plastikpamaro/bachelorprojekt2020/Codes/Studienarbeit(Max)/RASPI/Backup 02-14/bcm2835-1.62/README

This is a C library for Raspberry Pi (RPi). It provides access to 
GPIO and other IO functions on the Broadcom BCM 2835 chip.
allowing access to the 
26 pin ISE plug on the RPi board so you can control and interface with various
external devices.
