plastikpamaro/bachelorprojekt2020/Dokumentation/titlepage.tex

% Titelseite    
\newpage
\thispagestyle{empty}
\AddToShipoutPicture*{\BackgroundPic}

\newgeometry{top=0.6cm, bottom=2.04cm, left=2.24cm, right=2.24cm}

\begin{center}

\begin{tabular}{p{3cm}p{8cm}p{4cm}}
&\textcolor{red}{\LARGE{ }} & \vspace{-0.5cm} \\
\end{tabular}

\begin{tabular}{p{5cm}p{10.5cm}}
&\\
&\\
\end{tabular}

\end{center}

\vspace{7cm}

\begin{flushright}
\begin{Huge}
\textbf{Dokumentation Bachelorprojekt} \\
\end{Huge}
\vspace{2cm}
\Large{Heiko Nöldeke, Marc Bolsch, Pascal Roschkowski, Philipp Otto} \\
\vspace{0.5cm}
\LARGE{\textbf{Entwurf und Ausarbeitung eines \\ Traffic-Noise-Detector-Prototypen}}
\end{flushright}
\vspace{8cm}

\begin{center}
\begin{tabular}{lp{2cm}r}
Fakultät Technik und Informatik && Faculty of Engineering and Computer Science \\
Departement Mechatronik && Departement of Mechatronic Engineering \\
\end{tabular}
\end{center}

\newpage
\restoregeometry

\ClearShipoutPicture
