plastikpamaro/bachelorprojekt2020/Dokumentation/impressum.tex

\thispagestyle{empty}
\newgeometry{top=6cm, bottom=2.04cm, left=2.24cm, right=2.24cm}

\begin{center}
\Large{\textbf{Heiko Nöldeke, Marc Bolsch, Pascal Roschkowski, Philipp Otto}} \\  
\vspace{1.5cm}
\LARGE{\textbf{Traffic-Noise-Detector-Prototyp}}
\end{center}

\vspace{14cm}

\begin{tabular}{l}
Bachelorprojekt eingereicht im Rahmen der Bachelorprüfung \\
\\
im Studiengang Mechatronik \\
am Departement Fahrzeugtechnik und Flugzeugbau \\
der Fakultät Technik und Informatik \\
der Hochschule für Angewandte Wissenschaften Hamburg\\
\\
Erstprüfer: Prof. Dr. Rasmus Rettig\\
\\
Abgabedatum: \today
\end{tabular}

\newpage
\restoregeometry
