plastikpamaro/bachelorprojekt2020/Dokumentation/Sections/Programmierung/Programmierung.tex

\section{Programmierung}

\subsection{Beweisführung}

Da ist sich bei dem von uns entwickeltem System um einen Prototypen für ein nutzbaren TND handelt, hat eine aussagekräftige Beweisführung der Geräusch-Lokalisierungen eine hohe Priorität. Zum Vorbild genommen wurden dafür herkömmliche Blitzeranlagen aus dem Straßenverkehr, bei denen ein Beweisfoto aufgenommen wird und Metadaten über die gemessene Geschwindigkeit abgespeichert und übermittelt werden.

Das eigentliche Foto wird mithilfe eines \glqq Raspberry Pi 4\grqq\ Kameramodul aufgenommen, bearbeitet und mit einem Zeitstempel versehen abgespeichert. 

Der hierzu verwendete Programmablauf lässt sich folgendermaßen beschreiben: 

\begin{figure}[!h]
	\begin{center}
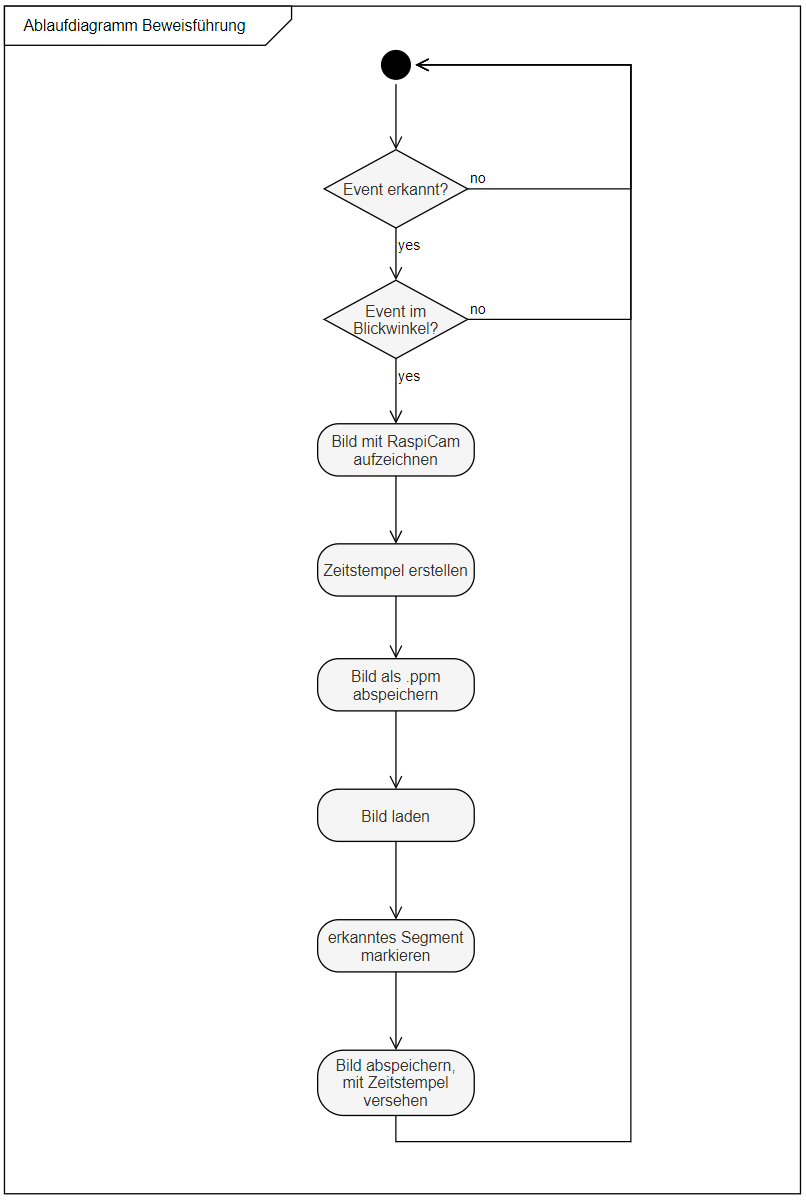
[picture p1: Dokumentation/Sections/Programmierung/Beweisführung.png]
		
	\end{center}
	\caption{Beweisführung}
	\label{fig:Beweisführung}
\end{figure}

Die Beweisführung startet, wenn ein definierter Pegel überschritten wird und die Quelle des Geräusches ermittelt wurde. Da die Kamera nur einen Betrachtungswinkel von \ang{60} aufweist, wird nun überprüft, ob sich die Quelle innerhalb des Betrachtungswinkels, also innerhalb des Kamerabildes befindet\footnote{https://www.raspberrypi.org/documentation/hardware/camera/ zuletzt besucht: 05. 06. 21}.

Ist dem der Fall, so wird ein Kamerabild aufgezeichnet und ein Zeitstempel erstellt. Um die Komplexität des Systems möglichst gering halten zu können, wird die Kameraansteuerung direkt in dem Hauptprogramm mithilfe einer Wrapper-Klasse realisiert. 

Diese nutzt die \glqq RaspiCam: C++ API\grqq\ von Rafael Muñoz Salinas, um die Hardware direkt in dem Programmablauf ansteuern zu können\footnote{https://www.uco.es/investiga/grupos/ava/node/40 zuletzt besucht: 05. 06. 21}. Dies erspart die zusätzliche Verwendung von Unterprogrammen. Das nun aufgezeichnete Bild wird zunächst als \glqq .ppm\grqq\ abgespeichert. 

In dem nächsten Schritt wird das abgespeicherte Bild wieder geöffnet und mit der Bildverarbeitungsbibliothek \glqq OpenCv\grqq\ bearbeitet\footnote{https://opencv.org/about/ zuletzt besucht: 05. 06. 21}. Dieser Schritt wird durchgeführt, um die errechneten Quellkoordinaten des Geräusches grafisch darzustellen. Hierbei wird das Bild in eine vorher definierte Anzahl von Segmenten (maximal 60, hier: 7) unterteilt. Die rechnerisch ermittelte Gradzahl der Quelle des Geräusches wird nun auf ein Segment im Bild bezogen. Dieses wird entsprechend farblich mit einem grünen, gut sichtbaren Rechteck markiert.

Im Anschluss wird das bearbeite Bild in einem für Windows-Betriebssysteme einfach zu lesendes Format (.png) abgespeichert. Der zu Beginn der Beweisführung aufgezeichnete Zeitstempel wird nun als Dateiname verwendet.

Die Beweisführung enthält somit: ein Foto des Fahrzeugs, ein markiertes Segment, in dem sich die Quelle des Geräusches befindet und ein Zeitstempel zu welchem Datum und Uhrzeit das Fahrzeug aufgezeichnet wurde. Wahlweise können darüber hinaus auch sämtliche, sich im Buffer befindlichen Daten, die zur Lokalisierung des Geräusches verwendet wurden in Tabellenform abgespeichert werden. Da es sich hierbei aber bei einem längeren Betrieb um erhebliche Datenmengen handelt, die den internen Speicher des \glqq Raspberry Pi\grqq\ belegen würden, wurde darauf bisher verzichtet. 

\subsection{Programmablauf}

Der Programmablauf wird in diesem Abschnitt Schritt für Schritt erklärt und anhand geeigneter Diagramme dargestellt. Zu einer genauen Übersicht des Ablaufes ist der Flowchart des Programmes (\autoref{fig:MainFlowchart}) hilfreich. Nun folgt eine chronologische Erklärung der Programmteile.

\begin{figure}[!h]
	\begin{center}
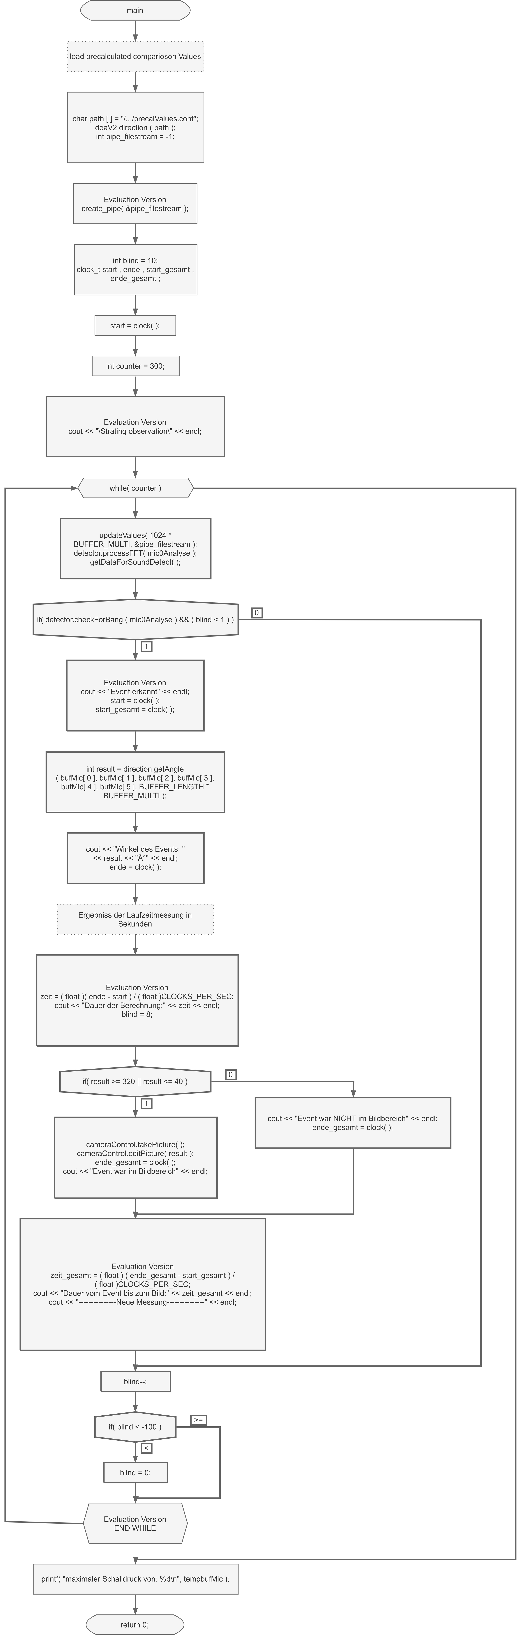
[picture p2: Dokumentation/Sections/Programmierung/MainFlowchart.png]
		
	\end{center}
	\caption{Main Flowchart}
	\label{fig:MainFlowchart}
\end{figure}

\subsubsection{doaV2}

Nach dem Programmaufruf wird die DOA Konfiguration, bestehend aus vorberechneten Werten, ausgelesen. Dies wird durch die doaV2 Klasse mithilfe der loadPrecalculatedValues Methode ermöglicht (\autoref{fig:doav2}).

Hier wird zunächst die Konfigurationsdatei geöffnet. Nun werden für alle möglichen Mikrofonpaare alle vorberechneten Laufzeiten aller möglichen Winkel eingelesen und in das Array precalculatedCompareValues abgespeichert. Zuletzt wird der Zugriff auf die Datei gestoppt. Die DOA Klasse beinhaltet auch die Berechnung des Ursprungsortes eines Geräusches, auf die im späteren Programmverlauf weiter eingegangen wird.

\begin{figure}[!h]
	\begin{center}
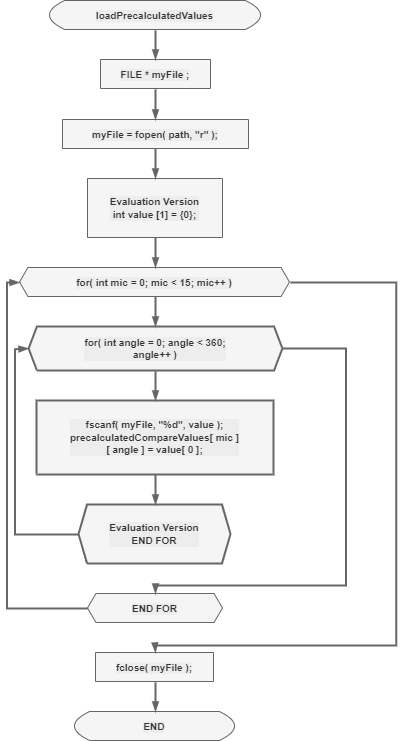
[picture p3: Dokumentation/Sections/Programmierung/doav2.png]
		
	\end{center}
	\caption{doav2}
	\label{fig:doav2}
\end{figure}

\subsubsection{create\_pipe}

Nach dem Laden der Laufzeiten wird mithilfe der create\_pipe Methode ein FIFO angelegt, mit dem die Echtzeitmessungen zur Datenverarbeitung weitergegeben werden.

\subsubsection{updateValues}

Diese Methode stellt sicher, dass der Daten-Buffer nach jedem FIFO Zyklus neu gefüllt ist. Die Methode bestimmt zuerst das Maximum an gemessenen Werten aus einem Zyklus und schreibt sie dann mithilfe der fastAddValue Methode im Signed UInt32 Format in den Speicher.

\subsubsection{processFFT}

Eine einfache \glqq Fast Fourier Transformation\grqq, die ein Array an komplexen Gleitkommazahlen ausgibt. Mithilfe dieser Fouriertransformation ist es möglich, die Intensität der Geräusche von der zwischengespeicherten Aufnahme herauszufinden, um diese zu vergleichen.

\subsubsection{getDataForSoundDetect}

Im Programmablauf folgt diese einfache Getter-Methode, um die gepufferten Daten aus dem FIFO zur Weiterverarbeitung in ein Array zu schieben.

\subsubsection{checkForBang}

Die checkForBang Methode ist eine der wichtigsten im gesamten Programmablauf und sitzt direkt in einer Bedingung. Wenn durch diese Methode ein lautes Signal bestätigt wird, fährt das Programm in der Verarbeitung dieses Signales fort.

Wie in \autoref{fig:checkForBang} zu erkennen ist, wird anfangs mithilfe der calcEnergy Methode aus derselben Klasse der Unterschied zwischen den Energieniveaus von Geräuschen ausgerechnet. Dies geschieht durch die schon erwähnte FFT. Wenn nun die errechnete Differenz den Wert 600000 (empirisch ermittelt) überschreitet, kann davon ausgegangen werden, dass ein lautes und beobachtungswertes Event stattgefunden hat, da eine sehr hohe Energiedifferenz zu vorherigen Werten gemessen wurde.

\begin{figure}[!h]
	\begin{center}
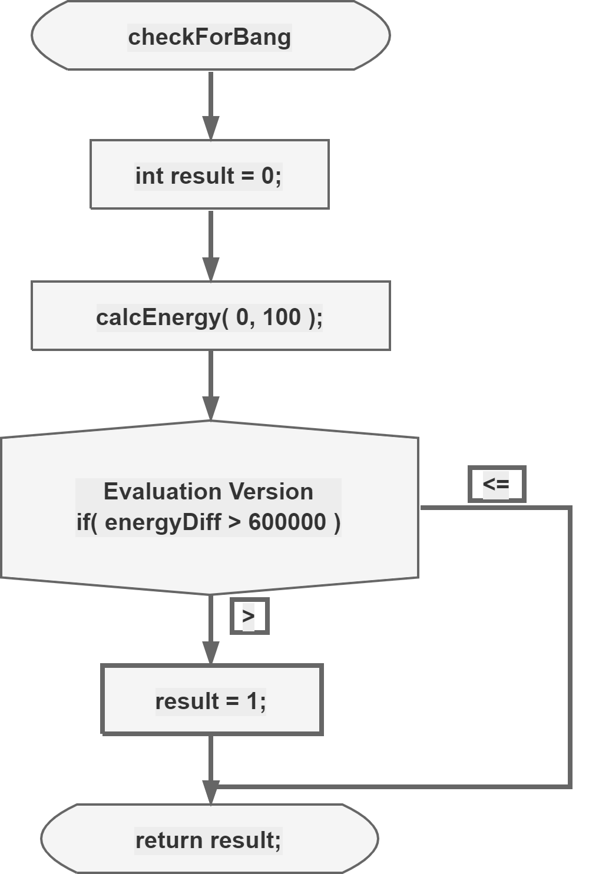
[picture p4: Dokumentation/Sections/Programmierung/checkForBang.png]
		
	\end{center}
	\caption{check for bang}
	\label{fig:checkForBang}
\end{figure}

\subsubsection{getAngle}

Diese Methode ist dafür verantwortlich, dem Geräuschevent eine eindeutige Richtung zuzuordnen, um eine Beweisführung zu ermöglichen. Sie ruft zwei weitere wichtige Methoden auf – xcorr und compareValues.

Mithilfe der vorberechneten Korrelationswerte für das Mikrofonarray kann die xcorr Methode verwendet werden, um die Korrelation zweier Signale zu finden.

Mit compareValues werden die Korrelationen verglichen und mit einer einfachen Sortierung die stärksten Übereinstimmungen gefunden, um daraus eine Richtung zu erschließen.

Mehr dazu im Abschnitt des Protokolls, dass auf die Berechnung des Winkels näher eingeht.

\subsubsection{cameraControl}

Die Klasse cameraControl benutzt, wenn sich der errechnete Winkel im richtigen Sichtfeld der Kamera befindet, zwei Methoden, um ein Foto zu erstellen und dies so zu bearbeiten, dass der Bereich der Schallquelle sichtbar wird. Mithilfe der einfachen Schnittstelle der RaspiCam und dazugehörigen Bibliotheken wird ein Bild im RGB-Format von der Kamera angefordert und abgespeichert. Nun wird mithilfe des errechneten Ergebnisses aus getAngle und OpenCV das Bild bearbeitet, indem durch mehrere else-if-Abfragen zum richtigen Bildsegment iteriert wird und dann dieses Segment mit einem Rechteck hervorgehoben wird.

\subsection{Ortung der Geräuschquelle}

Das Orten einer Schallquelle ist im Gegensatz zum Erfassen eines lauten Geräusches deutlich umfangreicher. Hierzu wird die Kreuzkorrelation zwischen allen Mikrofonen untereinander errechnet um diese als Hilfe zu benutzen, um das mathematische Maximum zu berechnen.

Die Kreuzkorrelation ist eine Messung, die die Bewegungen von zwei oder mehr Sätzen von Zeitreihen-Daten relativ zueinander verfolgt. Sie wird verwendet, um mehrere Zeitreihen zu vergleichen und objektiv zu bestimmen, wie gut sie miteinander übereinstimmen und insbesondere, an welchem Punkt die beste Übereinstimmung auftritt. Die Kreuzkorrelation kann auch jegliche Regelmäßigkeiten in den Daten aufdecken.

Betrachten wir als Beispiel zwei reellwertige Funktionen $ f $ und $ g $, die sich nur durch eine unbekannte Verschiebung entlang der x-Achse unterscheiden. Man kann die Kreuzkorrelation verwenden, um herauszufinden, um wie viel $ g $ entlang der x-Achse verschoben werden muss, damit es mit $ f $ identisch wird. Die Formel verschiebt im Wesentlichen die Funktion $ g $ entlang der x-Achse, wobei das Integral ihres Produkts an jeder Position berechnet wird. Wenn die Funktionen übereinstimmen, wird der Wert von ($ f \star g $) maximiert. Das liegt daran, dass Spitzen (positive Bereiche), wenn sie übereinstimmen, einen großen Beitrag zum Integral leisten. Ähnlich verhält es sich, wenn sich Talsohlen (negative Bereiche) ausrichten, leisten sie ebenfalls einen positiven Beitrag zum Integral, da das Produkt zweier negativer Zahlen positiv ist. Bei komplexwertigen Funktionen $ f $ und $ g $ stellt die Konjugierte von $ f $ sicher, dass ausgerichtete Spitzen (oder ausgerichtete Talsohlen) mit imaginären Komponenten positiv zum Integral beitragen.

Kreuzkorrelationen sind nützlich für die Bestimmung der Zeitverzögerung zwischen zwei Signalen, z. B. für die Bestimmung von Zeitverzögerungen für die Ausbreitung von akustischen Signalen über ein Mikrofonarray. Nach der Berechnung der Kreuzkorrelation zwischen den beiden Signalen zeigt das Maximum (oder Minimum, wenn die Signale negativ korreliert sind) der Kreuzkorrelationsfunktion den Zeitpunkt an, an dem die Signale am besten ausgerichtet sind; d. h., die Zeitverzögerung zwischen den beiden Signalen wird durch das Argument des Maximums die Kreuzkorrelation bestimmt. Diese mathematische Eigenschaft benutzen wir um mit
$ \tau= arg\ _{t \in \mathbb{R}}\ max\left(( f \star g)(t)\right) $ den zeitlichen Versatz zu errechnen.

Im vorliegenden Fall werden diese Maxima initial in Abhängigkeit der geometrischen Form des Mikrofonarray ausgerechnet. Damit wird in der \textit{xcorr} Methode die maximale Latenz zwischen jeder möglichen Mikrofonpaarung ausgerechnet und diese dann in der compareValues Methode miteinander verglichen. Diese Methode vergleicht nun alle gemessenen Verzögerungen mit den vorher ausgerechneten Verzögerungen, und zwar für jeden möglichen Winkel. Der Winkelbereich mit den größten Übereinstimmungen über alle Mikrofonpaarung, kann mit Sicherheit als der Bereich gekennzeichnet werden, aus dem das Geräusch kommt.

\newpage
