plastikpamaro/bachelorprojekt2020/21-02-19-Kickoff/Studienarbeit/uC Code/MSM_TDM/documents/latex/Anhang-LAPTOP-SEQVLDEN.tex

% !TEX encoding = UTF-8 Unicode
% !TEX spellcheck = de_DE

\section{Anhang}\label{sec:Anhang}

%\lstinputlisting[style=styleNP, caption={spi\_interface}, label={lst:spi_interface}]{../../Multiprocess_datahandling/spi_interface/main_minimal.c}
