plastikpamaro/bachelorprojekt2020/Sitzungen/20-12-14 BP Besprechung.docx

BP Besprechung 14. 12. 2020

Frage:

- Wo sind die CAD Modelle der Mikrophone?
- In wie weit müssen wir die IP-Schutzklasse einhalten?
- Wofür steht LRCLK SYNC? Neuer Sendezyklus Datenblatt aus TDM LEFT RIGHT CLOCK
- Wofür steht BCLK? SPI Clock, BitClock
- Wofür steht DATA MISO: Daten MasterInputSlaveOutput

Zeilennummer, Zeitstempel 1.1.1970

Zeile 1 Zeitstempel seit 1.1.1970

Daten, Daten Uint32 aber 24 bit signed Werte, Zeit

Messwert (Samplewert vom Audio)

Pipe Kommunikation zwischen zwei Programmen

Ringbuffer der SPI deswegen die ersten Werte bei 0

Sorgfältig arbeiten beim Crimpen morgen

Bestellnummern erfragen der Terminals und Stecker!!!!!!!

Soundwave aktuelle nicht kalibrierter Pegel

Definierten Pegel festlegen 94dB

Python Skript. Entwicklung → Python → Data convert to Py: TCP datenübertragung. Dev convert

Soundsc matlab 24kHz

PW HAW 2020

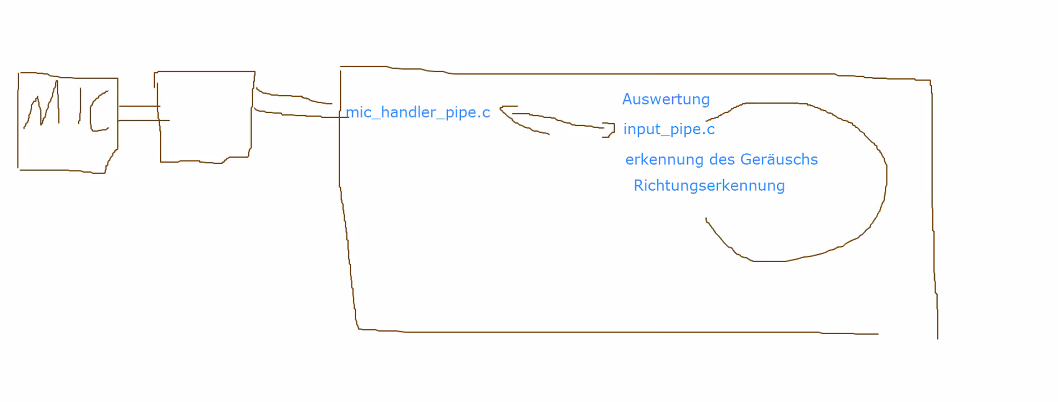
[picture p10: figure]
