plastikpamaro/bachelorprojekt2020/Dokumentenschleuse/Farbcodierung Microphonkabel.docx

Farbe | Verwendung | Nummer am Stecker | Pin am Raspberry
Schwarz | Masse / Ground | 2 | GND
Weiß | 5V DC | 7 | 5V
Braun | BCLK | 6 | 21
Blau | DATA MISO | 3 | 23
Grau | LRCLK SYNC | 1 | 40

Erfahrungswerte Stecker an Kabel anbringen:

- Steckerwiderhaken brechen sehr leicht (entweder Material sehr spröde oder Weichmacher bereits ausgedampft)
- Löten nur mit gutem und sehr spitzem Lötkolben zu empfehlen
- Stecker crimpen?!
- Adern zusammenlöten/ Aderendhülsen verwenden. Vielleicht abisolieren, Aderendhülse, Stiftkontakt, Stecker
- Sehr wenig Platz, Gefahr eines Kurzschlusses
- Weiters Vorgehen: Teile kaufen!!!! Neu versuchen
