plastikpamaro/bachelorprojekt2020/21-02-19-Kickoff/Studienarbeit/uC Code/MSM_TDM/documents/MSB_V2_1_schematic.pdf

## MEMS digital output motion sensor: ultra-low-power high-performance three-axis "nano" accelerometer Atmel® | SMART ARM® Cortex®-M4 - based Flash MCU SAM G55

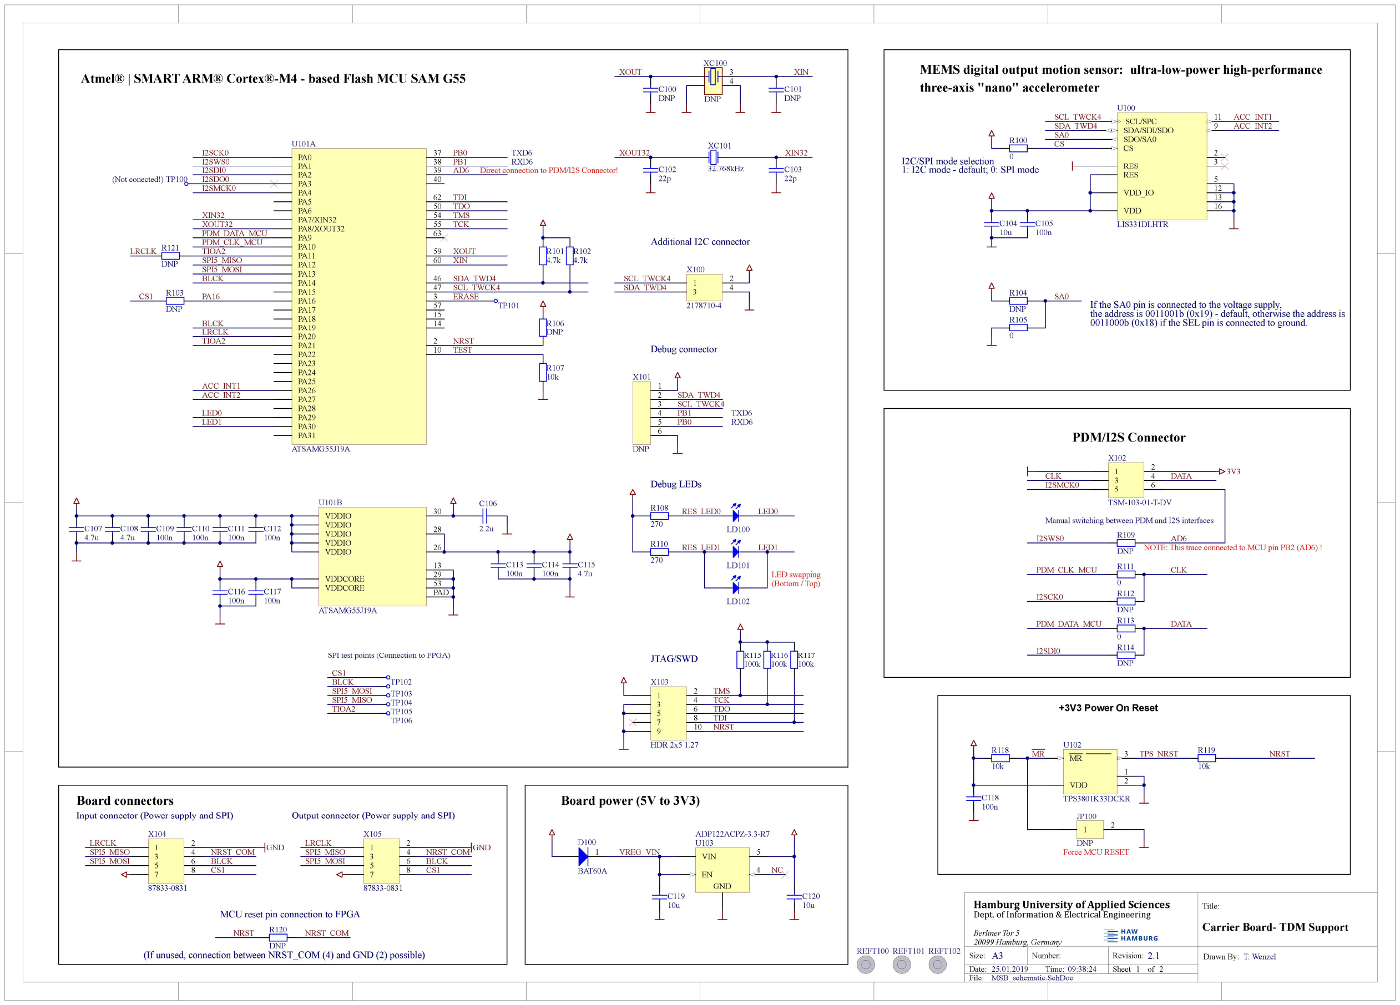
[picture p15: page 1]

1

## Hamburg University of Applied Sciences

### Dept. of Information & Electrical Engineering

Berliner Tor 5
20099 Hamburg, Germany

2

## Carrier Board- TDM Support

2.1
25.01.2019 09:38:24
MSB_schematic.SchDoc

Title:

Size: | Number:
Date:
File:

Revision:
Time: | Sheet | of
A3 | Drawn By: T. Wenzel

NRST

SDA_TWD4

SCL_TWCK4

RES_LED0

TMS
TCK

TDO

PDM_DATA_MCU
PDM_CLK_MCU

PA1
PA2
PA3
PA4
PA5
PA6
PA7/XIN32
PA8/XOUT32
PA9
PA10
PA11
PA12
PA13
PA14
PA15
PA16
PA17
PA18
PA19
PA20
PA21
PA22
PA23
PA24
PA25
PA26
PA27
PA28
PA29
PA30

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
PA0 | 37

10

63

PA31

U101A

ATSAMG55J19A

VDDIO

VDDCORE

26

VDDIO | 28
| 30

13

VDDIO
VDDIO

VDDCORE

VDDIO

29
53
PAD

U101B

ATSAMG55J19A

CS

ACC_INT1
ACC_INT2

SA0

SA0

If the SA0 pin is connected to the voltage supply,

### the address is 0011001b (0x19) - default, otherwise the address is

0011000b (0x18) if the SEL pin is connected to ground.

ACC_INT1
ACC_INT2

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
X103

HDR 2x5 1.27

### JTAG/SWD

TMS
TCK
TDO
TDI
NRST

SPI5_MISO

BLCK

SPI5_MOSI

I2SWS0

I2SCK0

I2SDO0
I2SMCK0

LED0
LED1

LED0

### Debug LEDs

TDI

LD100

LD101

RES_LED1 | LED1

1
3
5

2
4
6

X102

TSM-103-01-T-DV

PDM_DATA_MCU

PDM_CLK_MCU

3V3

SDA_TWD4
SCL_TWCK4

TEST

R111
0
R112
DNP
R113
0
R114
DNP

## PDM/I2S Connector

CLK

DATA

CLK | DATA

I2SWS0

I2SCK0

I2SMCK0

1

3

2

4
5
6

X101

DNP

### Debug connector

DNP

3
4

XC100

XOUT
XIN
XOUT | XIN

GND

VIN
EN | 4
| 5

U103

ADP122ACPZ-3.3-R7

SPI5_MOSI

SPI5_MISO
BLCK
CS1

GND

Input connector (Power supply and SPI) | Output connector (Power supply and SPI)

NC

LRCLK

Board connectors | Board power (5V to 3V3)

C105
100n

C107
4.7u

C115
4.7u

R108
270

R110
270

R101
4.7k

R102
4.7k

R115
100k

R116
100k

R117
100k

R104
DNP
R105
0

C109
100n

C110
100n

C111
100n

C112
100n

C116
100n

C117
100n

C113
100n

C114
100n

R107
10k

SDA_TWD4
SCL_TWCK4

REFT100 REFT101 REFT102

1
2

3

VDD

MR

U102

TPS3801K33DCKR

### +3V3 Power On Reset

R118
10k

R119
10k

R106
DNP
MR | TPS_NRST | NRST

C100
DNP

C119
10u

C120
10u

C101
DNP

PB0
PB1

PB0

PB1

SPI5_MOSI
SPI5_MISO

BLCK

CS1

TIOA2

TP102
TP103
TP104
TP105
TP106

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
X104

87833-0831

SPI5_MOSI

SPI5_MISO
BLCK
CS1
GND LRCLK | 1
3
5
7

2
4
6
8

X105

87833-0831

1

2

JP100

DNP
Force MCU RESET

TP101

ERASE

I2SDI0

1
3

2
4

X100

2178710-4

SDA_TWD4

SCL_TWCK4

C108
4.7u

TXD6
RXD6

Manual switching between PDM and I2S interfaces

SPI test points (Connection to FPGA)

TXD6
RXD6

### Additional I2C connector

R100
0

### I2C/SPI mode selection

NRST_COM

NRST

NRST_COM

R120 NRST_COM
DNP

C106

2.2u

RES
12

SDA/SDI/SDO
SDO/SA0

VDD_IO
16

5

RES

11

VDD

SCL/SPC | 9

CS

13

2
3

U100

LIS331DLHTR

### 1: I2C mode - default; 0: SPI mode

C104
10u

I2SDI0

XC101

32.768kHz

XOUT32 | XIN32

C102
22p
| C103 22p

XOUT32

XIN32

LD102

LED swapping
(Bottom / Top)

AD6

AD6 R109
DNP NOTE: This trace connected to MCU pin PB2 (AD6) !

Direct connection to PDM/I2S Connector!

CS1 | PA16

C118
100n

R103
DNP

TP100

### MCU reset pin connection to FPGA

### (If unused, connection between NRST_COM (4) and GND (2) possible)

(Not conected!)

1

D100

BAT60A

VREG_VIN

BLCK
LRCLK
TIOA2

R121
DNP
LRCLK | TIOA2
