plastikpamaro/bachelorprojekt2020/Dokumentenschleuse/Doku_Heiko/BP Überarbeitung Heiko.pdf

5 | Programmierung
5.0.1 | Beweisführung
Da | ist | sich bei | | dem von | | uns | entwickeltem | System um einen | | | Prototyp | für ein nutzbaren | TDN han-
delt, | hat | eine | aussagekräftige Beweisführung der | | | Geräusch-Lokalisierungen eine | | | hohe Priorität.
Zum | Vorbild | genommen | wurden | dafür | herkömmliche | „Blitzer', | bei | denen | ein | _Beweisfoto aufge-
nommen | wircl und | | Metadaten | über | die gelnesscne Geschwindigkeit abgespeichert | | | | und iibermittelt
werden.
Das | eigentliche Foto wird | rnithilfe | eines | Raspberry | Pi | Kameramoclul aufgenommen, bearbeitet
und | Init einem Zeitstempel versehen abgespeichert.
Der | hierzu verwendete Programmablauf lässt | | sich folgendermaßen beschreiben:
Die | Beweisführung startet, | wenn ein | | definierter Pegel überschritten wird und | | | die | Quelle des
Geräusches ermittelt | wurde. | Da | die | Kamera | nur | einen | Betrachtungswinkel von | 670 aufweist,
wird | nun | überprüft, | ob | sich | die | Quelle innerhalb | | des | Betrachtungswinkels, also innerhalb | | | des
Katncral)ildes | | befindet, l .
Ist | dem der Fall, so wird ein Kamerabild aufgezeichnet und cin Zeitstcmpcl erstellt. Um dic
Komplexität | des | Systems | möglichst | gering halten | | zu können | | wird | die Kameraansteuerung | | direkt
in | dem Hauptprogramm mithilfe | | | einer Wrapper | | | asse realisiert.
Diese nutzt | | die | „RaspiCam: C++ | | API" | von | Rafael | NIufioz Salinas, um | | | die Hardware direkt
in | dem Programmablauf ansteuern zu können . | | | | | | Dies erspart diekøusätzliche Verwendung von
Unterprogrammen. | Das | nun | aufgezeichnete Bild wird | | | zullächst als „.pprn" abgespeichert.
In | dem nächsten Schritt wird das abgespeicherte Bild wieder geöffnet und mit | | | | | | | | | | | | der Bildverar-
beitungsbibliothek | | „OpenCv" bearbeitet | | 3 . Dieser | | Schritt | wird | durchgeführt, | um
Quellkoordinaten | des | Geräusches grafisch darzustellen. Hierbei wird das | | | | | | Bild in | | eine vorher de-
finierte Anzahl von Segmenten | | | | maximal 70) unterteilt. | | | Die rechnerisch ermittelte | | | Gradzahl der
Quelle des Geräusches wird | | | | nun | au | | ein | Segment im | | Bild bezogen. Dieses wird entsprechend
farblich mit | | einem grünen, | | gut | sichtbaren Rechteck markiert.
Im | Anschluss wird das bearbeite | | | | Bild in | | einem für Windows-Betriebssysteme einfach zu lesendes
Format | abgespeichert. Der zu Beginn der Beweisführung aufgezeichnete Zeitstempel wird nun
als Dateiname | | verwendet.
Die Beweisführung enthält | | | | somit: ein Foto des Fahrzeugs, ein markiertes Segment, in dem sich
die | Quelle des | | Geräusches befindet und | | | ein | Zeitstempel zu | | welchem Datum | | und | Uhrzeit das
Fahrzeug | aufgezeichnet | wurde. | Wahlweise können | | darüber | hinaus | auch | sämtliche, | sich im | | Buffer
befindlichen | Date, | die | zur | Lokalisierung des | | Geräusches verwendet | | wurden | in | Tabellenform abge-
speichert werden. Da es sich hierbei aber bei einem längeren Betrieb um erhebliche Datenmengen
handeln | würde, | die | den | internen | Speicher des Raspberry | belegen würden, | wurde darauf bisher
verzichtet.
5.1 | Programmablauf
Der Programmablauf wird | in | diesem Abschnitt | Schritt | für | Schritt | erklärt | und | anhand geeig-
neter | Diagramme dargestellt. Zu | einer genauen Übersicht des Ablaufes ist | der | Flowchart des
Programmes | (??) | hilfreich. Nun | .ine chronologische Erklärung | der Prograuunteile.
5.1.1 | doaV2
Nach dem Programmaufruf wird die DOA Konfiguration, bestehend | aus vorberechneten Werteny
ausgelesen. | Dies | wird | durch | die | doaV2 Klasse mithilfe | der | IoadPrecalculatedValues Methode

ermöglicht

I https://www.raspberrypi.org/docutnentntion/harclware/camera/Zhttps://www.ucß).es/investiga/grupos/ava/node/'i() 3https://opencv.org/about,/

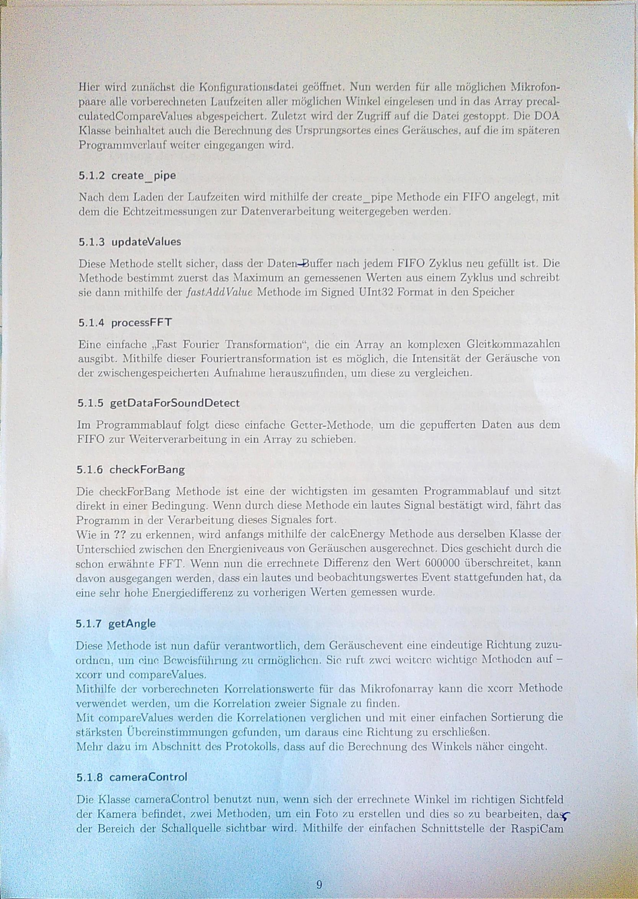
[picture p27: page 2]

flier | wird | zunächst | (lie | geöffnet, | Nun | werden | fiir | allc | möglichen | Mikrofon-
paare, alle | | Laufzeiten | aller | möglichen | Winkel | cingelosen | und | in | das | Array | precal-
culateclCornpareValues abgespeichelt. | Zuletzt | wird | der | Zugriff nuf die | | | Datei | gestoppt, | Die DOA
Klasse. beinhaltet | auch | die | Berechnung | des | Ursprungsortes | eines | Geräusches, | auf die | | im späteren
Programmverlm.lf' weiter | cingcgangcn | wird.
5.1.2 | create | Pipe
Nach | (Icm Laden | der | Laufzeiten | wird | mithilfe | der | creatc_pipe | Methode | ein | F IFO | angelegt, | mit
dem | die | Echtzeit,messungen zur | Datenverarbeitung | weitergegeben | werden.
5.1.3 | updateValues
Diese Methode | stellt | sicher, dass der | Dateruuffer | nach jedem | FIFO | Zyklus neu | gefüllt | ist. | Die
Methode bestimmt zuerst das | | | Maxirnurn an | gernessenen Werten aus einem Zyklus und schreibt
sie dann | mithilfe | der | fastAddValue Methode | im Signed UInt32 Format | in | den | Speicher

### 5.1.4 processFFT

Eine | einfache „Fast Fourier Transformation", dic | | | | cin | Array | an | komplexen Gleitkornmazahlcn
ausgibt. | Mithilfe dieser Fouriertransformation ist | | | es | möglich, die Intensität | | | der | Geräusche von
der | zwischengespeicheffen Aufnahme | herauszufinden, | um | diese zu | | vergleichen.

### 5.1.5 getDataForSoundDetect

Im | Programmablauf folgt diese einfachc Gctter-Methocle, um | | | dic gepufferten Daten | aus | dem
FIFO | | zur Weiterverarbeitung in | ein Array zu schieben.
5.1.6 | checkForBang
Die | checkForBang Methode ist | | | eine der | | wichtigsten im | | gesamten Programmablauf und | | | sitzt
direkt | in einer | | Bedingung. | Wenn durch | | diese Methode | | ein lautes | | Signal bestätigt | | wird, | fährt | das
Programm | in | der | Verarbeitung | dieses | Signales fort.
Wie | in | ?? | zu | erkennen, | wird | anfangs | mithilfe | der | calcEnergy Methode | | aus | derselben | Klasse der
Unterschied | zwischen | den | Energicnivcaus | von | Geräuschen | ausgerechnet. | Dies geschieht | | durch | die
schon envähnte | | FFT. | | Wenn nun | | die | errechnet,e Differenz den Wert. 600000 überschreitet, kann
davon ausgegangen werden, | | | dass ein lautes | | | und | beobachtungswertes Event | | stattgefunden | hat, | da
eine | sehr | hohe | Energiedifferenz | zu | vorherigen | Werten | gemessen | wurde.

### 5.1.7 getAngle

Diese Methode | | ist | nun | dafür | verantwortlich, | dem | Geräuschevent | eine | eindeutige | Richtung zuzu-
ordnen, | um | einc | Boweisfiihrung zu | | ermöglichen. | Sic ruft, zwei weit,erc wicht,igc Methoden | | | | | | auf —
xcorr | und | compareValues.
Mithilfe der | | vorberechnetcn Korrelationswcrtc für | | | das | Mikrofonarray kann | | die | xcorr Methode
verwendet | werden, | um | die | Korrelation | zweier Signale zu | | | finden.
Mit | compareValues | werden | die | Korrelationen | verglichen | und | mit | einer | einfachen | Sortierung | die
stärksten | Cbereinstimmungcn | gcfundcn, | um | daraus | eine | Richtung | zu | erschließen.
Mehr | dazu 'im Abschnitt | | | des | Protokolls, | dass | auf die | | Berechnung | des | Winkels | näher | cingcht.
5.1.8 | cameraControl
Die | Klasse | carneraControl | benutzt | nun, | wenn | sich | der | errechnete | Winkel | in) | richtigen | Sichtfeld
der Kamera befindet, zwei Methoden/ um ein Foto zu erstellen und dies so zu bearbeiten, daf
der | Bereich der | Schallquelle sichtbar wircL Mithilfe der | einfachen Schnittstelle der | RaspiCam

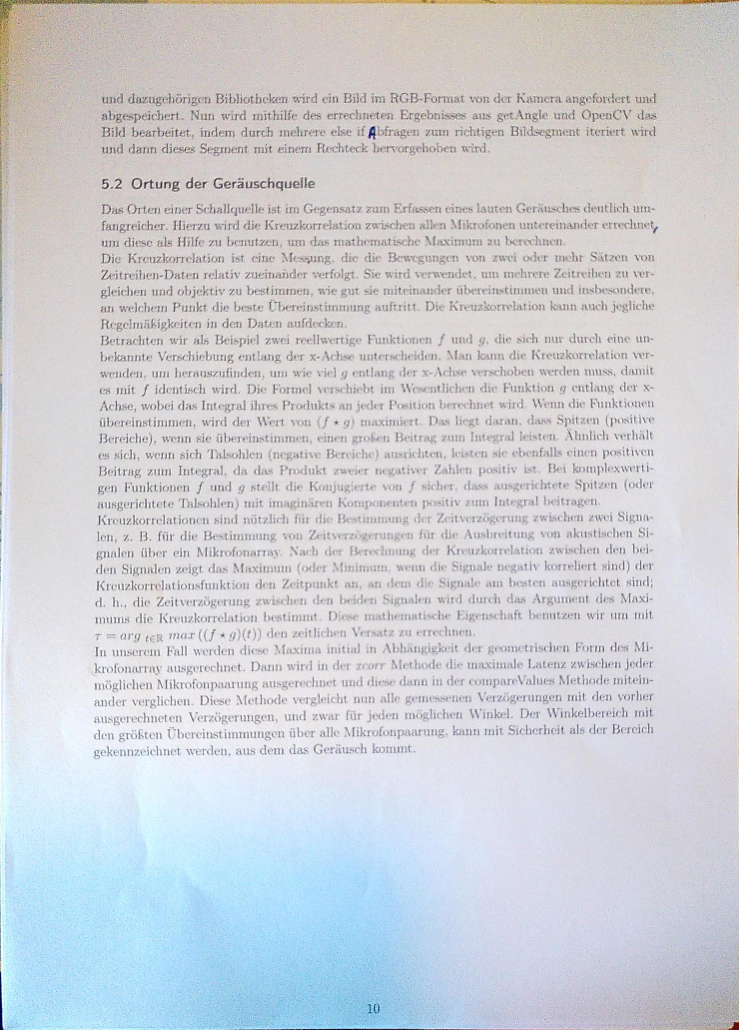
[picture p28: page 3]

dazugeljörigen | Bibliothekefi v:ird | | citi Bild im | | | RGB•Fot11tat von der | | | Kamera | angefot'dett | und
obgespeicbert. Nun | | wircl mithilfe | | des | | Ergebni+ens aus | | getAngie und | | OpenCV das
T3iJ(l bearbeitet, | | | | indem | durcb | tnelareve else | if Abfragen | | 7.tan ric.•htigen Bildsegtneut | | | iteriert | wird
und | dam | dieses | Segrncnt, | | Rechteck bervorg€•ii€bbeta
5.2 | Ortung | der Geräuschquelle
Das | einer | Schallquei)e isi | irn Gegers.satz, | F.rfassen | lauten | dentlieh | utn-
fangreicher. | JJierzu wird | die Krcü7.korrelati0ii | utitcretnantier | errechnett
um dicsc als | | Ililfe Zu bcnut7eem um das mathematische
Dic | Krcuzkorrclation ist | cine | die | Z%Vi | tnehr | Sat"'tt | von
Zeitrei)T'J1-Dafen Jcjat.5v zncinai)der | verffdgg. | Sic | 7.citreihen | ?.tt ver-
gleichen | | objcktiv | zu | bestijnmen. | wic gut | sie suiteinancier iibeseinstirutueu | | | insbesondete,
an | welchcjn | P unkt | | die | best,c | auf? titt- | Die | Kreuzkonvlation | | kq,ntt anch jegliche
Rcgelmäßigkcitcn | in
Betrachtcn | wir | als | Ibeispicl 7,wci reellvc(ftigq• | f | utvl | steh | clutch eiue | uti-
l.ckmjnte | Vcrsc•hieljung cntlaJjg der | kann | Vs-tettzkorrelation
wenden, | herausz1Jfindcn, | wie | vign
es | Init | f | identisch | wild. | Dio | ;nel | hic)$t it;)
Achse, | wobei ()as Integt41) | Pi | an
wird | de)' | •con (f | •
Bereic)je), | | sic
sic)), | wcjJJ1 Sich
gen | | f | tsteiiv
tillsgerichfete | Tajsohlen)
| | | hi:
ion, | Z. | B, | fiir | die | Beyt
gnalen | liber | ein
den | Signalen zeigt | (ode; | dic
Kronzkorrelat
die | Zeit verzögerung
tntnjjs | (lie | Kreuzlu irrelat ion | .
T = arg | tna:r ((f | den
In | unserclil | Fall | werd€•n diese | initial
krofonarray | ansgetechnet. | Dann | in | dev | Nta:tii0d€•

clotuit
g/ eutlang | dev | xe
die Funk-t
Spit zeu
Ahntieh vet•hått
posit
Spitze•tt | (04 ler
hen | Signae
Si-
zwiseh€'ti | (len | bei"
Rift(l) (ler
siti(l',
(If'S Maxi-
wir | Init
hen | Xli-
Latenz | '/,wiwhon joder
)liögliehen Mikaofoupaauung | und | in | der | etnupareValues Blethode | Ijiiteili-
ander | verglichen. | Diese | Methode | vexg!eicåit nun | geliiessellen | Vevz.j;geruttgen | den | vorher
ausgerechneten | Verzögerungen, | und | zwar | fur jeQen | Iliögliehen | Der | iVinkelbereich | Jliit
clen gröfsten tibeveinsti)tunungen | iibcr | alle | -Mikrofonpaarung, kann | Init | Sicherheit | als | der | P,creich
gekennzeiehnet | werclen, aus | dem | das | Geräuseh | konnnt.

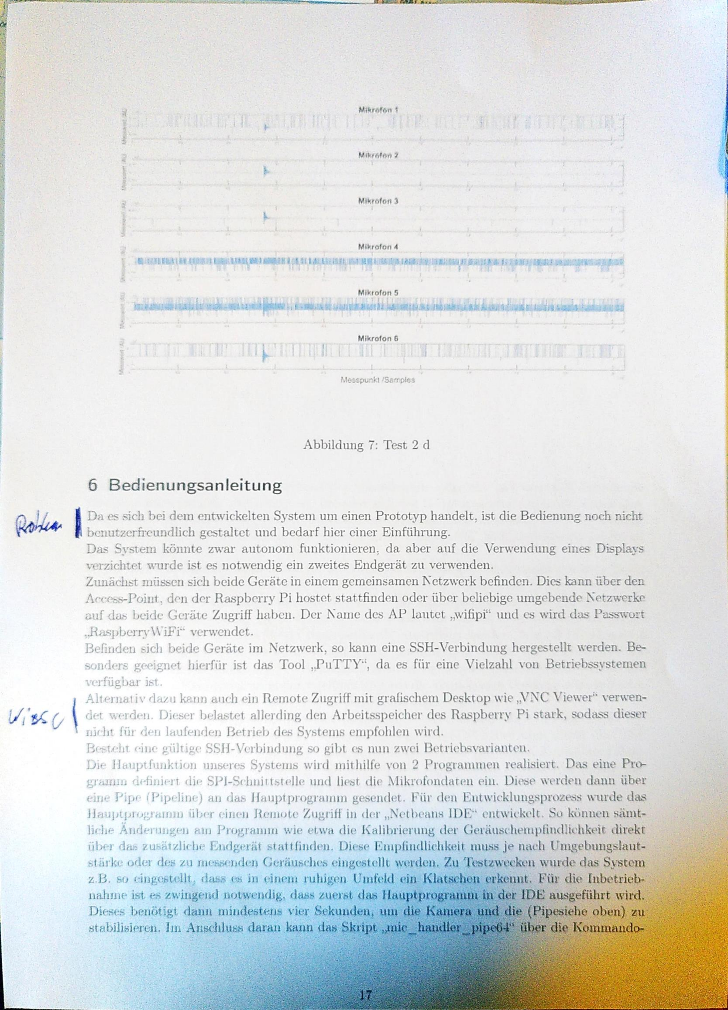
[picture p29: page 4]

e.

Mik€ofon

Mikroton 4

Miktofoti 5

Mikrofon G

[Sarrpi03

Abbildung | 7: | Test | 2 | d
6 | Bedienungsanleitung
Da es sic!) bei | | | | dem | entwickelten | System | um einen | | Prototyp | handelt, | ist | die | Bedienung | noch nicht
bcnutzerfreundlich gestaltet | | und | bcdarf hier ciner Einführung.
Das | System könute zwar | | | autonom | funktionieren, da | | aber | auf die Verwendung eines Displays
verzichtot wurde ist | | | es notwendig ein | | | zweites Endgerät | | zu verwenden.
Zunächst | yuiisscll Sich beide | | | Gcrätc | in | eincm | gemeinsamen | Nctzwcrk | bcfinclcn. | Dies kana | | iiber | den
Access-Point, den dor Raspberry | | | | Pi | hostet | stattfindcn | odor iibcr beliebigo urngobende Nerzwerke
auf das | | Leide Geräte Zugrilf habcll. Der Name des AP | | | | | | | | lautct | „wifipi" und cs wird das | | | | Passwort
verwenclet.
Befincleu Sich beide | | | Geräte | im | Netzwerk, so kann | | | eine SSH-Verbindung hergestellt | | | werden. Be-
sonqlers geeignet | | hierfiir | ist | das | Tool | ,.PuTTY•:, da | | es | für | eine | Vielzahl | von | Betriebssystemen
verfiigi»ar | ist.
Alternal | iv clazu kann | | | anch | ein | Remote | Zugriff mit | | gralischem | Desktop | wie „VNC Viewer" verwen-
(Get werdi?li. Dieser belastet | | | | | allercling den | | Arbeitsspeicher des Raspberry | | | Pi | stark, | sodass clieser
fiir den | | laufenc.len Betrieb | | | des Systems empfohlen wird.
eine gii]tige SSH-Verbindung so gibt | | | | | es | nun | zwci Betriebsvarianten.
Die | I | | unseres Systems wird | | | Illithilfe | von | 2 | Prograllltuen | realisiert. | Das | eiue | Pro-
flefilliert | (lie SPI-Schni1 tst elle | | | | und | liest | die | Mikrofonclaten | ei1L. Diese | | | wercleli daun | | liber
(tine Pipe | | (Pipeline) | ail | (las Haupiprogranun | | gesendet. | Fiir | den | Eutwicklungsprozess wurde das
iibor €.•inen | | | Zugriif ill | | der „Netbeans IDE" | | | entwickelts So költueu såmt-
liche | Andernngen | | I*rograliilfi wie et,wa die | | | | Kalibrierung | (ler | Geräuschempiindliehkeit clirekt
F)lidgeråit stati finden. | 'Diese Etnpfindliclikeit | muss je | naell | Ultigebuttgslaut-
st irke | | co(.ler (les zu | | rnestscnden Geräusches | eingestcllc | werclen, | Zu | Tostzweeken | wurde | das | System
z.B. | so eingest,ellu | | es | eineliå rulijgen | | ein | Klotsehen evkennt. | | Eiir | die | Inbetrieb-
ist | es zwingeu€l | class zuerst das | in cler IDE | ausgeführt | wird.
Dieses benötigi | rniudestens | vie,)' Sektuaden;i | die | Kangeva.uncl die | (Pipesiehe | oben) | zu
stabilisieren, | 1m Anschlusb | das | Skript, | pipe(i$€ (iber | die | Kommaudo-

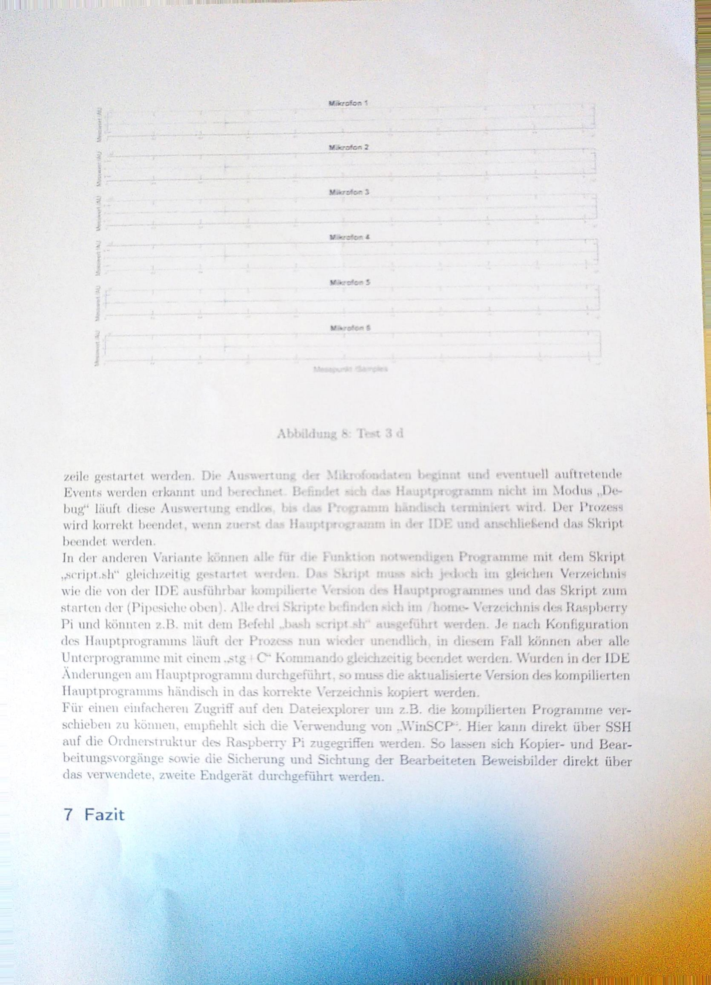
[picture p30: page 5]

zeile | art et. | it. Ivteti(le
buga' | läuft | diese | I jer | I
wild | Skript,
I | svet'(len.
In der | Variante | (lern Skiipt
gleichzeitig | n. | ita | Vetu.é•ichnis
wie (lie von (1er IDE | s. . | und | (las | Skript
start en | (1er (Pipesiehe | oben | d! | h: | (les
Pi | uncl könnten | z.B. | Init. | Befehl | Je | nach | Konfignration
(les Haupt progranuns liiuft der | Pi | Fall | können | aber | alle
Unt erprogranune | lilit | eiuelll | gleichzeitig | b€•el-det werden, IVutTlen in der | IDE
schieben zu können, etnpfhehlt sieh die V€:rwenduuz von | .NVinSCP'„ Hier | kann | direkt | über | SSH
auf die | des Raspberr,' Pi | zuzegliffen werden. So | sich Kopiel= und | Bear-
beitungsvorgäu cse | | | sowie (lie Sicherung und | | | Sichtung | der | Bearbeiteten | Beweisbilder | direkt | iiber
das | venvelidete, | zweite Endgerät | | durchgeführt | werden.
7 | Fazit
