plastikpamaro/bachelorprojekt2020/21-02-19-Kickoff/Studienarbeit/Verschaltung.pdf

RasPi

Micro Board

Micro Board
(SYNC – Hinweis
beachten)
GND 40 | 23 21 | 5V

LRCLK
SYNC

BCLK

DATA
MISO
2 | 1 3 | 7 6

1 8

2 | 1 3 | 7 6
2 | 1 3 | 7 6

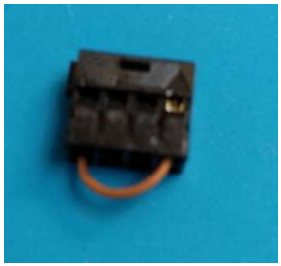
[picture p31: figure]

Verbinder für das Ende der Kette

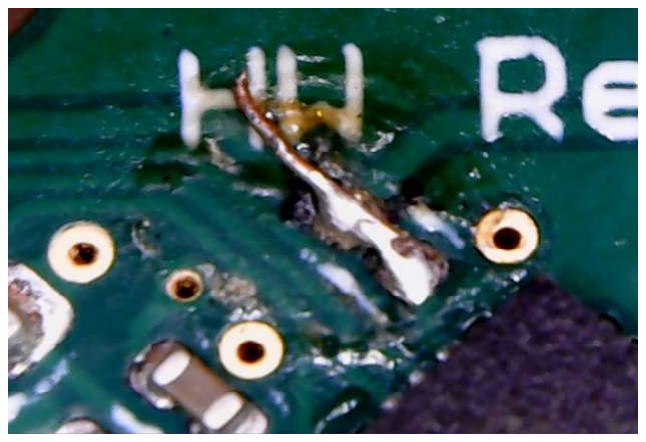
[picture p32: figure]

Lötbrücke Mikrofonboard
SYNC Board

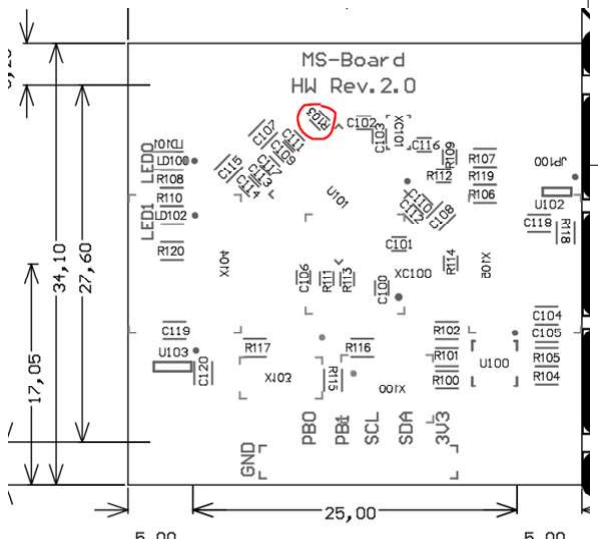
[picture p33: figure]

Hinweis: Lötbrücke bei R103 um SYNC Signal über Verbinder auf LRCLK zu führen
SYNC Board muss unbedingt ans Ende der Kette, sodass der Verbinder direkt am Board angeschlossen wird
