plastikpamaro/bachelorprojekt2020/21-02-19-Kickoff/Studienarbeit/uC Code/MSM_TDM/documents/latex/main.pdf

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

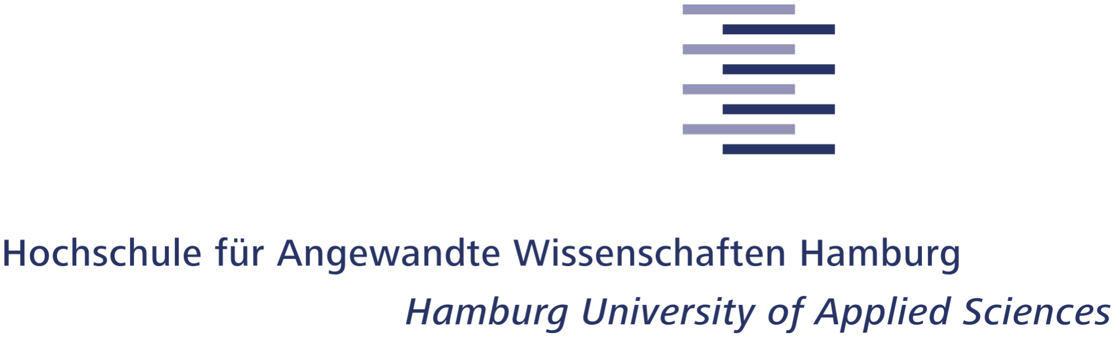
[picture p34: figure]

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

Frisch

## 1 Aktueller Stand

1.1 Hardwareaufbau

Für die akustische Messung werden sog. MSM, Multi-Sensor Mikrofon, Einheiten genutzt welche bis zu zwei Mikrofone aufweisen können. Abbildung 1 zeigt das Blockschaltbild einer solchen Einheit.


Abbildung 1: Blockschaltbild der MSM Einheit

Die MSM Einheit besteht aus einem Mikrofon Board und einem Processing board. Bis zu zwei Mikrofone werden über ein PDM Interface an einen Atmel SAMG55J19 Mikrocontroller angeschlossen. Dieser sorgt für die Kommunikation zur äuÿeren Umgebung mittels seriellem Interface, welches über die in Gelb dargestellten Board Stecker zugänglich ist. Dabei handelt es sich um den TDM Bus. Zusätzlich verfügt das Processing board über einen Beschleunigungssensor LIS331DLH, welcher derzeit jedoch nicht benutzt wird. Die eingehenden Daten der Mikrofone werden aktuell direkt weitergegeben. Es erfolgt keine Signalverarbeitung.

Abbildung 2 zeigt wie die MSM Einheit in einem Rohrausschnitt aussieht.


Abbildung 2: MSM Einheit in einem Rohrausschnitt

30. Januar 2020 | 1

1.2 Firmwareablauf

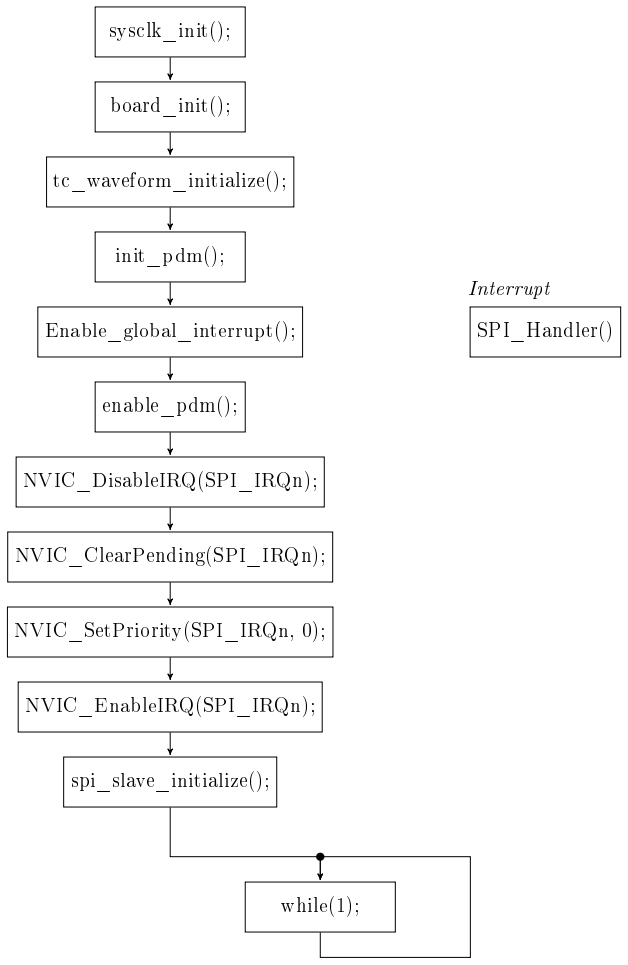
[picture p35: figure]
sysclk_init();; board_init();; tc_waveform_initialize();; init_pdm();; Enable_global_interrupt();; enable_pdm();; NVIC_DisableIRQ(SPI_IRQn);; NVIC_ClearPending(SPI_IRQn);; NVIC_SetPriority(SPI_IRQn, 0);; NVIC_EnableIRQ(SPI_IRQn);; spi_slave_initialize();; while(1);; SPI_Handler(); Interrupt

Abbildung 3: Ablaufplan der Firmware

sysclk_init();
Initialisiert die Systemtaktfrequenz auf 120 MHz

board_init();
Initialisiert alle Ein- und Ausgänge, sowie LEDs und Schalter

tc_waveform_initialize();
Initialisiert das Timer-Counter Modul 2, welches als Eingänge, die für den TDM Bus benötigen Signale, BCLK und LRCLK hat. Genutzt wird dieses Modul zur Erzeugung eines Chip-Selects für das SPI5 Modul. Timer-Counter und SPI Modul agieren zusammen als TDM Modul ermöglichen die Nutzung des TDM Bus.
30. Januar 2020 | 2

Das TC Modul wird so eingestellt, dass bei jeder fallenden Flanke von BCLK ein interner Zählwert inkrementiert wird. Sobald LRCLK auf eine logische eins gezogen wird, löscht das Timer-Counter Modul den Zählwert und beginnt wieder bei null. Die nachfolgende Abbildung 4 zeigt das Verhalten graphisch.

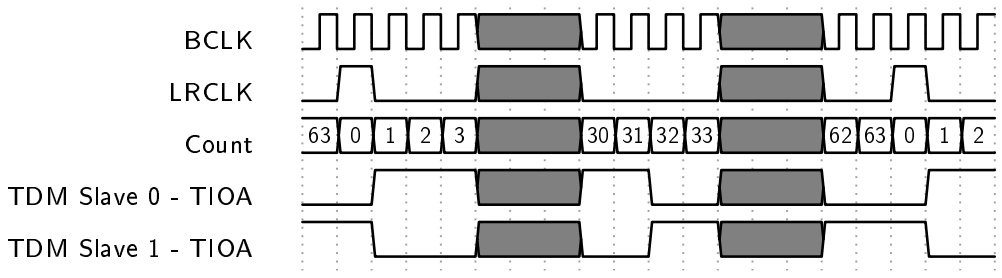
[picture p36: figure]
BCLK; LRCLK; Count; TDM Slave 0 - TIOA; TDM Slave 1 - TIOA

Abbildung 4: Funktionsweise Timer-Counter Modul

Sowie der Zählwert 32 erreicht wird je nach Slave Einstellung das Spannungsniveau von TIOA umgekehrt.

Abbildung 5 zeigt die Verbindung zwischen dem Timer-Counter und SPI Modul. Genutzt wird von drei möglichen Timer-Counter Modulen das dritte Modul TC2 und von acht SPI Modulen das sechste, SPI5. Über die Pins PA21 und PA11 ist der Ausgang von TC2 mit dem Chip-Select Eingang von SPI5 verbunden.

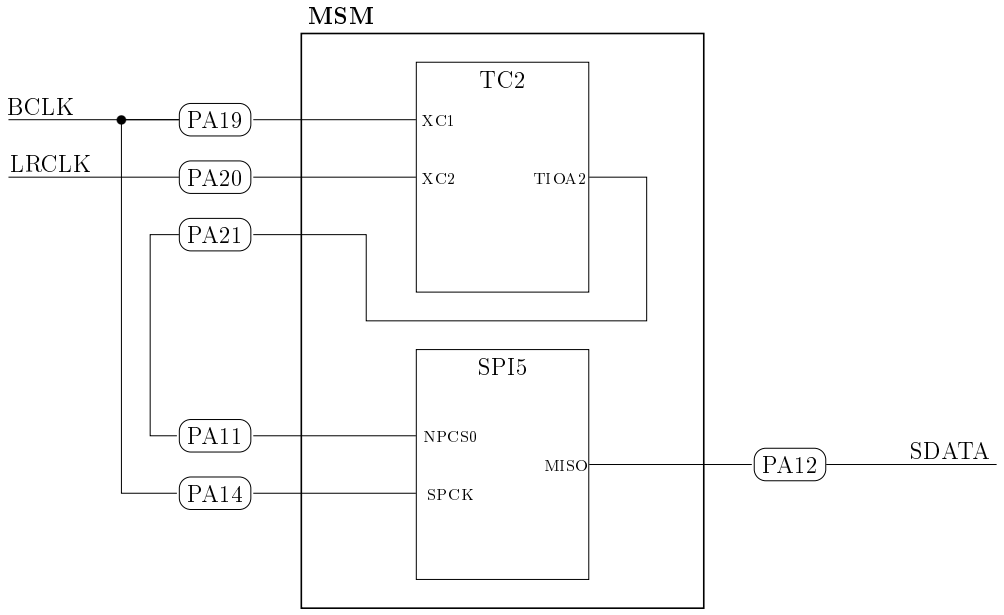
[picture p37: figure]
MSM; SPI5; TIOA2; NPCS0; SPCK; MISO; BCLK; LRCLK; SDATA

Abbildung 5: Interaktion TC und SPI Modul

30. Januar 2020 | 3

init_pdm();
Konguriert das PDMIC Modul 0 so, dass die Abtastrate Fs bei 3,072 MHz liegt, der Verstärkungsfaktor bei 1500, die Überabtastrate bei 64 und die Datengröÿen der abgetastet Daten am Ende bei 32 Bit liegen. Alle weiteren Einstellungen entsprechen den Standardwerten.
Enable_global_interrupt();
Diese Funktion schaltet Interrupts allgemein ein.
enable_pdm();
Aktiviert das zuvor kongurierte PDMIC0 Modul. NVIC_DisableIRQ(SPI_IRQn); NVIC_ClearPending(SPI_IRQn);
NVIC_SetPriority(SPI_IRQn, 0);
NVIC_EnableIRQ(SPI_IRQn);
Die genannten vier Funktionen aktivieren die Peripheral ID 21, welche dem SPI5 Modul zugehörig ist, als Interruptquelle für den Nested Vector Interrupt Controler (NVIC). spi_slave_initialize();
Konguriert das SPI5 Modul so, dass es im Slave Modus betrieben wird. Mit einer Taktpolarität von 0 und einer Phase von 1 wird auf steigenden Flanken vom Takt ein ausgehendes Datenbit gesetzt. Die Datentransfergröÿe wird auf acht Bit eingestellt. Abschlieÿend wird das Modul eingeschaltet und die steigende Flanke auf der Chip-Select Leitung als Interrupt-Quelle angegeben. Somit überträgt das SPI Modul Daten wenn durch das Timer-Counter Modul TIOA auf eine logische eins gesetzt wird.
30. Januar 2020 | 4

1.3 Mikrofonverhalten

Um die Mikrofone vor Umwelteinüssen zu schützen, werden dünne Membranen über den Mikrofonen angebracht. Diese sind abschlieÿend mit der Rohrönung, sodass kein Schmutz oder Wasser in das Rohr eindringen kann. Die Membranen bestehen aus einem leicht elastischen Thermoplasten und werden in verschiedenen Dicken hergestellt. Abbildung 6 zeigt das Frequenzverhalten eines Mikrofons unter Einuss der verschiedenen Membranen und ohne Membran.

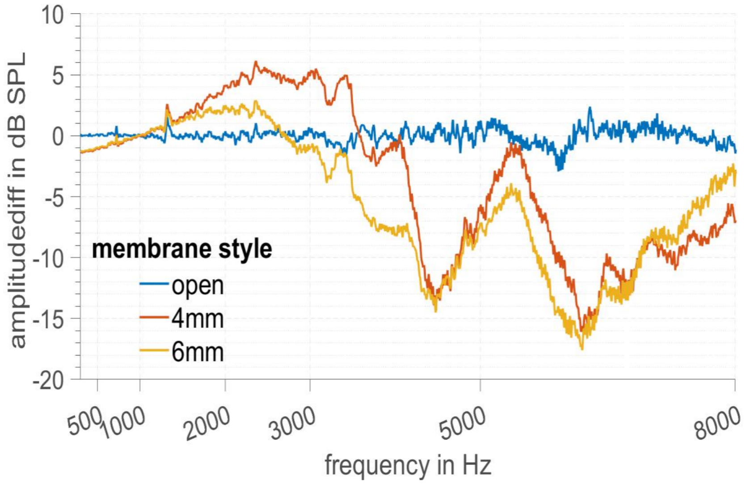
[picture p38: figure]

Abbildung 6: FFTs verschiedener Membran-Anordnungen

Für diese Messung wird ein Ton einer festen Amplitude auf das Mikrofon gegeben. Die Frequenz dieses Tons wird dabei stets inkrementiert, sodass Frequenzen von etwa 100 Hz bis 8 kHz abgetastet werden. Deutlich zu erkennen ist, dass die Membranen den konstanten Durchlassbereich der Mikrofone, welche diese ohne Membran aufweisen, verändern.

30. Januar 2020 | 5

## 2 Ziele

Das veränderte Verhalten der Mikrofone durch die Nutzung einer Membran soll mit einem Filterentwurf linearisiert werden. Dafür steht auf dem Atmel SAMG55J19 Mikrocontroller eine DSP Einheit zur Verfügung.

## 3 Analyse

Für eine Membran mit einer Dicke von 6 mm ergibt sich bis 1000 Hz eine Dämpfung von maximal etwa 1,2 dB. Zwischen 1 kHz und 2,8 kHz erfolgt eine Verstärkung mit maximal 3 dB und für den restlichen Frequenzbereich bis 8 kHz entstehen Dämpfungen bis zu 18 dB. Eine maximale Dämpfung von 18 dB entspricht ungefähr dem Faktor von 64, welches einem binären schieben um 6 Stellen nach links gleicht.

## 4 Konzept

Wird das Verhalten der Mikrofone, mit beispielsweise einer 6 mm Membran, linearisiert ergibt sich folgender Graph welcher in Abbildung 7 zu erkennen ist.


Abbildung 7: Linearisierte FFT der 6mm Membran und die Inverse

Damit das durch die Membran veränderte Verhalten korrigiert werden kann, muss das zu bauende Filter eine Kennlinie gleich dem Inversen aufweisen. Dieses ist in Abbildung 7 mit der Orangen Linie gekennzeichnet. Ein solches Verhalten ist mit nur einem Filter

30. Januar 2020 | 6

kaum realisierbar, somit wird die gezeigte Kennlinie in vier Teilbänder unterteilt. Für diese werden nun Filter realisiert. Die Kaskadierung aller vier Teillter muss am Ende die Orange Kennlinie wiederspiegeln.

30. Januar 2020 | 7

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
