plastikpamaro/bachelorprojekt2020/Dokumentation/Sections/Vorwort/Vorwort.tex

\section{Vorwort}

Im Rahmen eines Bachelors Projekts im Fachbereich Mechatronik an der HAW Hamburg, ist eine kleine Gruppe Studierender dazu beauftragt, eine praxisnahe Aufgabe zu lösen. Dazu gehört der Prozess der Produktentwicklung, aber auch die Erschaffung eines Prototypen. Diese Dokumentation dient dazu, die Arbeitsschritte und eine Produktbeschreibung festzuhalten. Auf der Basis der Studienarbeit von Maximilian Weltz führen die vier genannten Autoren unter Leitung von Herrn Prof. Dr. Rasmus Rettig eine Anpassung des \glqq Akustisches Condition Monitoring System[s]\grqq\ an die neue Aufgabenstellung durch.
\newpage
