plastikpamaro/bachelorprojekt2020/Dokumentation/Sections/Git/Git.tex

\section{Git}
\begin{tabular}{|l|l|}
	\hline
	Git-Befehl & Auswirkung\\
	\hline
	\hline
	git clone plus Link & Git-Verzeichnis auf PC klonen\\
	\hline
	git pull & aktuellen Stand vom Server holen\\
	\hline
	git status & Informationen über den aktuellen Stand\\
	\hline
	git add & geänderte Dateien hinzufügen mit Dateiname\\
	\hline
	git add . & alle geänderten Dateien hinzufügen\\ 
	\hline
	git commit -m \glqq Kommentar\grqq & Commit erstellen\\
	\hline
	git push & auf den Sever schieben\\
	\hline
\end{tabular}
