plastikpamaro/bachelorprojekt2020/Sitzungen/21-02-19 Zoom Meeting mit Max.docx

Input von Max

Typanpassung

Mikrophon sendet 24 Bit Messwerte. Verarbeitet werden 32 Bit, daher ist die Typkonvertierung notwendig.

Mikrophon sendet vorzeichenlose Messwerte. Für die korrekte Darstellung des Geräusches ist es notwendig, dass die Schwingung um die 0 oszilliert. Daher Konvertierung von vorzeichenloser 32 Bit Variable zu vorzeichenbehafteter 32 Bit Variable.

Konvertierung der Messwerte von uint32_t (24 Bit) zu int32_t:

int32_t convertToSigned(uint32_t x){

return ( (x << 8) >> 8 );

}

MSB (Vorzeichen) wird von Zahl getrennt, Wert wird beibehalten.

Öffnen des Tunnels:

Wichtig: IMMER erst die Empfangsseite und danach die Sendeseite öffnen.

Möglichkeit 1:

Manuell in der Raspikonsole mic_handler_pipe starten und Auswertealgorithmus starten

Möglichkeit 2:

script.sh auf der Konsole ausführen für einen automatisierten Start beider Programme.

Öffnen des Tunnels an der Empfangsseite

Um die Daten in die main.cpp des Auswertealgorithmus zu holen, muss der Kanal zwischen den beiden Programmen mic_handler_pipe.c und dem Auswertealgorithmus geöffnet werden. Mit den Zeilen:

int pipe_filestream = -1;

create_pipe(&pipe_filestream);

In der main.cpp wichtig: input_pipe.h inkludieren und input_pipe.c sowie input_pipe.h in das Projekt einbinden.
