plastikpamaro/bachelorprojekt2020/Organisation/BP_PhilippOtto.pdf

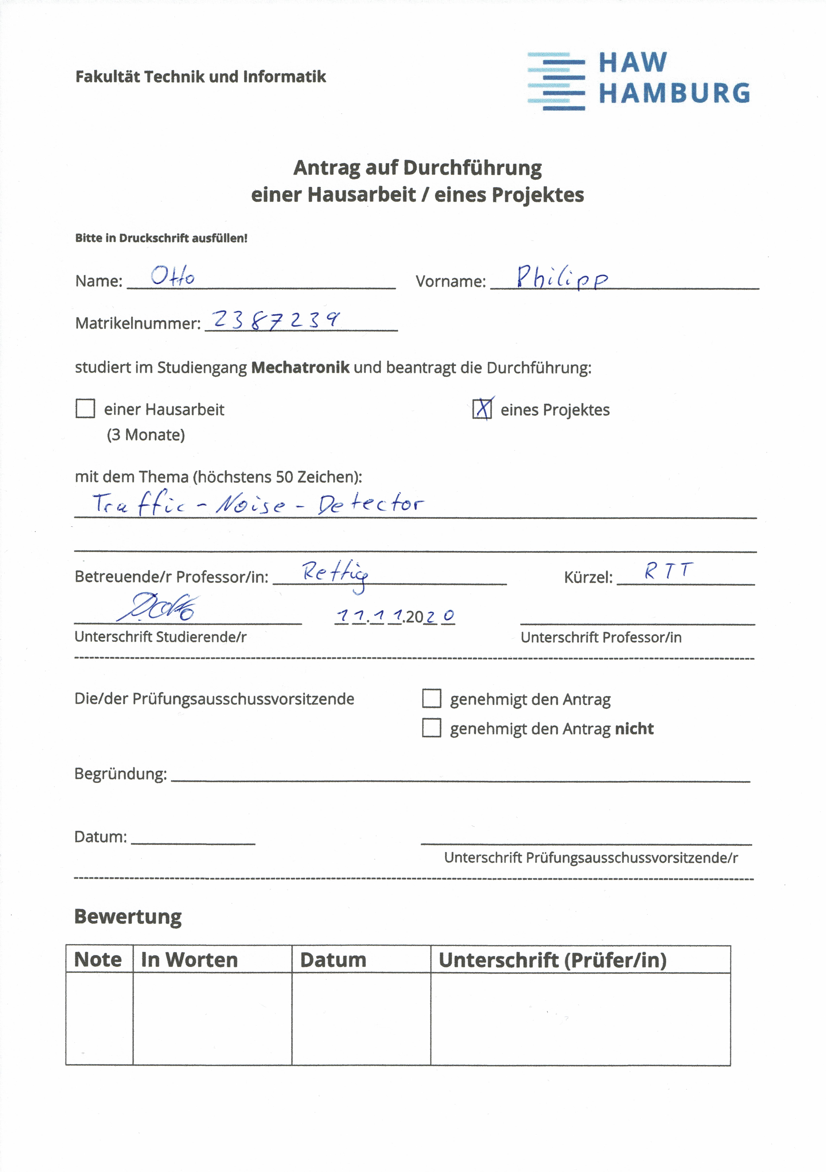
[picture p50: page 1]
