plastikpamaro/bachelorprojekt2020/21-01-04_Statusbericht_2/20-11-20_Gantt_Chart.xlsx

Plan 19. 10. 2020 (Grün)
Status 20. 11. 2020 (Schwarz) |  |  |  |  |  | Statusbericht 1 GPM |  |  |  |  |  |  | Statusbericht 2 GPM |  |  |  |  |  |  |  |  |  |  |  |  | Übergabe an den Kunden
Meilensteine |  |  |  |  |  | 2020-11-23 |  |  |  |  |  |  | 2020-01-04 |  |  |  |  |  |  |  |  |  |  |  |  | 2020-03-30
Donnerstage | 2020-10-22 | 2020-10-29 | 2020-11-05 | 2020-11-12 | 2020-11-19 |  | 2020-11-26 | 2020-12-03 | 2020-12-10 | 2020-12-17 | 2020-12-24 | 2020-12-31 |  | 2021-01-07 | 2021-01-14 | 2021-01-21 | 2021-01-28 | 2021-02-04 | 2021-02-11 | 2021-02-18 | 2021-02-25 | 2021-03-04 | 2021-03-11 | 2021-03-18 | 2021-03-25
Projket definieren
Lastenheft erstellen
Gantt-Chart erstellen
Pflichtenheft erstellen
Akustische Grundlagen lernen
Vorhandenen Code verstehen
Aufgaben verteilen
IBD erstellen
Use-Case erstellen
Code anpassen
Mikrophongehäuse konstruieren
Mikrophonegehäuse drucken
Testkonzept entwickeln
Prototyp montieren
System testen
System ausliefern
