plastikpamaro/bachelorprojekt2020/20-11-23_Statusbericht_1/psp.jpg

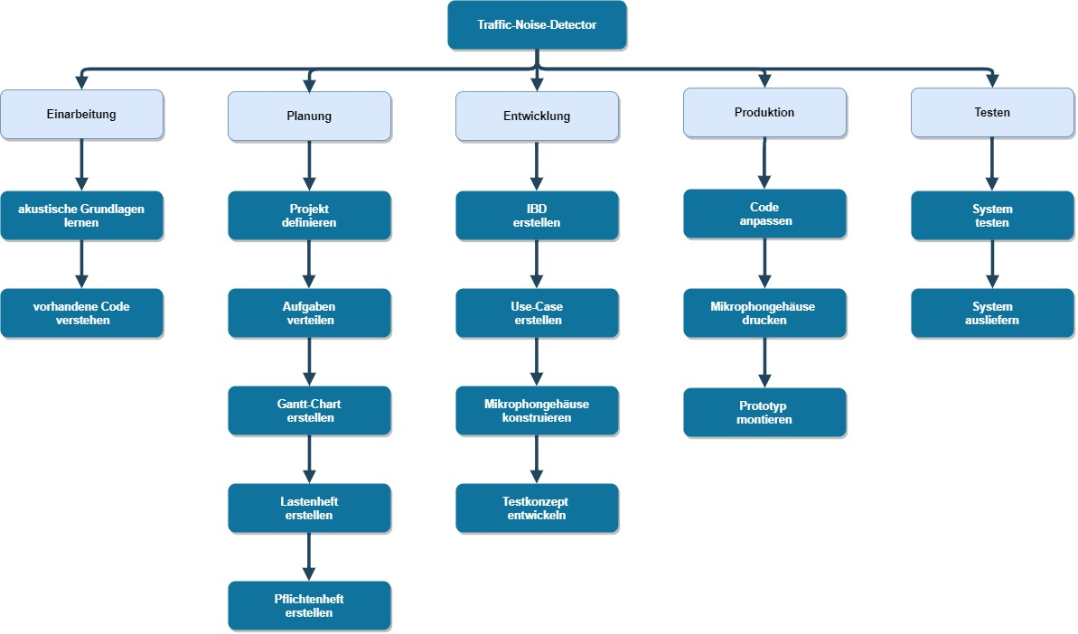
20-11-23_Statusbericht_1/psp.jpg
