plastikpamaro/bachelorprojekt2020/21-02-19-Kickoff/Studienarbeit/Messungen & Bilder/CAD/Gehäusezusammenbau1.png

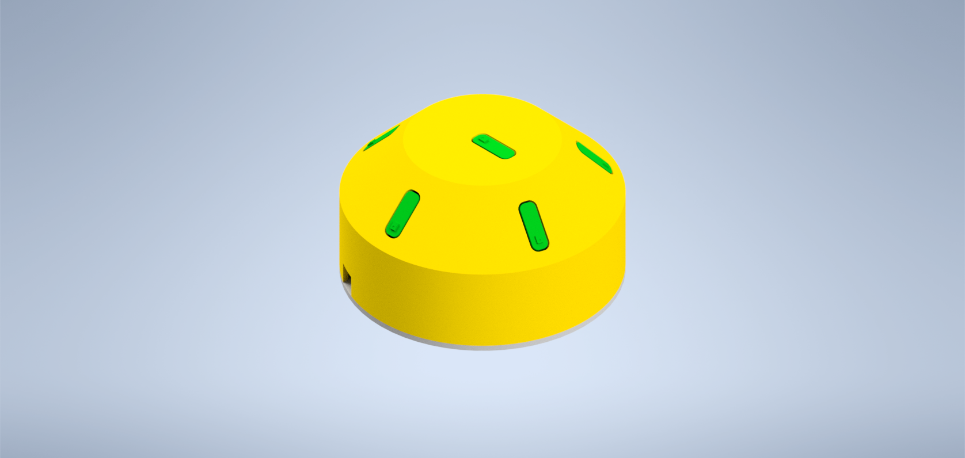
21-02-19-Kickoff/Studienarbeit/Messungen & Bilder/CAD/Gehäusezusammenbau1.png
