plastikpamaro/bachelorprojekt2020/21-02-19-Kickoff/Studienarbeit/Messungen & Bilder/CAD/Gehäusezusammenbau2.png

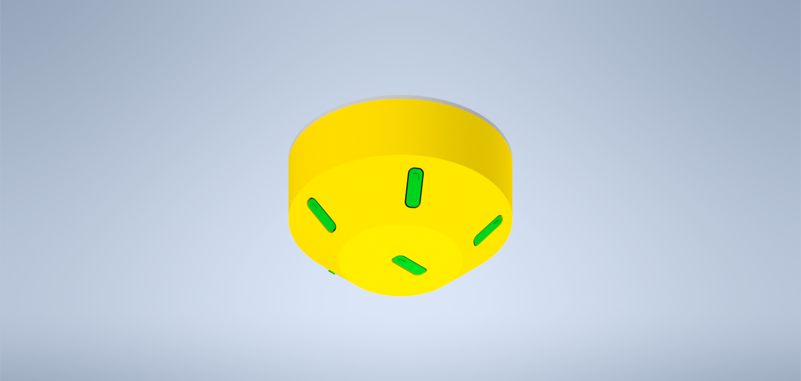
21-02-19-Kickoff/Studienarbeit/Messungen & Bilder/CAD/Gehäusezusammenbau2.png
