plastikpamaro/bachelorprojekt2020/21-02-19-Kickoff/Studienarbeit/Messungen & Bilder/CAD/Neuste Version Gehäuse/innenansicht.PNG

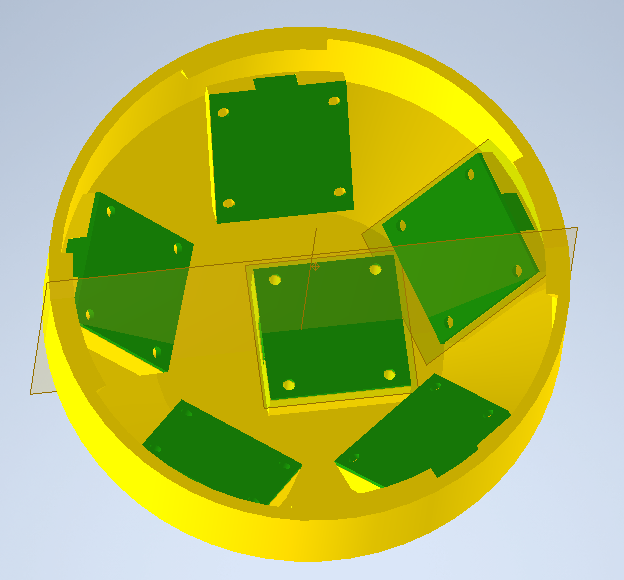
21-02-19-Kickoff/Studienarbeit/Messungen & Bilder/CAD/Neuste Version Gehäuse/innenansicht.PNG
