plastikpamaro/bachelorprojekt2020/21-02-19-Kickoff/Studienarbeit/Messungen & Bilder/CAD/Neuste Version Gehäuse/isoView.PNG

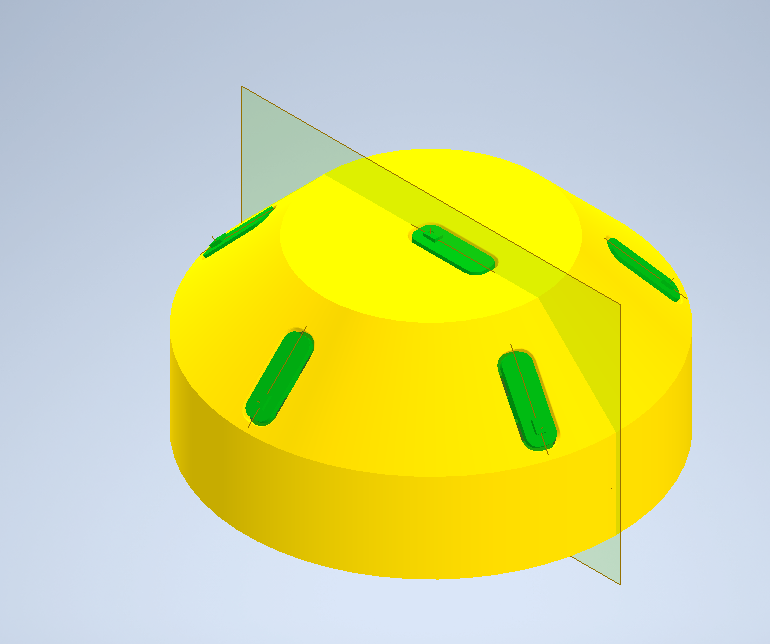
21-02-19-Kickoff/Studienarbeit/Messungen & Bilder/CAD/Neuste Version Gehäuse/isoView.PNG
