plastikpamaro/bachelorprojekt2020/21-02-19-Kickoff/Studienarbeit/Messungen & Bilder/Oszilloskopaufnahmen/32ClockDeviderMessungNachrichtenlänge.PNG

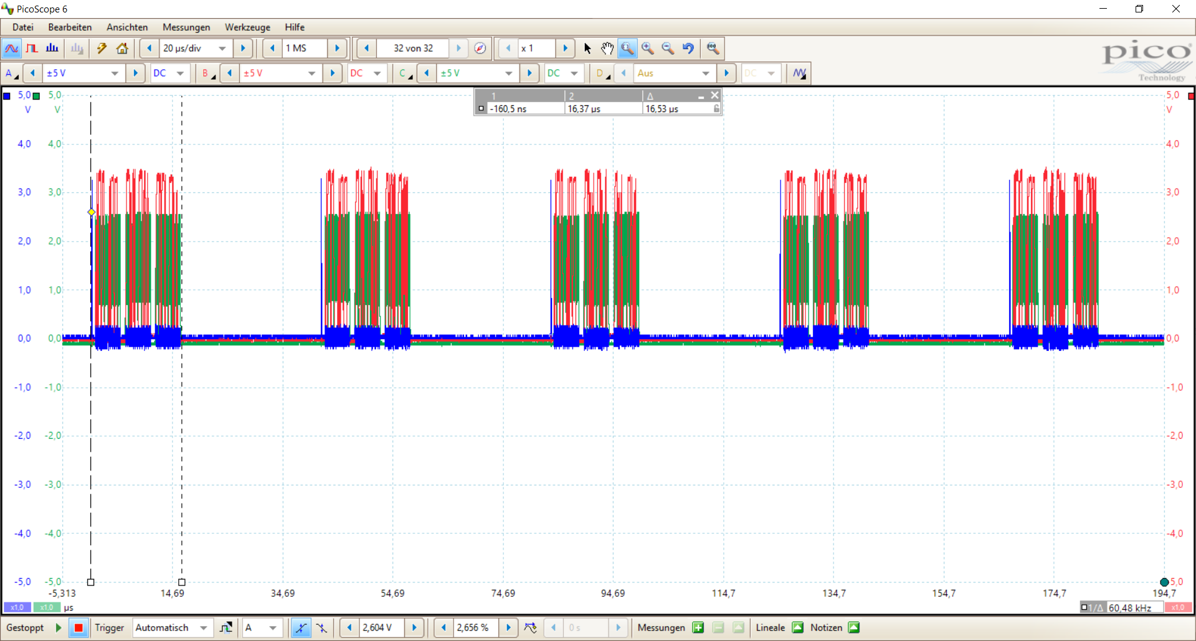
21-02-19-Kickoff/Studienarbeit/Messungen & Bilder/Oszilloskopaufnahmen/32ClockDeviderMessungNachrichtenlänge.PNG
