plastikpamaro/bachelorprojekt2020/21-02-19-Kickoff/Studienarbeit/Messungen & Bilder/Oszilloskopaufnahmen/Bilder Bit Springer/ALTER TDM2 Code.PNG

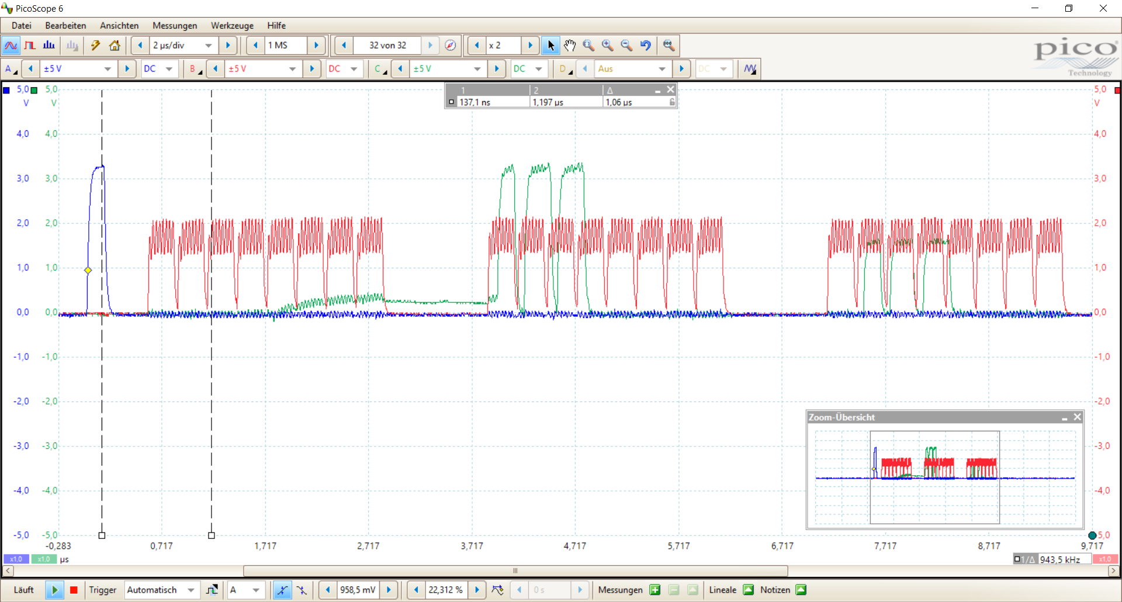
21-02-19-Kickoff/Studienarbeit/Messungen & Bilder/Oszilloskopaufnahmen/Bilder Bit Springer/ALTER TDM2 Code.PNG
