plastikpamaro/bachelorprojekt2020/21-02-19-Kickoff/Studienarbeit/Messungen & Bilder/Oszilloskopaufnahmen/Bilder Bit Springer/neue Variante nicht unterdrückt.PNG

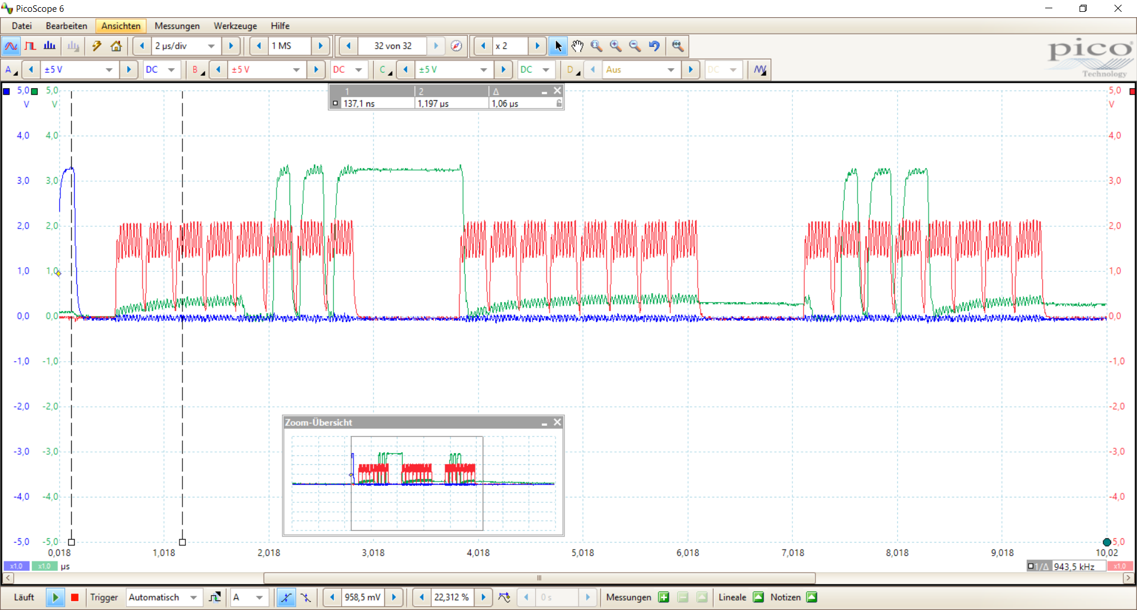
21-02-19-Kickoff/Studienarbeit/Messungen & Bilder/Oszilloskopaufnahmen/Bilder Bit Springer/neue Variante nicht unterdrückt.PNG
