plastikpamaro/bachelorprojekt2020/21-02-19-Kickoff/Studienarbeit/Messungen & Bilder/Oszilloskopaufnahmen/dataSnapshot.PNG

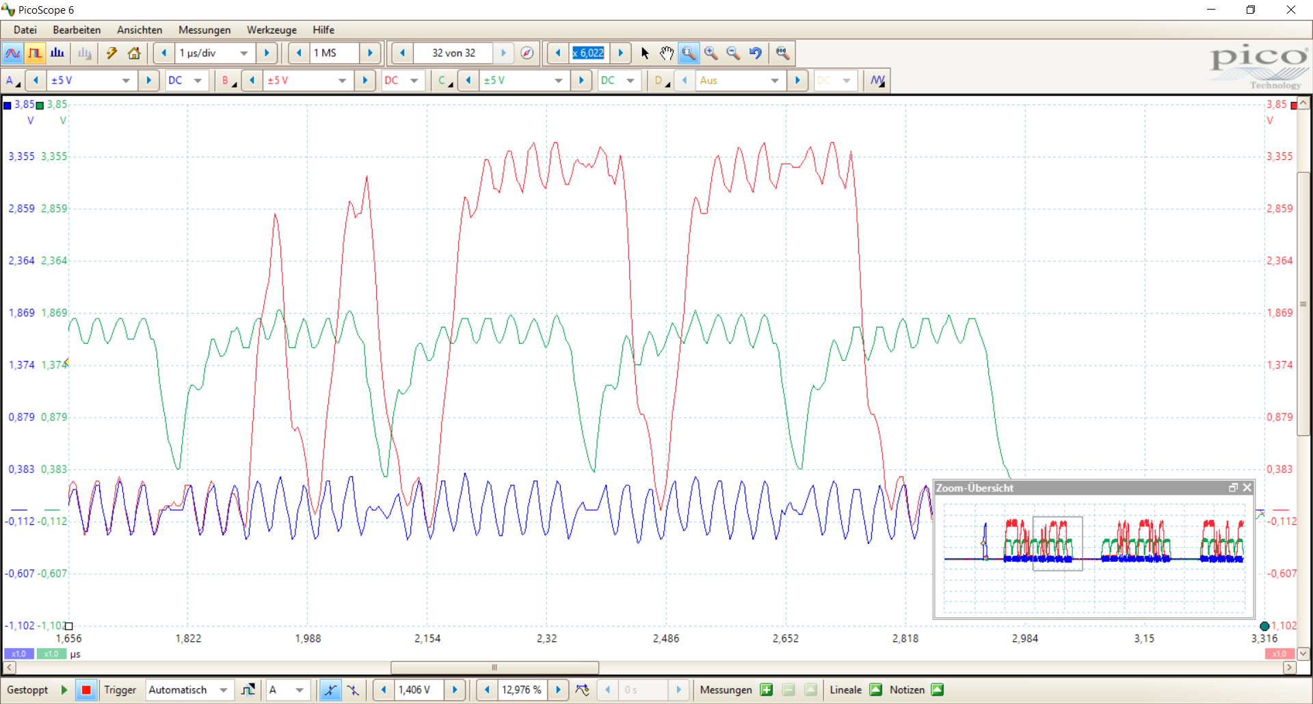
21-02-19-Kickoff/Studienarbeit/Messungen & Bilder/Oszilloskopaufnahmen/dataSnapshot.PNG
