plastikpamaro/bachelorprojekt2020/21-02-19-Kickoff/Studienarbeit/Messungen & Bilder/Oszilloskopaufnahmen/OsziTDM8_with2Sensor_Slot3&7&InternalClock.PNG

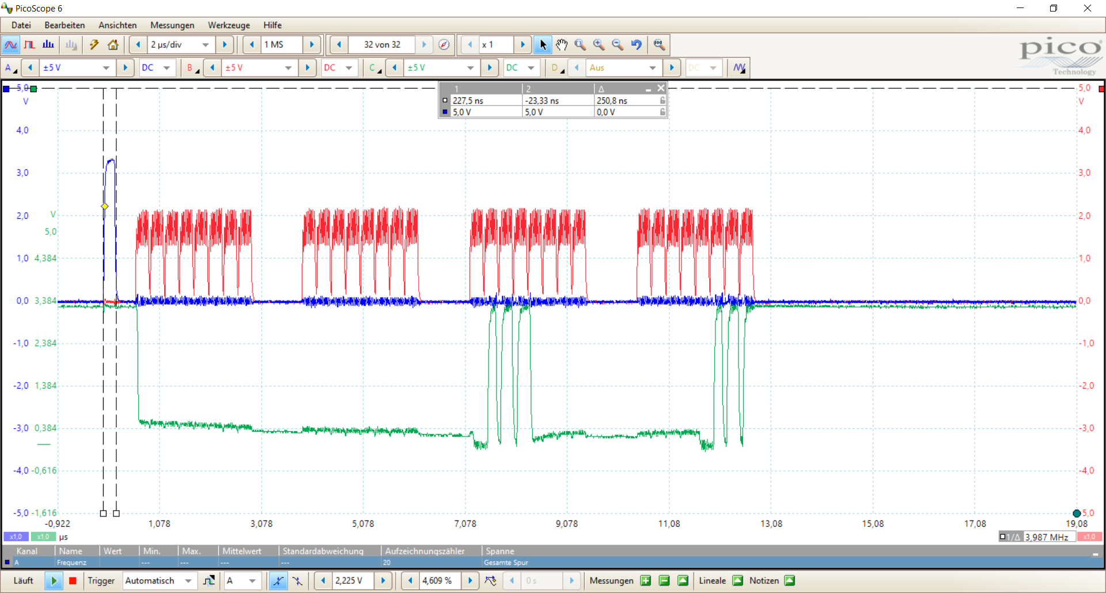
21-02-19-Kickoff/Studienarbeit/Messungen & Bilder/Oszilloskopaufnahmen/OsziTDM8_with2Sensor_Slot3&7&InternalClock.PNG
