plastikpamaro/bachelorprojekt2020/Bildschirmfoto 2021-04-14 um 15.00.29.png

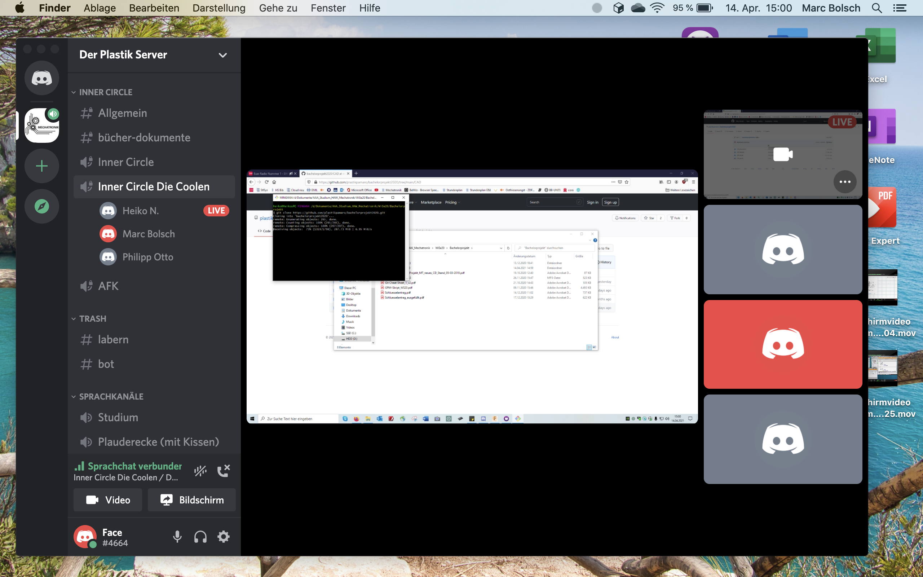
Bildschirmfoto 2021-04-14 um 15.00.29.png
