plastikpamaro/bachelorprojekt2020/CAD/CAD_Bodenplatte/Bildschirmfoto 2021-03-23 um 18.18.47.png

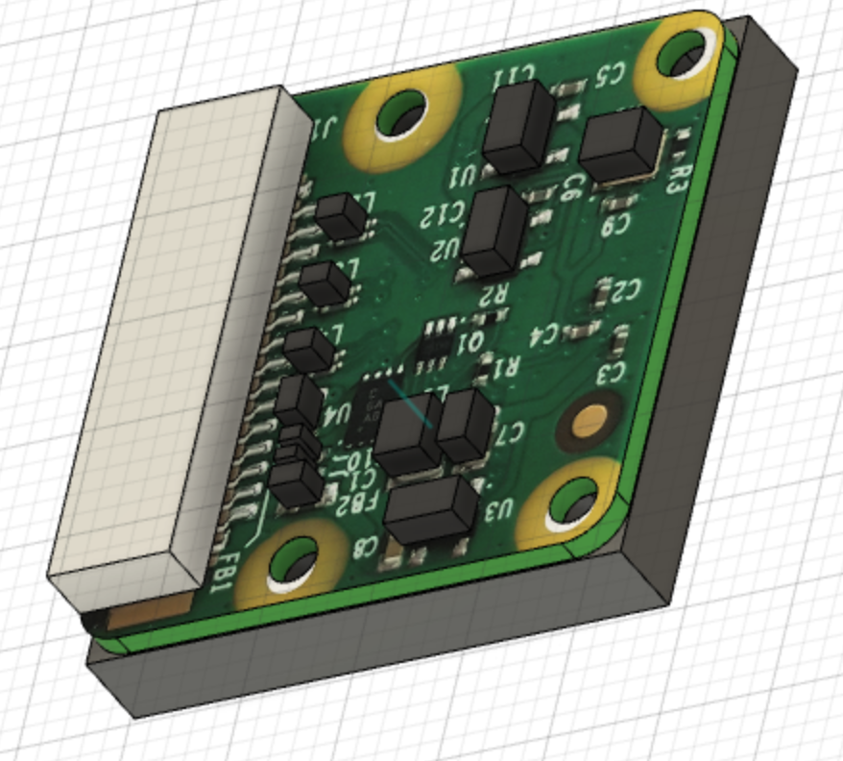
CAD/CAD_Bodenplatte/Bildschirmfoto 2021-03-23 um 18.18.47.png
