plastikpamaro/bachelorprojekt2020/CAD/CAD_Bodenplatte/Bildschirmfoto 2021-03-23 um 18.19.41.png

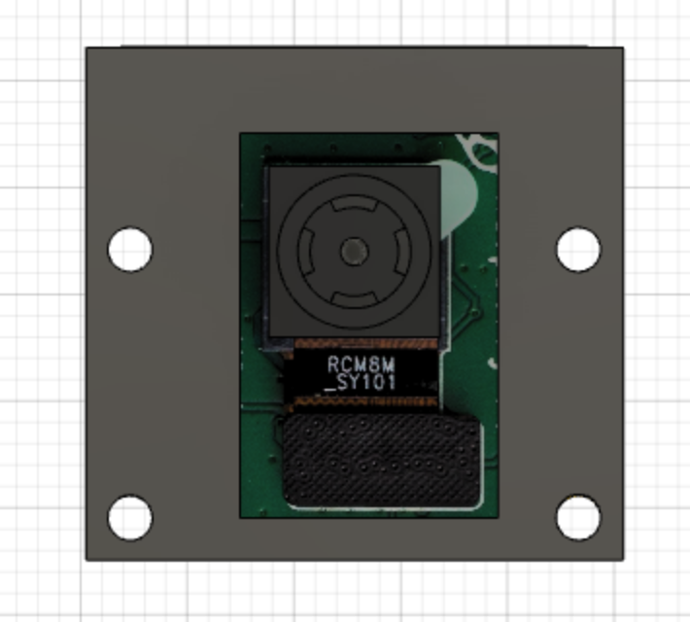
CAD/CAD_Bodenplatte/Bildschirmfoto 2021-03-23 um 18.19.41.png
