plastikpamaro/bachelorprojekt2020/CAD/CAD_Bodenplatte/Bildschirmfoto 2021-03-30 um 16.06.28.png

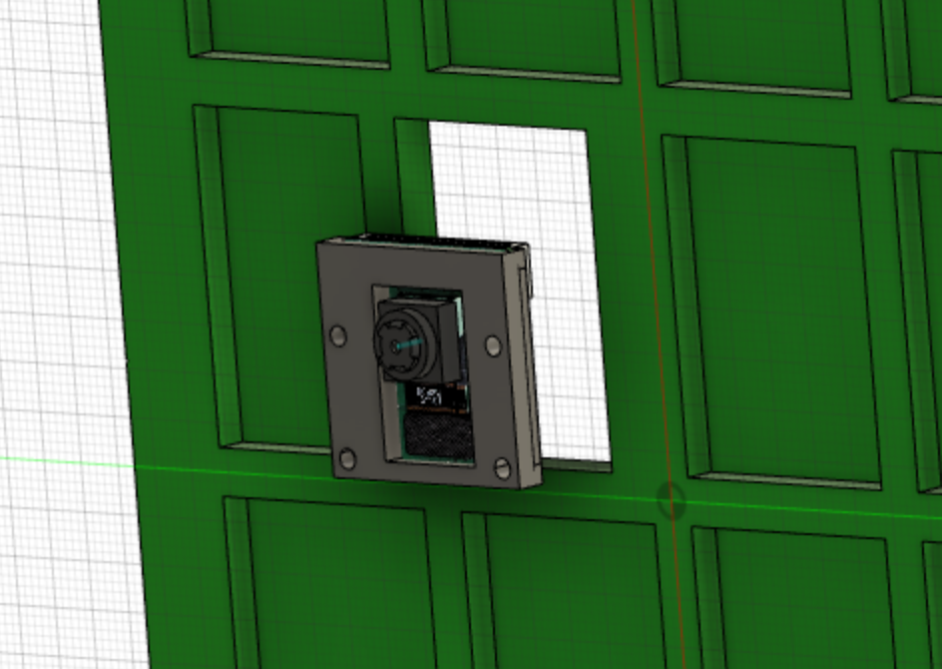
CAD/CAD_Bodenplatte/Bildschirmfoto 2021-03-30 um 16.06.28.png
