plastikpamaro/bachelorprojekt2020/CAD/CAD_Bodenplatte/Bildschirmfoto 2021-04-14 um 16.38.53.png

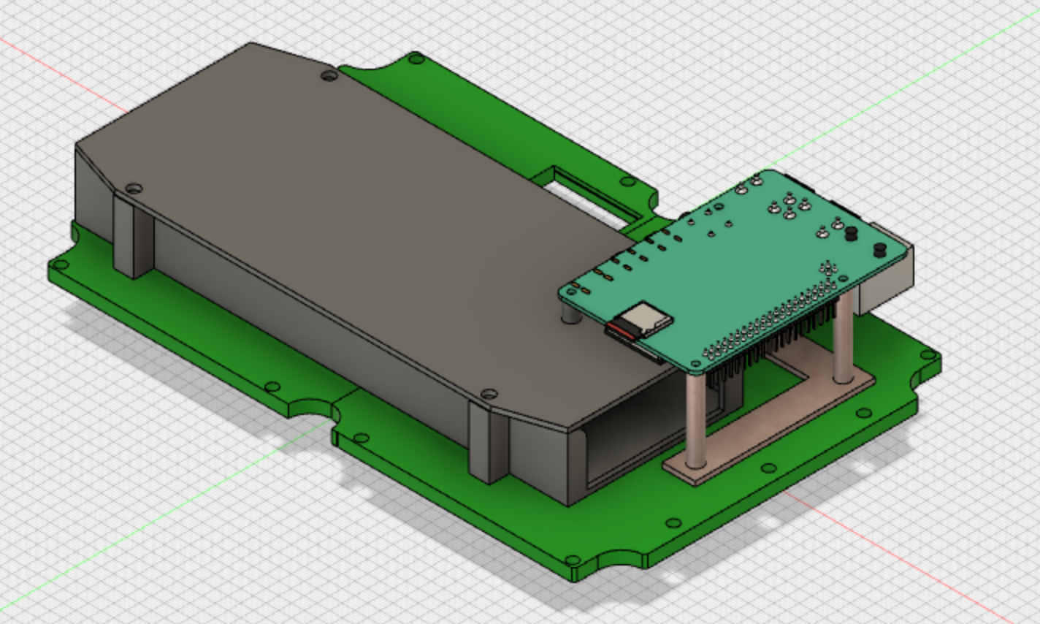
CAD/CAD_Bodenplatte/Bildschirmfoto 2021-04-14 um 16.38.53.png
