plastikpamaro/bachelorprojekt2020/CAD/CAD_Bodenplatte/Bildschirmfoto 2021-04-14 um 16.39.55.png

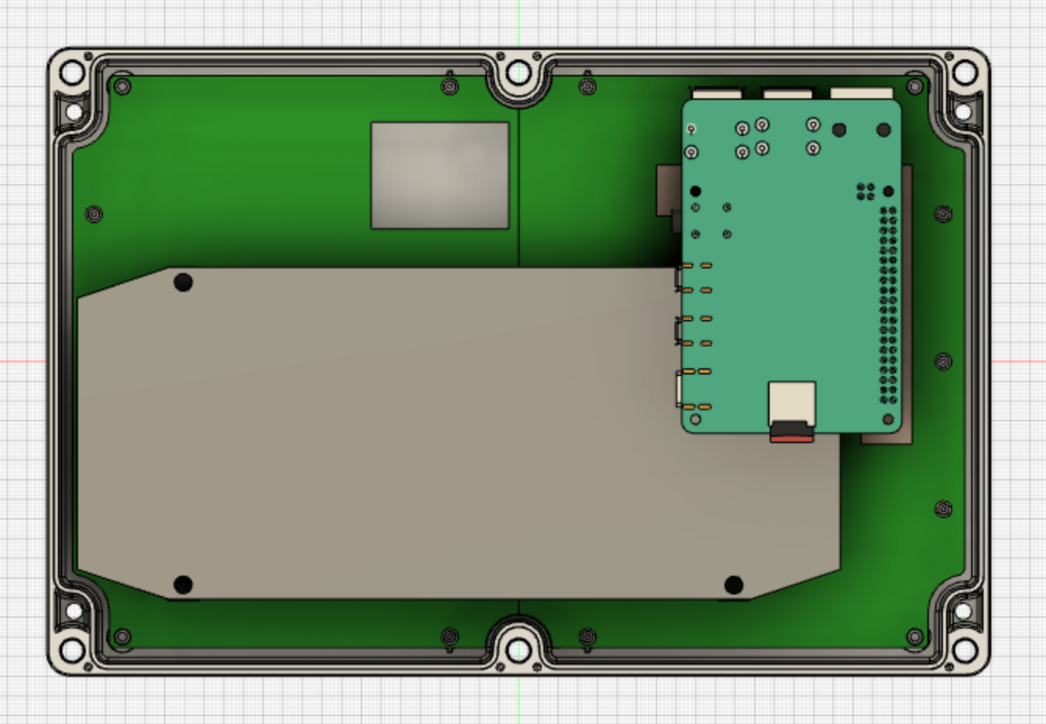
CAD/CAD_Bodenplatte/Bildschirmfoto 2021-04-14 um 16.39.55.png
