plastikpamaro/bachelorprojekt2020/CAD/CAD_Gehäuse/Gehäuse v3/Bildschirmfoto 2021-03-17 um 17.51.34.png

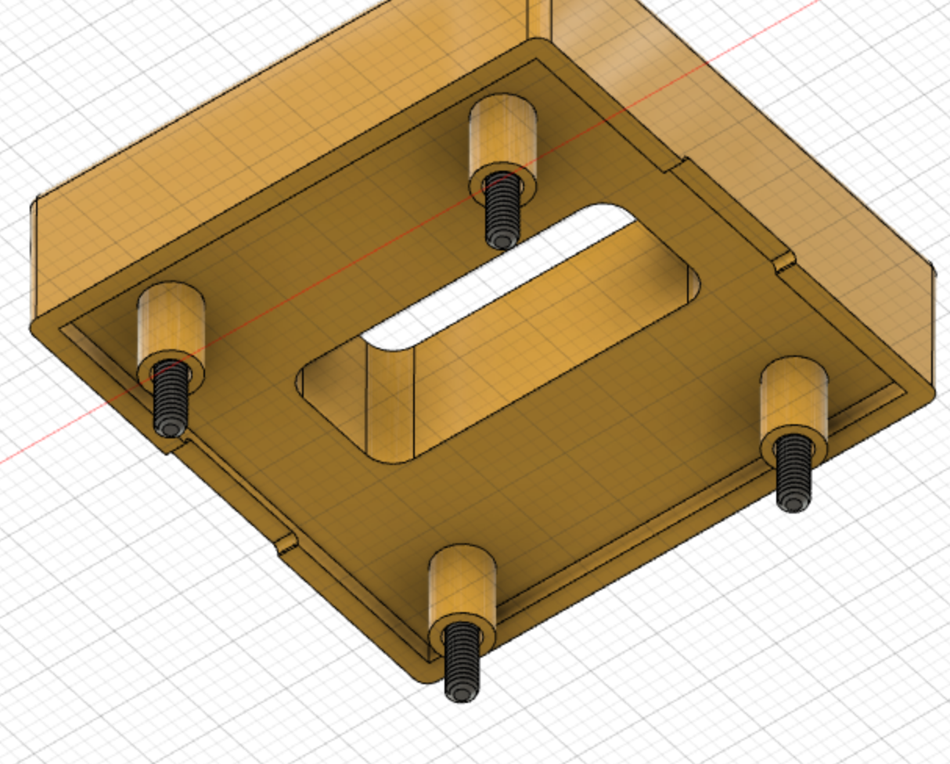
CAD/CAD_Gehäuse/Gehäuse v3/Bildschirmfoto 2021-03-17 um 17.51.34.png
