plastikpamaro/bachelorprojekt2020/Dokumentation/Sections/Brainstorming/Blickwinkel_Blitzer.jpeg

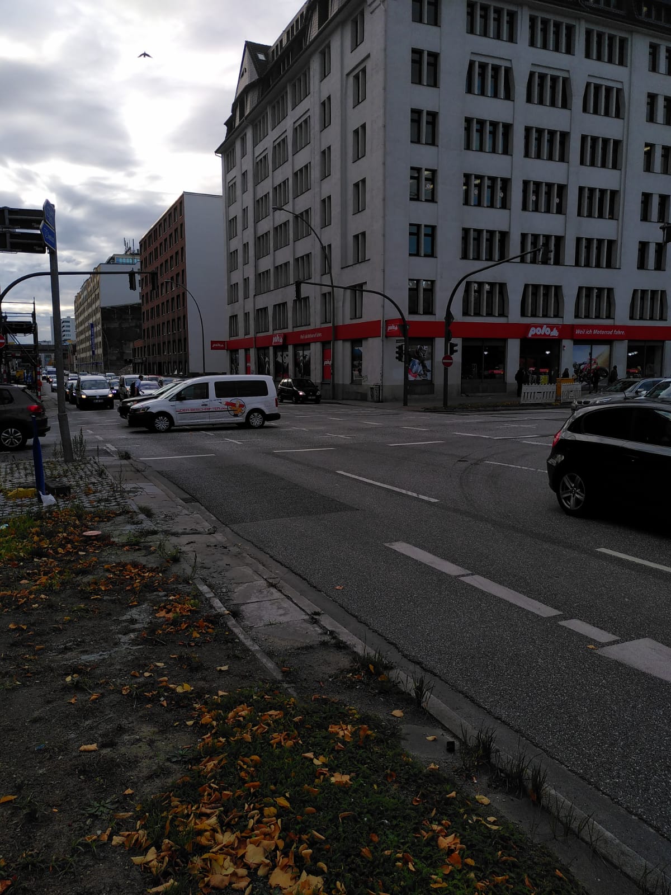
Dokumentation/Sections/Brainstorming/Blickwinkel_Blitzer.jpeg
