plastikpamaro/bachelorprojekt2020/Dokumentenschleuse/Konzept_Skizze.jpg

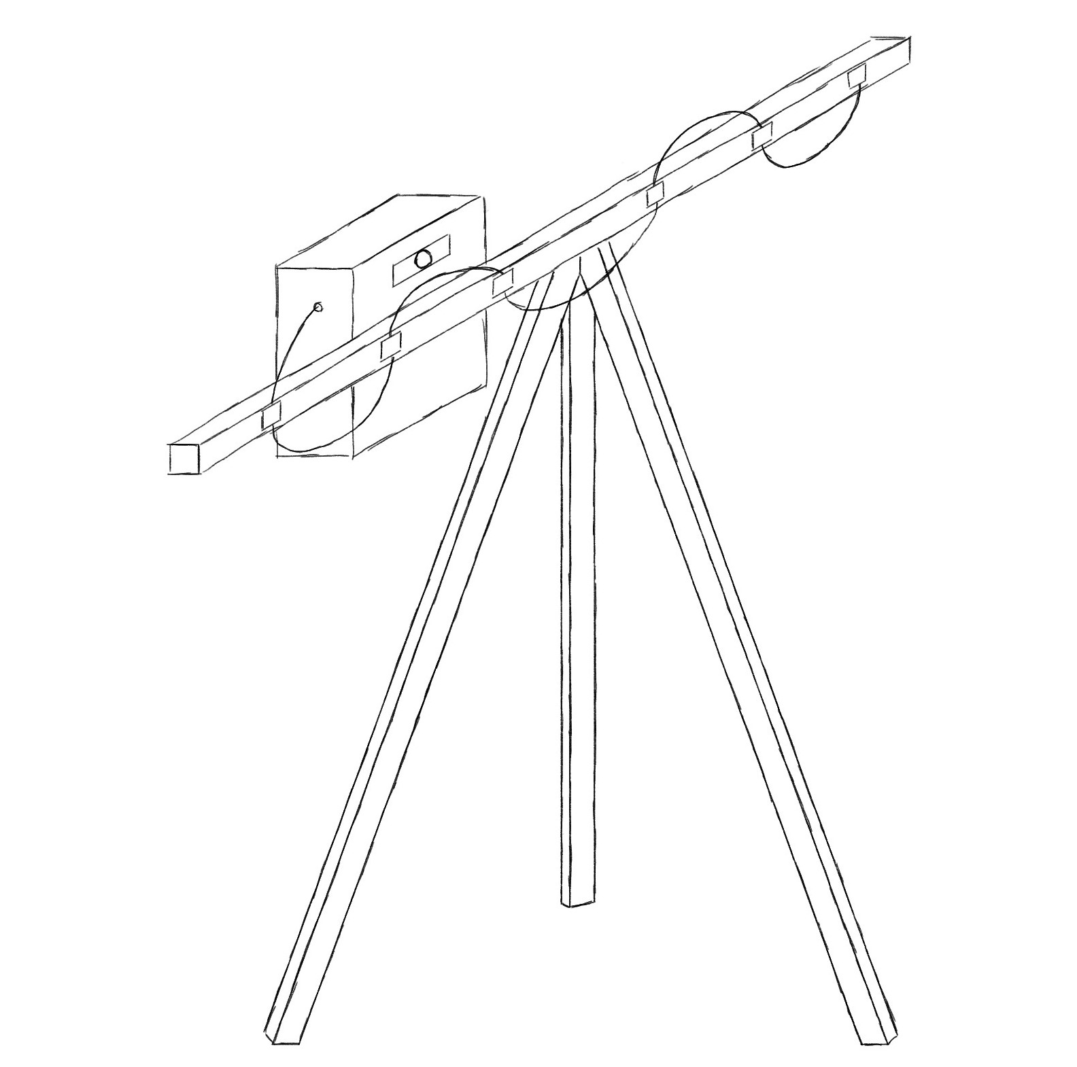
Dokumentenschleuse/Konzept_Skizze.jpg
