plastikpamaro/bachelorprojekt2020/Dokumentenschleuse/Programmablauf_V1.png

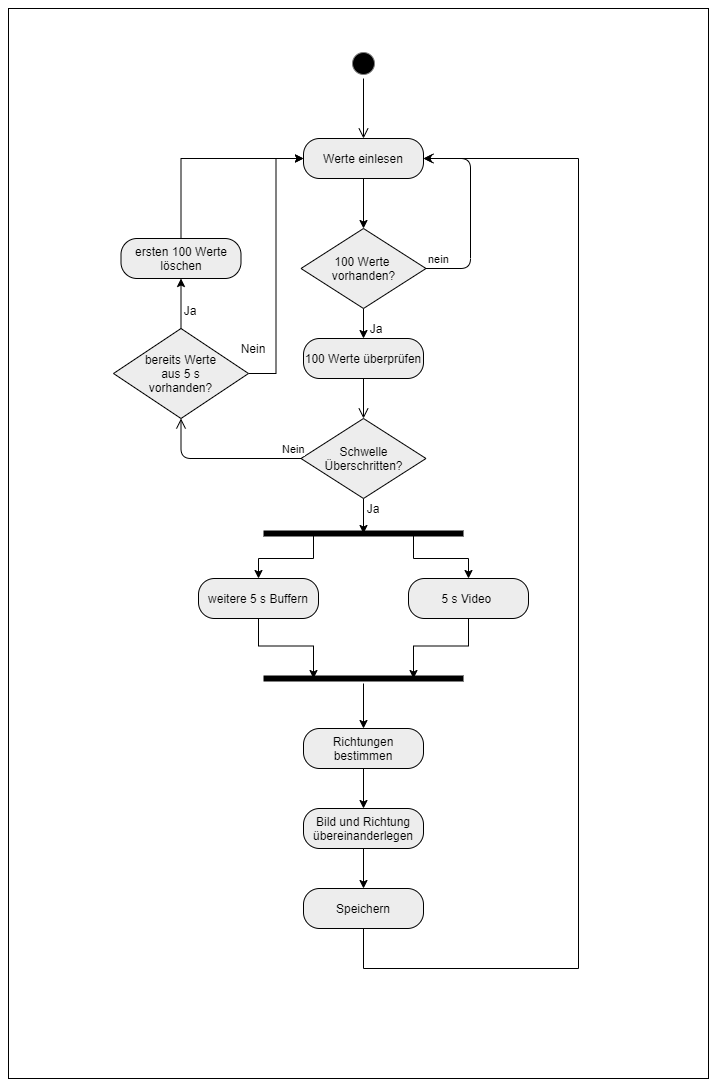
Dokumentenschleuse/Programmablauf_V1.png
