plastikpamaro/bachelorprojekt2020/Entwicklung/Klatsch1.png

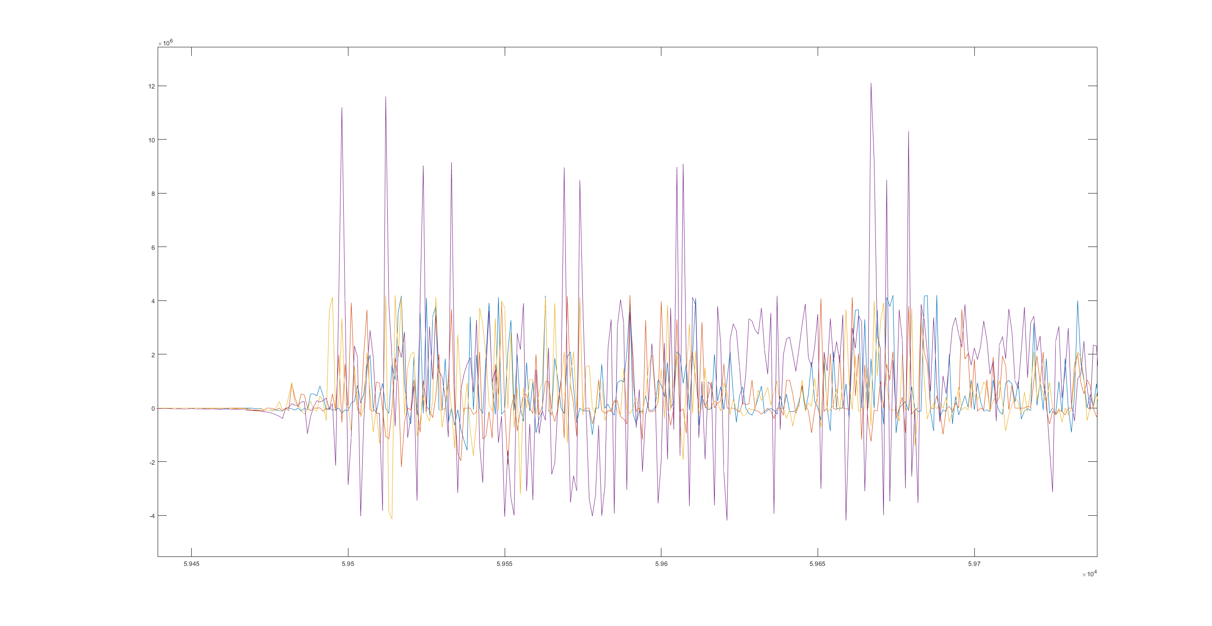
Entwicklung/Klatsch1.png
