plastikpamaro/bachelorprojekt2020/Entwicklung/Klatsch2.png

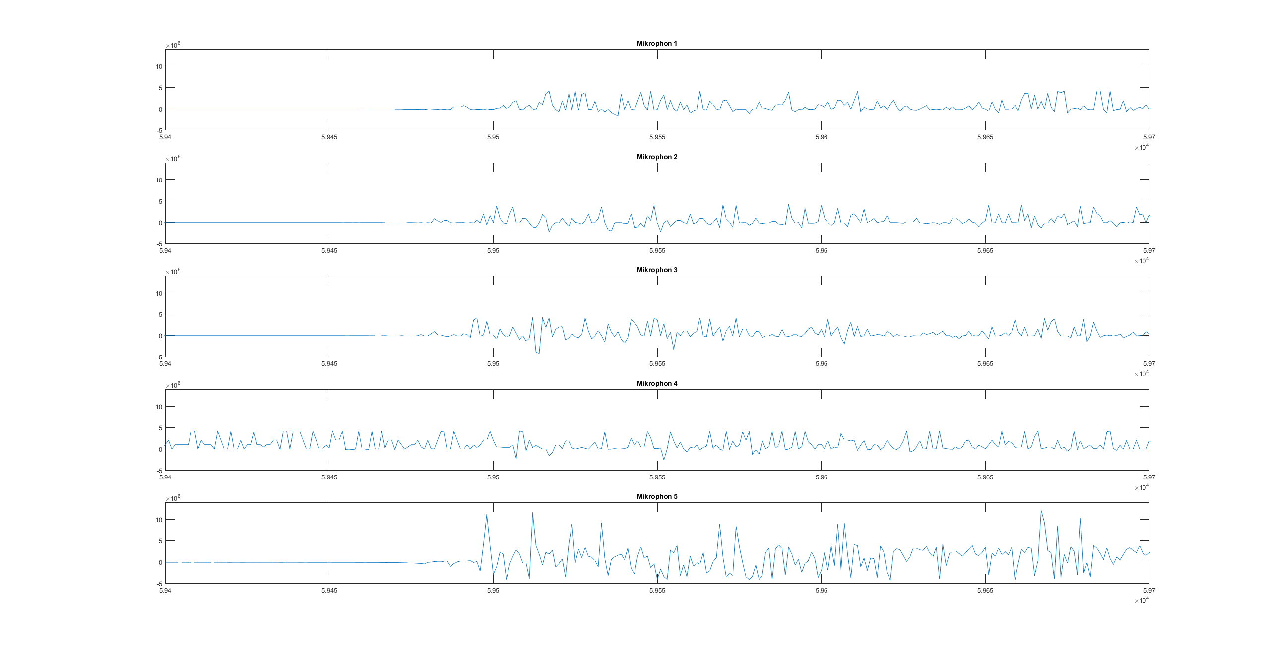
Entwicklung/Klatsch2.png
