plastikpamaro/bachelorprojekt2020/Entwicklung/Klatsch3.png

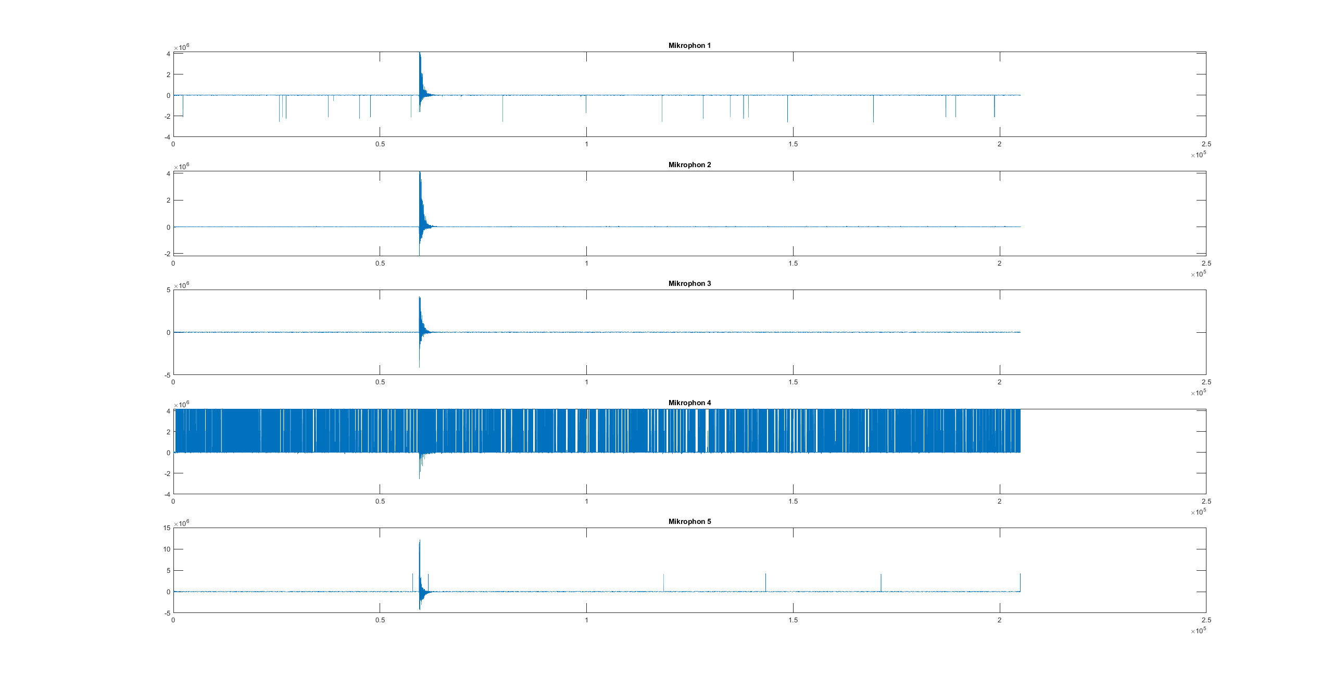
Entwicklung/Klatsch3.png
