plastikpamaro/bachelorprojekt2020/Pics/3D Druck/1.jpeg

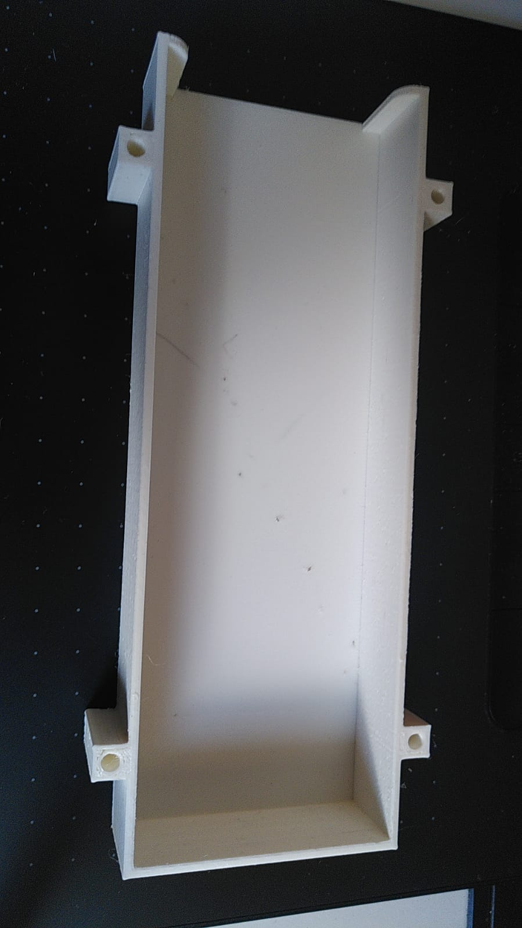
Pics/3D Druck/1.jpeg
