plastikpamaro/bachelorprojekt2020/Pics/3D Druck/2.jpeg

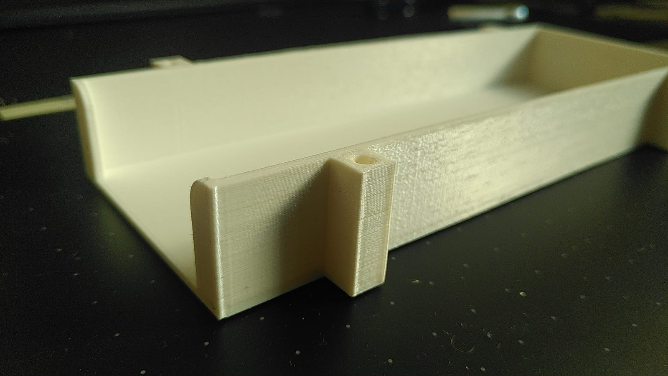
Pics/3D Druck/2.jpeg
