plastikpamaro/bachelorprojekt2020/Pics/3D Druck/3.jpeg

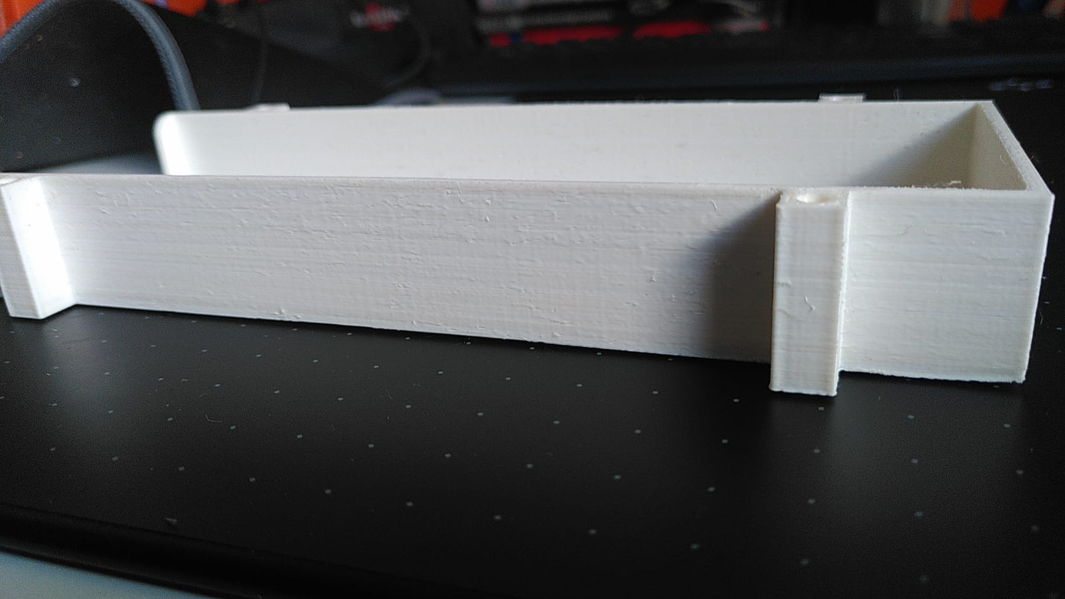
Pics/3D Druck/3.jpeg
