plastikpamaro/bachelorprojekt2020/Pics/3D Druck/4.jpeg

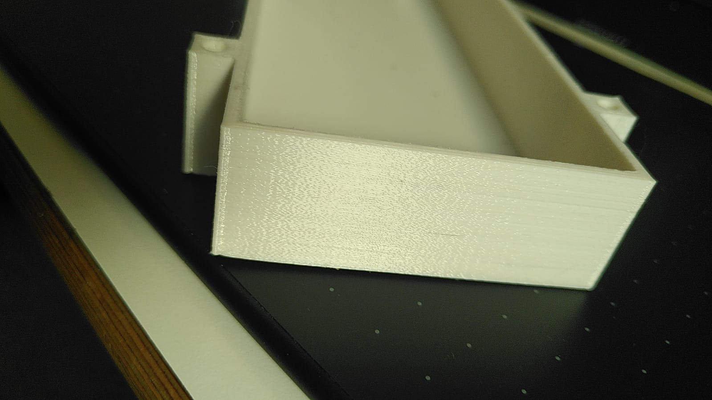
Pics/3D Druck/4.jpeg
