plastikpamaro/bachelorprojekt2020/Pics/3D Druck/5.jpeg

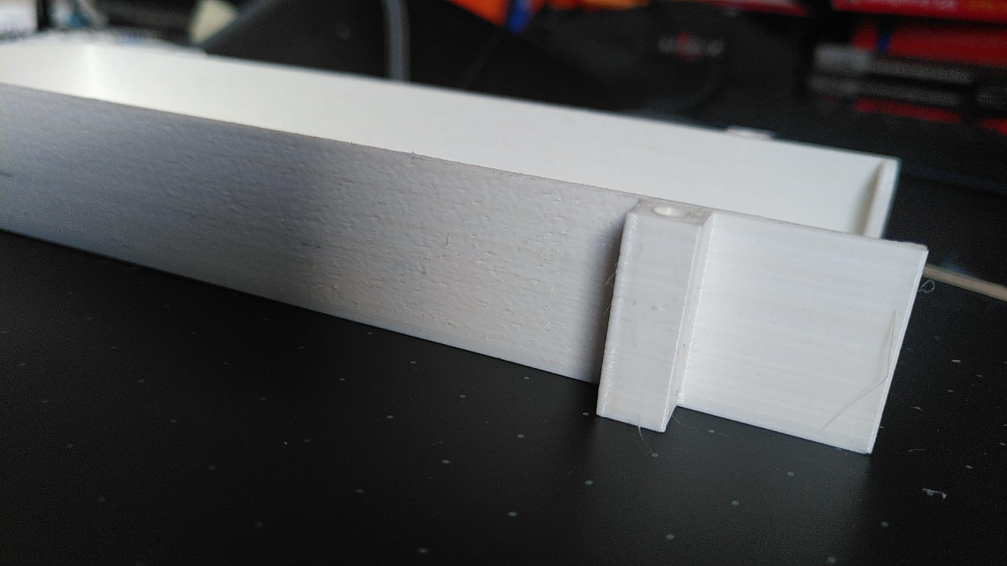
Pics/3D Druck/5.jpeg
