plastikpamaro/bachelorprojekt2020/Pics/3D Druck/6.jpeg

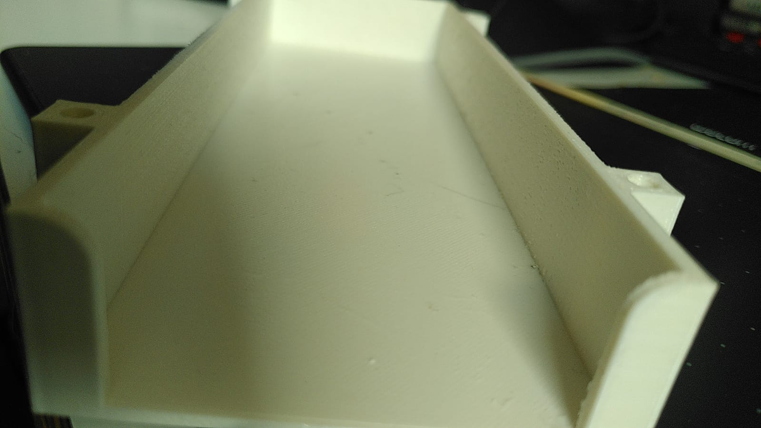
Pics/3D Druck/6.jpeg
