plastikpamaro/bachelorprojekt2020/Pics/3D Druck/7.jpeg

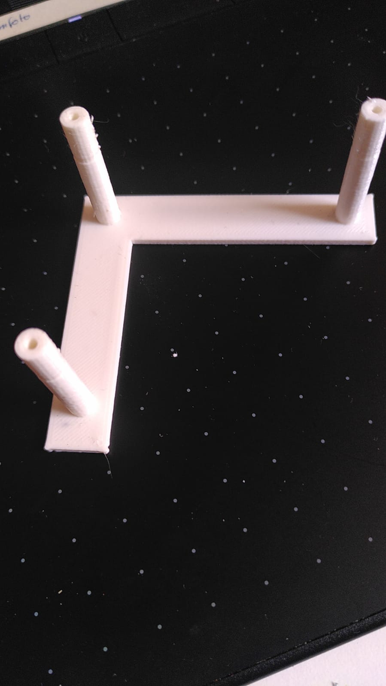
Pics/3D Druck/7.jpeg
