plastikpamaro/bachelorprojekt2020/Pics/3D Druck/8.jpeg

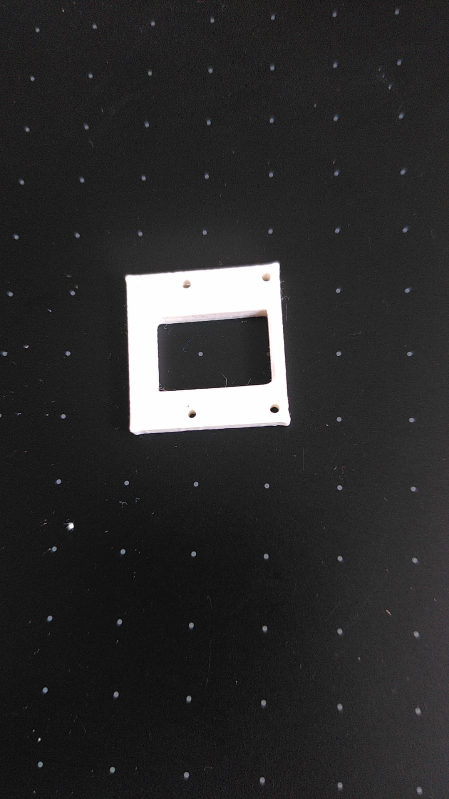
Pics/3D Druck/8.jpeg
