plastikpamaro/bachelorprojekt2020/Pics/20-12-13 Mikrophone div Ansichten/IMG_20201105_154216.jpg

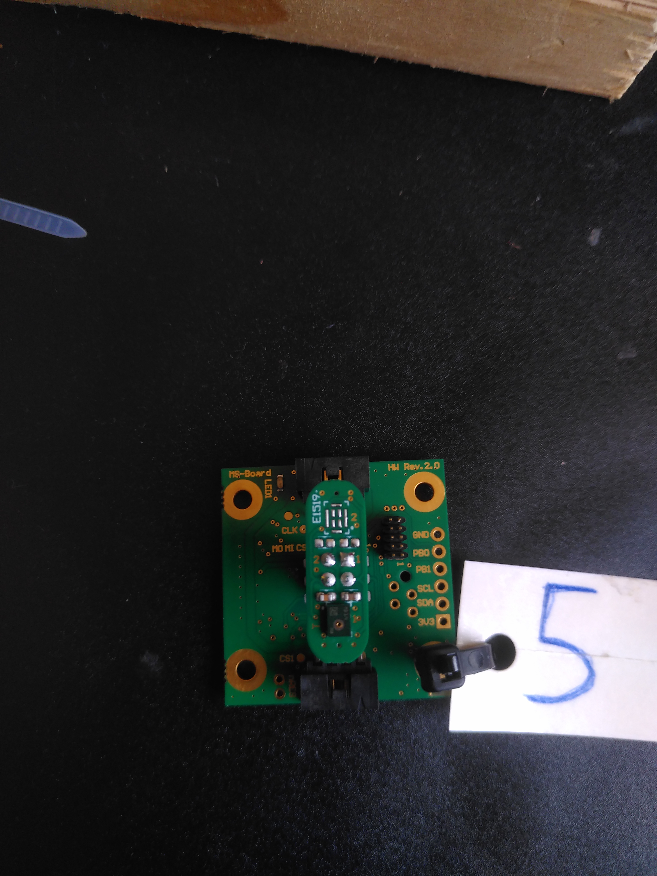
Pics/20-12-13 Mikrophone div Ansichten/IMG_20201105_154216.jpg
