plastikpamaro/bachelorprojekt2020/Pics/Herausforderungen/21-03-22-Druckfehler-im-Gehäusedeckel.jpeg

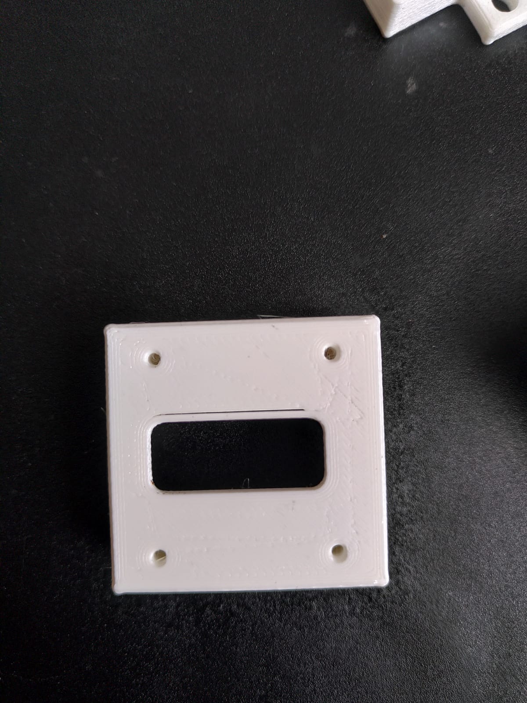
Pics/Herausforderungen/21-03-22-Druckfehler-im-Gehäusedeckel.jpeg
