plastikpamaro/bachelorprojekt2020/Pics/Stecker/Front_1.jpg

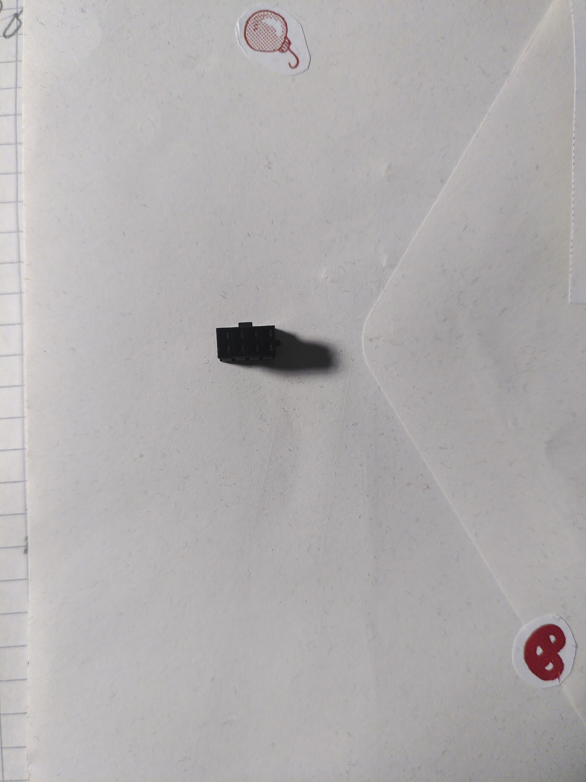
Pics/Stecker/Front_1.jpg
