plastikpamaro/bachelorprojekt2020/Pics/Zusammenbau Mikrophongehäuse/Boden.jpeg

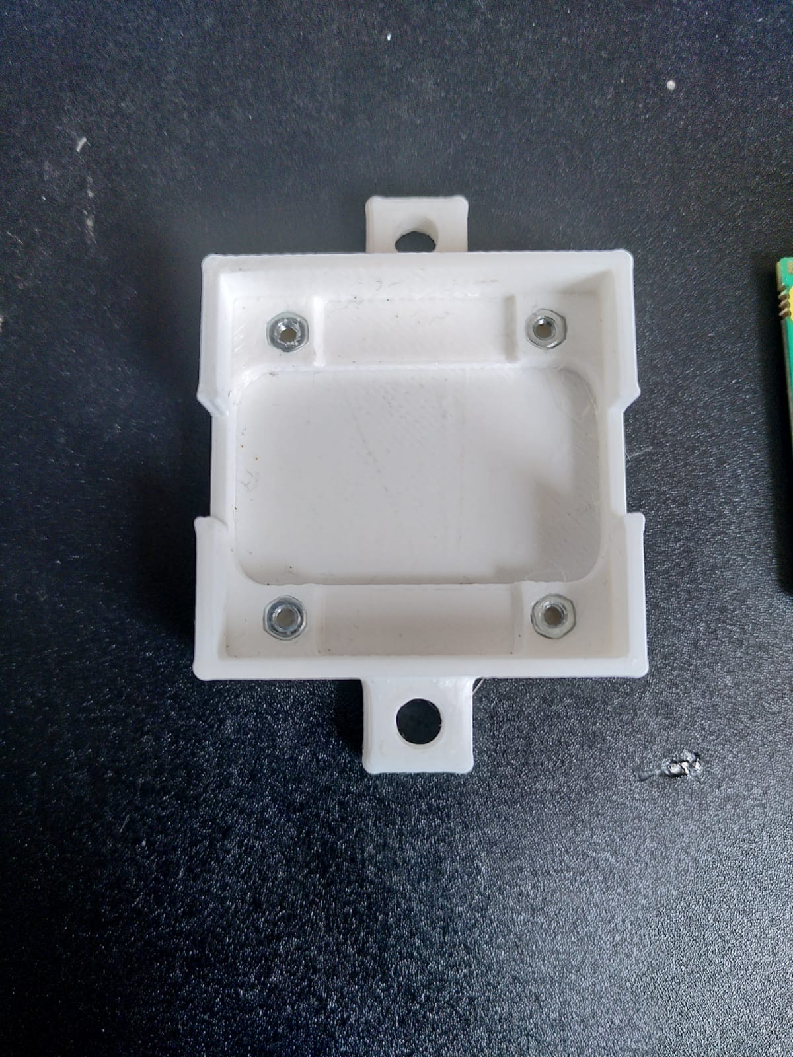
Pics/Zusammenbau Mikrophongehäuse/Boden.jpeg
