plastikpamaro/bachelorprojekt2020/Pics/Zusammenbau Mikrophongehäuse/geschlossen 1.jpeg

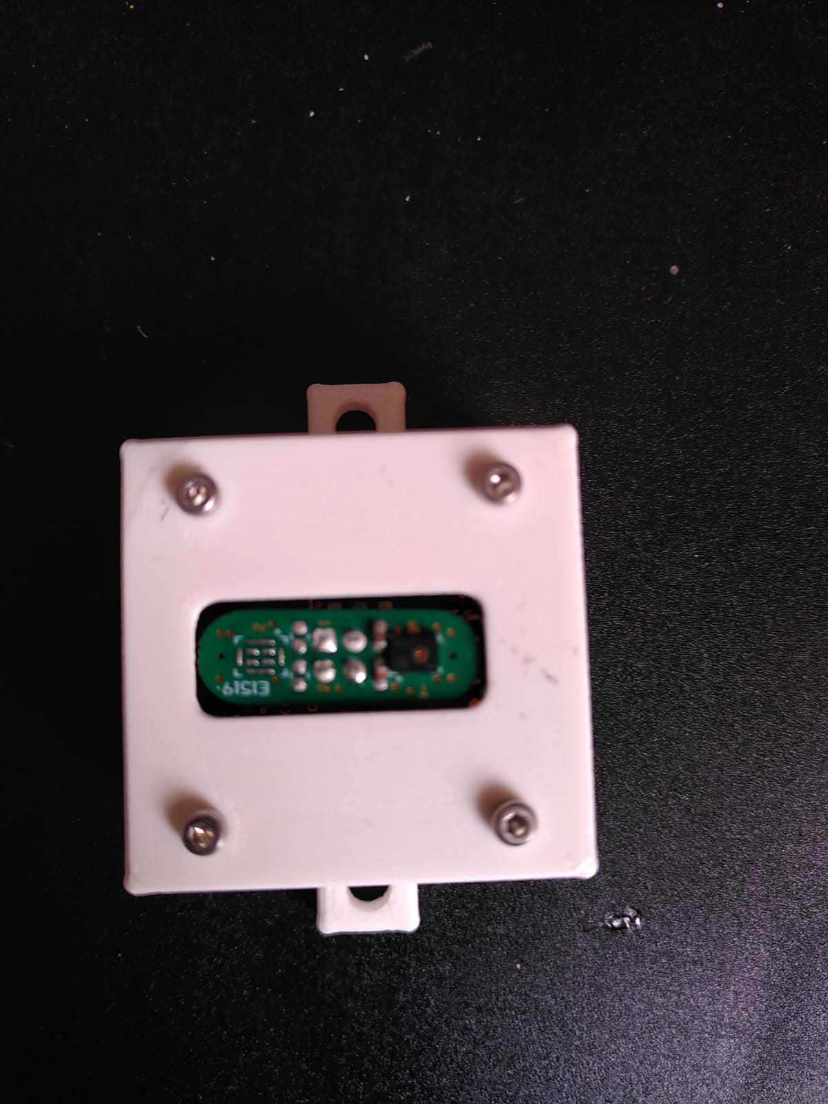
Pics/Zusammenbau Mikrophongehäuse/geschlossen 1.jpeg
