plastikpamaro/bachelorprojekt2020/Pics/Zusammenbau Mikrophongehäuse/geschlossen 2.jpeg

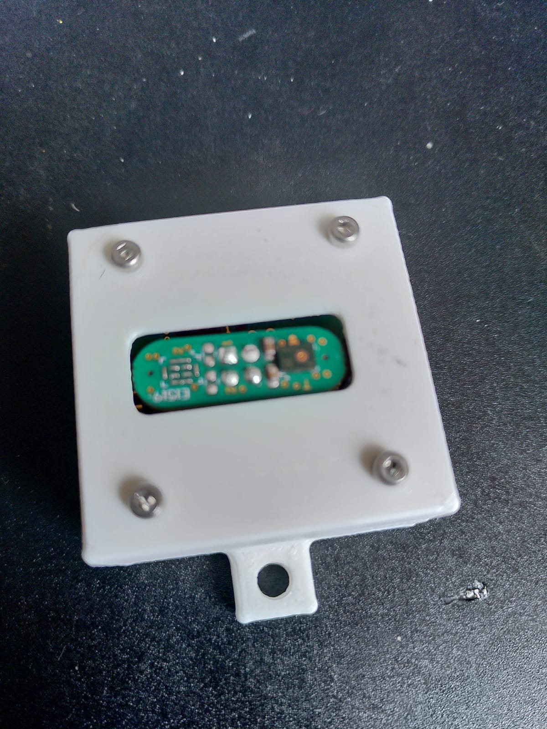
Pics/Zusammenbau Mikrophongehäuse/geschlossen 2.jpeg
