plastikpamaro/bachelorprojekt2020/Pics/Zusammenbau Mikrophongehäuse/offen.jpeg

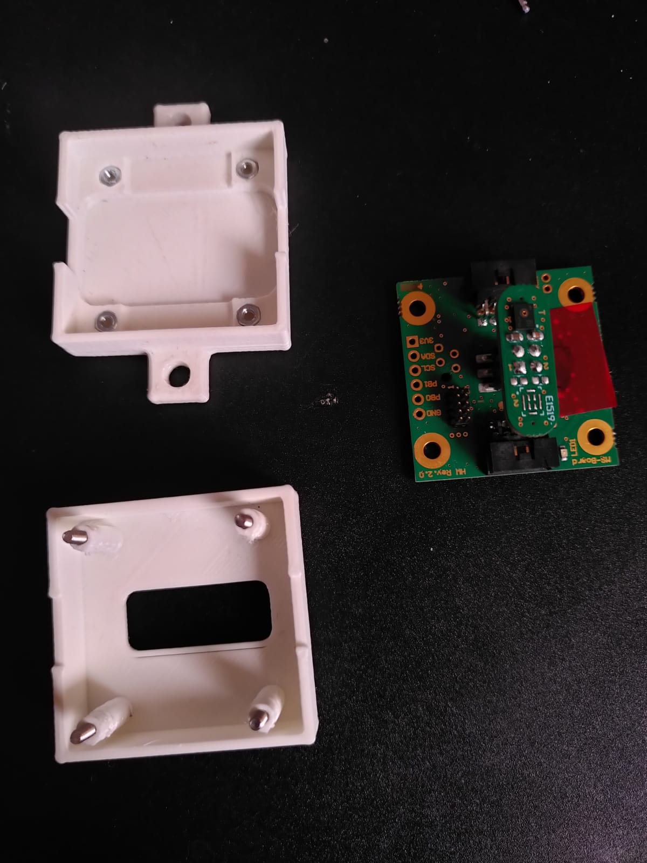
Pics/Zusammenbau Mikrophongehäuse/offen.jpeg
