plastikpamaro/bachelorprojekt2020/Dokumentenschleuse/Stückliste_Mechanik_21_03_04.xlsx

Bezeichnung | Stückzahl | Artikelnummer | Preis | Händler | Internet
Alu_Profil_5_1000x20x20 | 1 | ART01743 | 4.70 € | CAP Alu Profil System | http://shop.aluprofil.com/de_DE/shop/Baureihe_5/Profile_5/ART01743_Profil_5_20x20.html?currency=EUR
Nutstein_5_St_M4 | 12 | ART01766 | 2.76 € | CAP Alu Profil System | http://shop.aluprofil.com/de_DE/shop/Baureihe_5/Befestigungselemente_5/ART01766_Nutenstein_5_M4.html
Zylinderkopfschraube_DIN_912_M4x10 | 12 | 10798130 | 2.30 € | Bauhaus | https://www.bauhaus.info/gewindeschrauben/stabilit-zylinderschraube/p/10798130
Rollei_Compact_Traveler_No1 | 1 | 76240 | 64.02 € | Foto Koch | https://www.fotokoch.de/Rollei-Compact-Traveler-No-1-orange_76240.html?redirect=76240&partnerid=10331
 |  | Gesamtpreis: | 73.78 €
