plastikpamaro/bachelorprojekt2020/21-02-19-Kickoff/Studienarbeit/GehäuseCad/Standardteile/3Dfiles/MSB_PCB_with_mic_pcb/MSB_PCB_with_mic_pcb.step

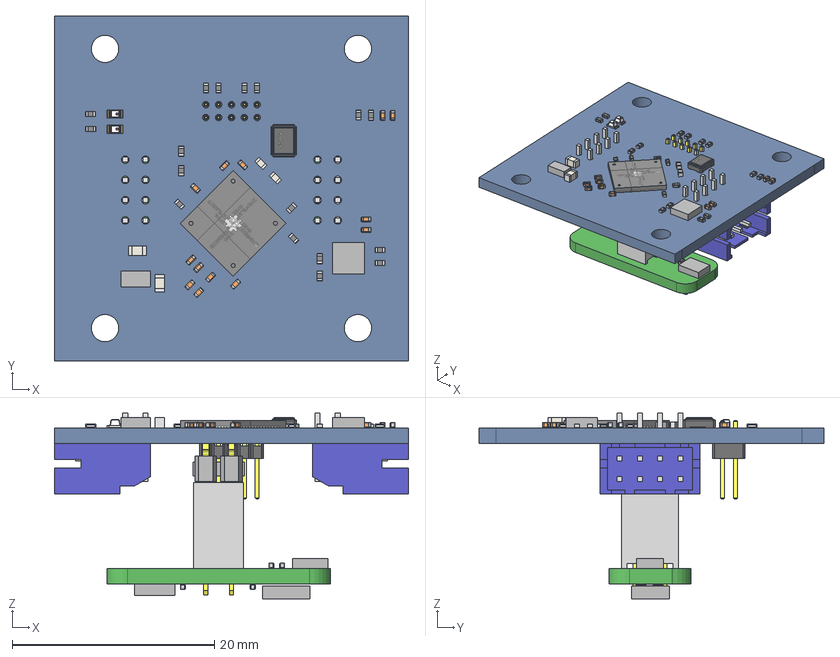
[picture p176: CAD file, 2020-12-13]
21-02-19-Kickoff/Studienarbeit/GehäuseCad/Standardteile/3Dfiles/MSB_PCB_with_mic_pcb/MSB_PCB_with_mic_pcb.step
35.0 x 34.1 x 18.3 mm
Board
_TSM-102-01-DV_body
_T-1S6-16(-01-2-DV)
mic_pcb_with_socket
RESC1005X40 x 17
CAPC1005X55 x 13
LEDC1608X80N_RED x 2
Extruded x 14
User_Library-QFN_40_5x5 x 4
PLL1_27-10
S8B-PHDSS x 2
User_Library-ABM8G
