plastikpamaro/bachelorprojekt2020/21-02-19-Kickoff/Studienarbeit/GehäuseCad/Standardteile/3Dfiles/MSB_PCB_with_mic_pcb_molex/MSB_PCB_with_mic_pcb_molex.step

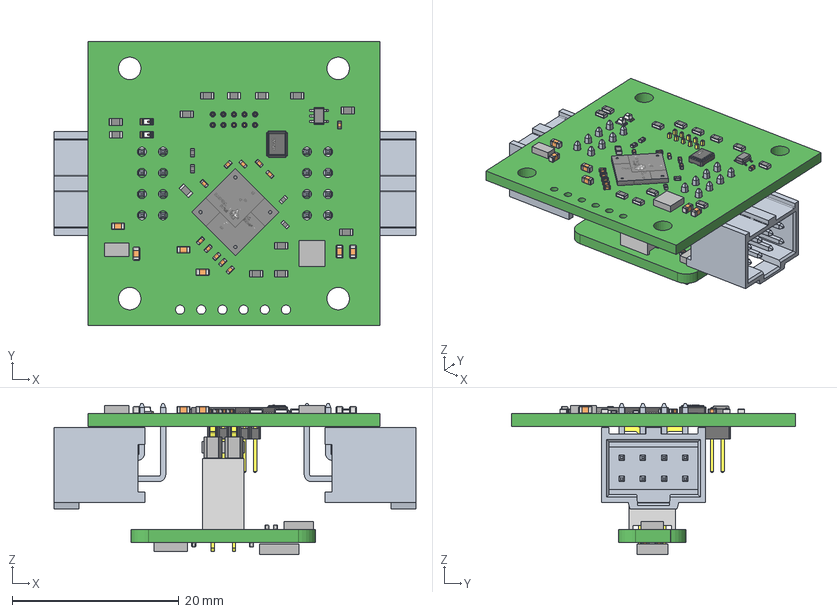
[picture p177: CAD file, 2020-12-13]
21-02-19-Kickoff/Studienarbeit/GehäuseCad/Standardteile/3Dfiles/MSB_PCB_with_mic_pcb_molex/MSB_PCB_with_mic_pcb_molex.step
43.4 x 34.1 x 18.1 mm
Board
CAPC1608X85 x 6
User_Library-ABM8G
Extruded x 2
molex-90130-3208 x 2
RESC1608X55 x 13
CAPC1005X55 x 11
PLL1_27-10
User_Library-QFN_40_5x5 x 4
LEDC1608X80N_RED x 2
RESC1005X40 x 4
_TSM-102-01-DV_body
_T-1S6-16(-01-2-DV)
mic_pcb_with_socket
BODY_MAA05
LEADS_MAA05A_3
LEADS_MAA05A_4
LEADS_MAA05A_5
LEADS_MAA05A_6
LEADS_MAA05A_7
