plastikpamaro/bachelorprojekt2020/21-02-19-Kickoff/Studienarbeit/GehäuseCad/Standardteile/Designer/1_STEP_MODELLE/mic_pcb_with_socket2.step

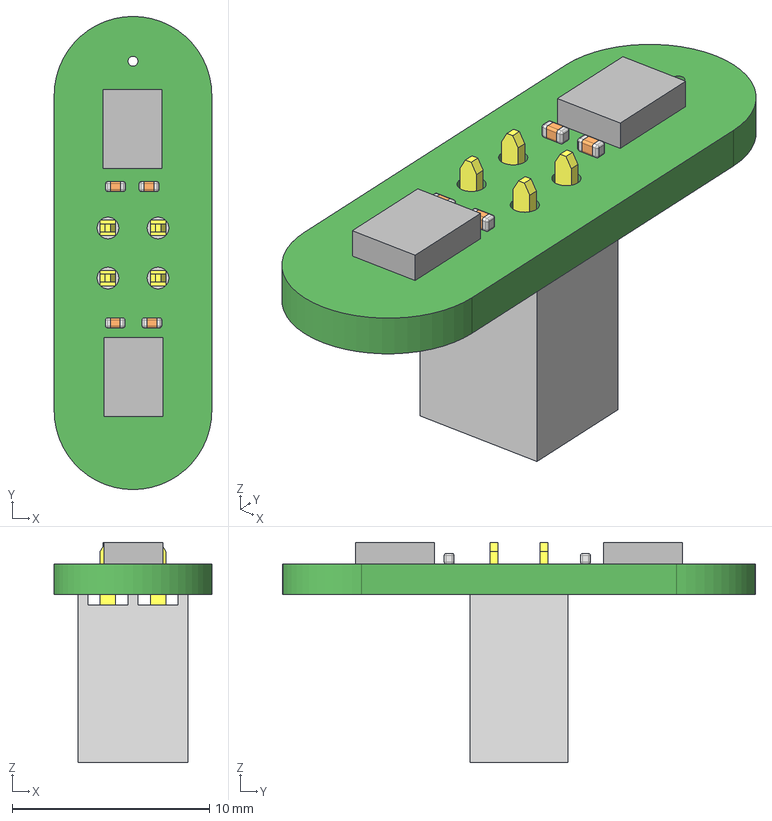
[picture p178: CAD file, 2020-12-14]
21-02-19-Kickoff/Studienarbeit/GehäuseCad/Standardteile/Designer/1_STEP_MODELLE/mic_pcb_with_socket2.step
8.00 x 24.0 x 11.2 mm
Board
_SSW-102-01-T-D_terminal
_SSW-102-01-T-D_pin
Extruded x 2
CAPC1005X55 x 4
