plastikpamaro/bachelorprojekt2020/21-02-19-Kickoff/Studienarbeit/GehäuseCad/Standardteile/Raspi 4/raspberry-pi-4B/VIA VL805 PCIe USB 3.0 controller, RPi4ModelB.SLDPRT

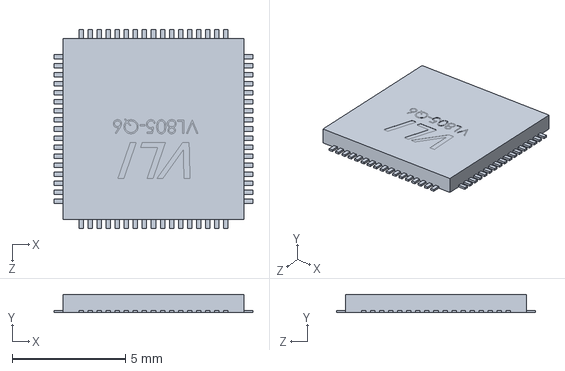
[picture p179: CAD file, 2020-12-13]
21-02-19-Kickoff/Studienarbeit/GehäuseCad/Standardteile/Raspi 4/raspberry-pi-4B/VIA VL805 PCIe USB 3.0 controller, RPi4ModelB.SLDPRT
8.80 x 0.8 x 8.80 mm
