plastikpamaro/bachelorprojekt2020/CAD/CAD_Bodenplatte/L_mit Stützen.stl

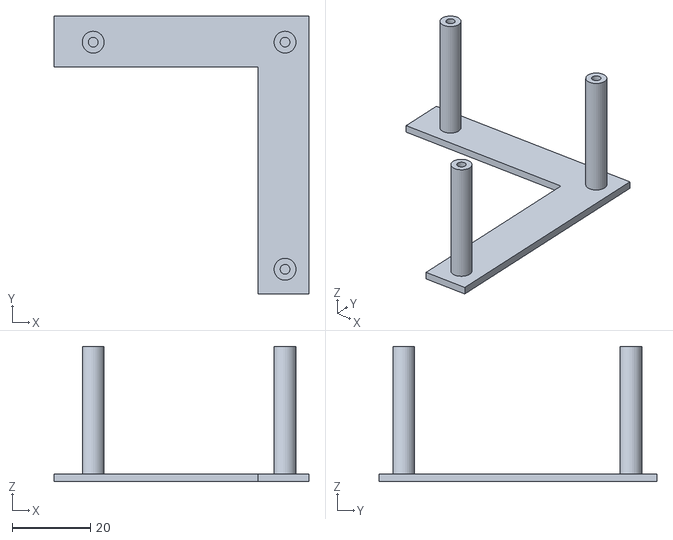
[picture p180: CAD file, 2021-04-14]
CAD/CAD_Bodenplatte/L_mit Stützen.stl
65.0 x 71.0 x 34.6
