plastikpamaro/bachelorprojekt2020/CAD/CAD_Gehäuse/Gehäuse v3/Deckel_21_03_18.stl

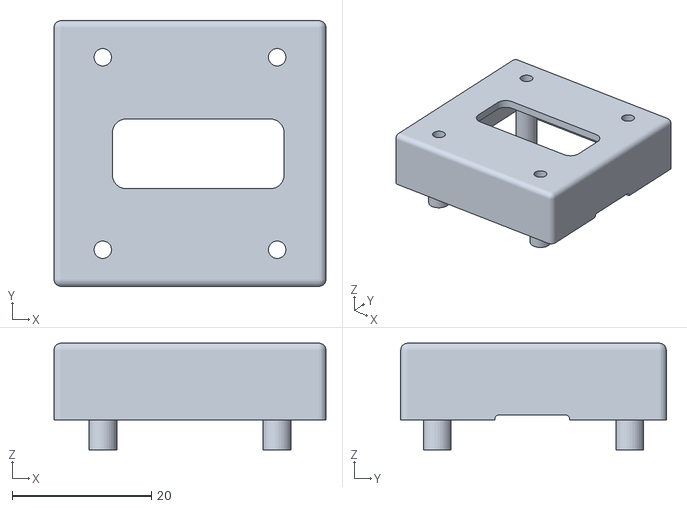
[picture p181: CAD file, 2021-03-18]
CAD/CAD_Gehäuse/Gehäuse v3/Deckel_21_03_18.stl
39.0 x 38.1 x 15.3
