plastikpamaro/bachelorprojekt2020/21-02-19-Kickoff/Studienarbeit/GehäuseCad/Standardteile/Designer/1_STEP_MODELLE/mic_pcb_L24_R8.step

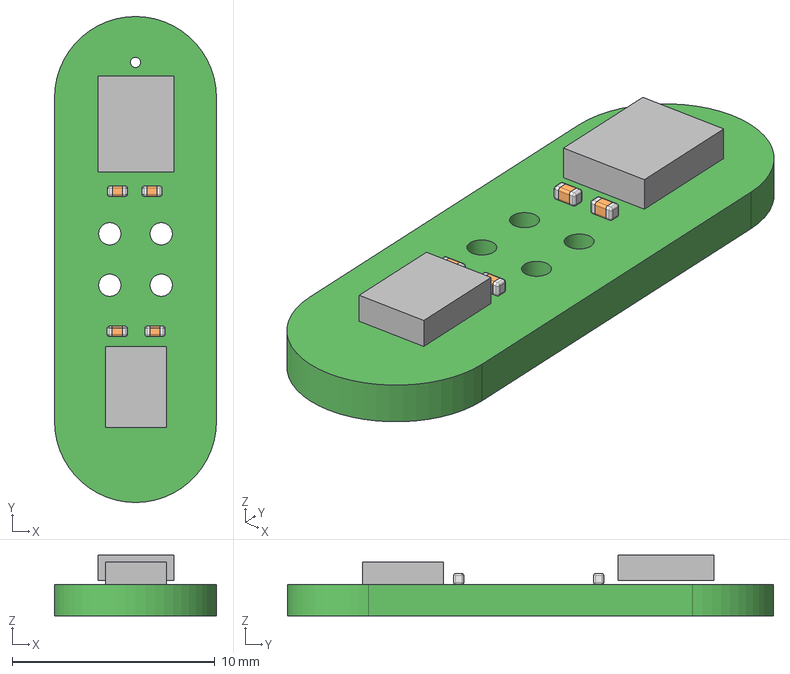
[picture p182: CAD file, 2020-12-14]
21-02-19-Kickoff/Studienarbeit/GehäuseCad/Standardteile/Designer/1_STEP_MODELLE/mic_pcb_L24_R8.step
8.00 x 24.0 x 3.00 mm
Board
Extruded x 2
CAPC1005X55 x 4
