plastikpamaro/bachelorprojekt2020/21-02-19-Kickoff/Studienarbeit/GehäuseCad/Standardteile/Raspi 4/raspberry-pi-4B/Microphone Plug, RPi4ModelB.SLDPRT

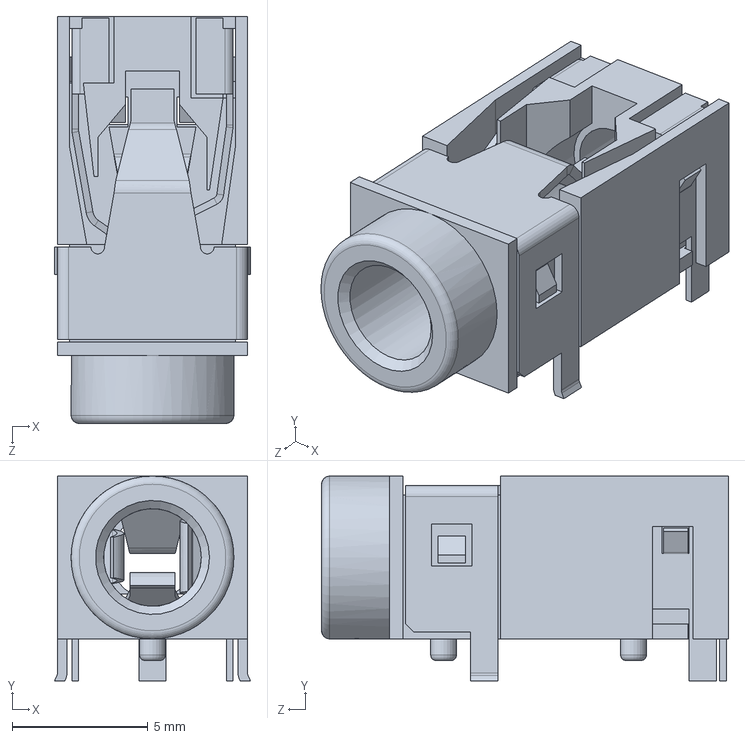
[picture p183: CAD file, 2020-12-13]
21-02-19-Kickoff/Studienarbeit/GehäuseCad/Standardteile/Raspi 4/raspberry-pi-4B/Microphone Plug, RPi4ModelB.SLDPRT
7.23 x 7.55 x 15.0 mm
