plastikpamaro/bachelorprojekt2020/CAD/CAD_Gehäuse/Gehäuse v3/Boden_21_03_18.stl

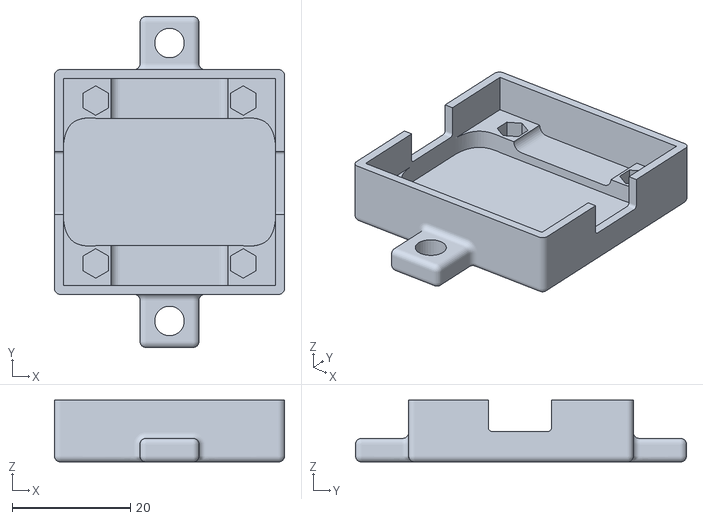
[picture p185: CAD file, 2021-03-18]
CAD/CAD_Gehäuse/Gehäuse v3/Boden_21_03_18.stl
39.0 x 56.1 x 10.5
