plastikpamaro/bachelorprojekt2020/21-02-19-Kickoff/Studienarbeit/GehäuseCad/Standardteile/Designer/1_STEP_MODELLE/mic_pcb_with_socket.step

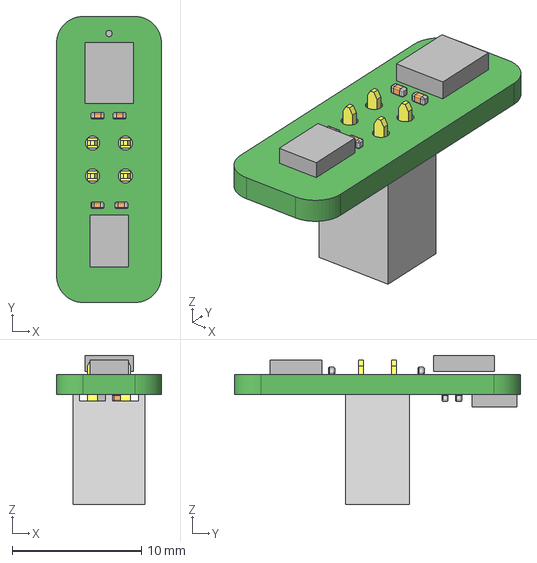
[picture p186: CAD file, 2020-12-14]
21-02-19-Kickoff/Studienarbeit/GehäuseCad/Standardteile/Designer/1_STEP_MODELLE/mic_pcb_with_socket.step
8.10 x 22.1 x 11.5 mm
