plastikpamaro/bachelorprojekt2020/21-02-19-Kickoff/Studienarbeit/GehäuseCad/Standardteile/Raspi 4/raspberry-pi-4B/2X USB2.0 PORTS, RPi4ModelB.SLDPRT

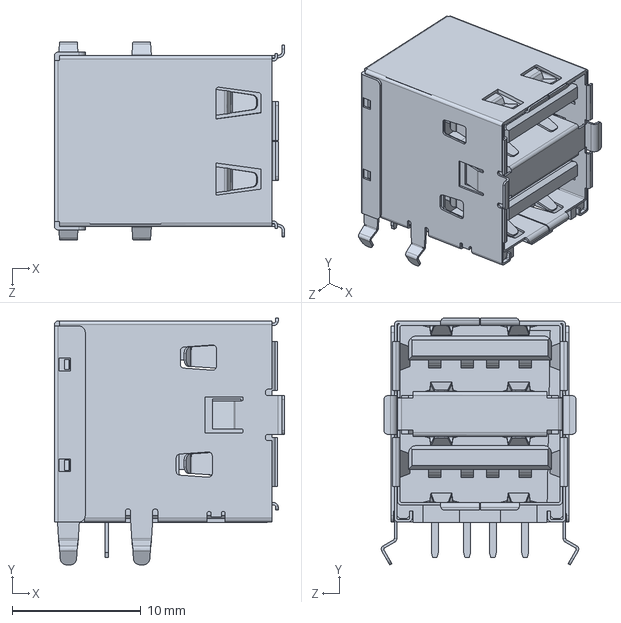
[picture p187: CAD file, 2020-12-13]
21-02-19-Kickoff/Studienarbeit/GehäuseCad/Standardteile/Raspi 4/raspberry-pi-4B/2X USB2.0 PORTS, RPi4ModelB.SLDPRT
17.9 x 19.2 x 15.3 mm
