plastikpamaro/bachelorprojekt2020/CAD/CAD_Bodenplatte/Spacer Kamara.stl

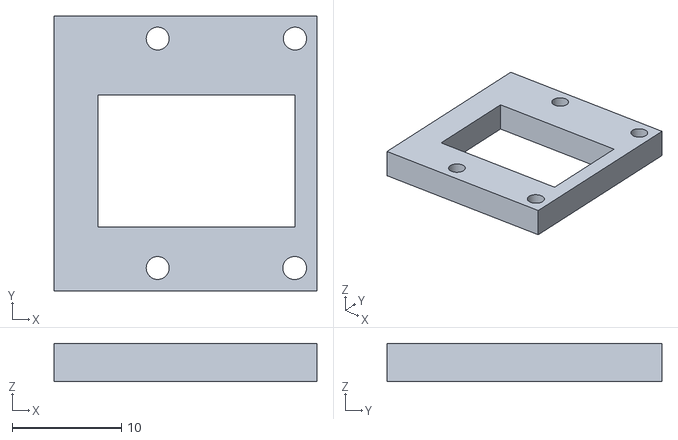
[picture p188: CAD file, 2021-04-14]
CAD/CAD_Bodenplatte/Spacer Kamara.stl
24.0 x 25.2 x 3.50
