plastikpamaro/bachelorprojekt2020/CAD/CAD_Gehäuse/Gehäuse v3/Boden_21_03_17.stl

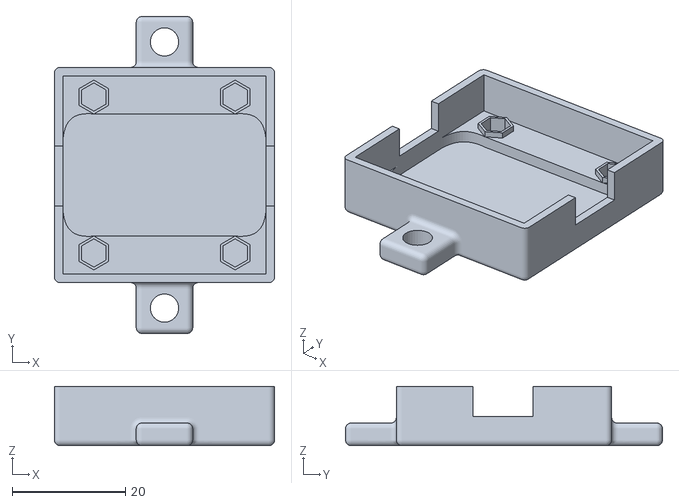
[picture p189: CAD file, 2021-03-17]
CAD/CAD_Gehäuse/Gehäuse v3/Boden_21_03_17.stl
39.0 x 56.1 x 10.5
