plastikpamaro/bachelorprojekt2020/CAD/CAD_Bodenplatte/Halter Powerbank neu.stl

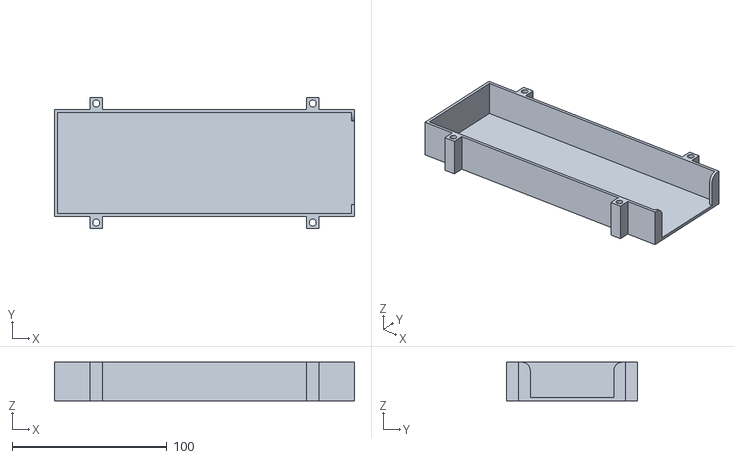
[picture p190: CAD file, 2021-04-14]
CAD/CAD_Bodenplatte/Halter Powerbank neu.stl
194.0 x 85.0 x 25.0
