plastikpamaro/bachelorprojekt2020/CAD/CAD_Gehäuse/Gehäuse v3/Deckel_21_03_17.stl

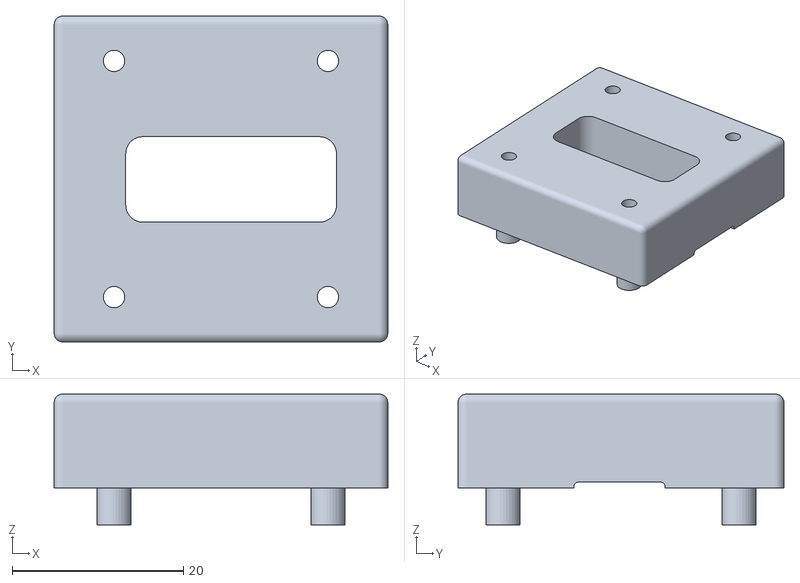
[picture p191: CAD file, 2021-03-17]
CAD/CAD_Gehäuse/Gehäuse v3/Deckel_21_03_17.stl
39.0 x 38.1 x 15.3
