plastikpamaro/bachelorprojekt2020/21-02-19-Kickoff/Studienarbeit/GehäuseCad/Standardteile/Designer/1_STEP_MODELLE/mic_pcb.step

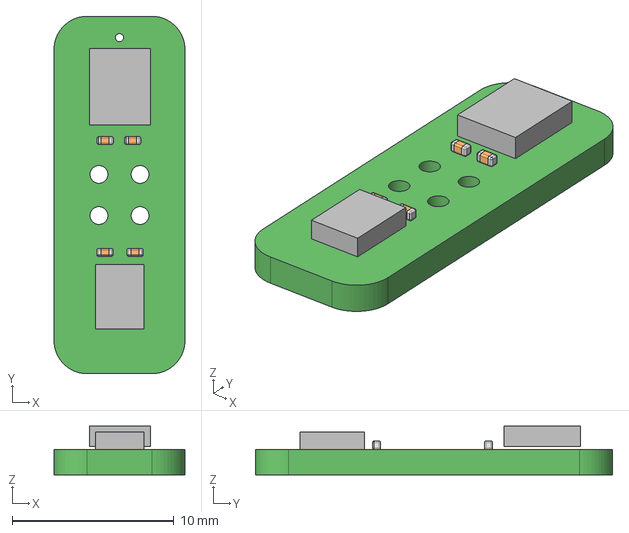
[picture p192: CAD file, 2020-12-14]
21-02-19-Kickoff/Studienarbeit/GehäuseCad/Standardteile/Designer/1_STEP_MODELLE/mic_pcb.step
8.10 x 22.1 x 3.00 mm
