plastikpamaro/bachelorprojekt2020/21-02-19-Kickoff/Studienarbeit/GehäuseCad/Standardteile/Raspi 4/raspberry-pi-4B/Female Micro HDMI Connector, RPi4ModelB.SLDPRT

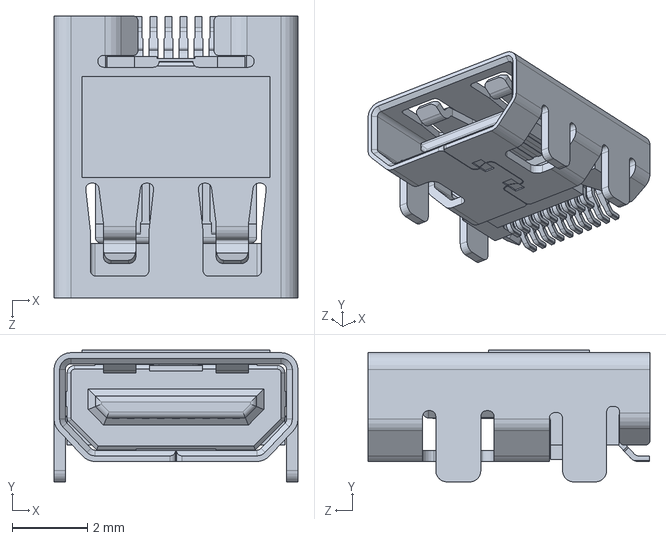
[picture p193: CAD file, 2020-12-13]
21-02-19-Kickoff/Studienarbeit/GehäuseCad/Standardteile/Raspi 4/raspberry-pi-4B/Female Micro HDMI Connector, RPi4ModelB.SLDPRT
6.50 x 3.52 x 7.50 mm
