plastikpamaro/bachelorprojekt2020/CAD/CAD_Bodenplatte/Bodenplatte_oben.stl

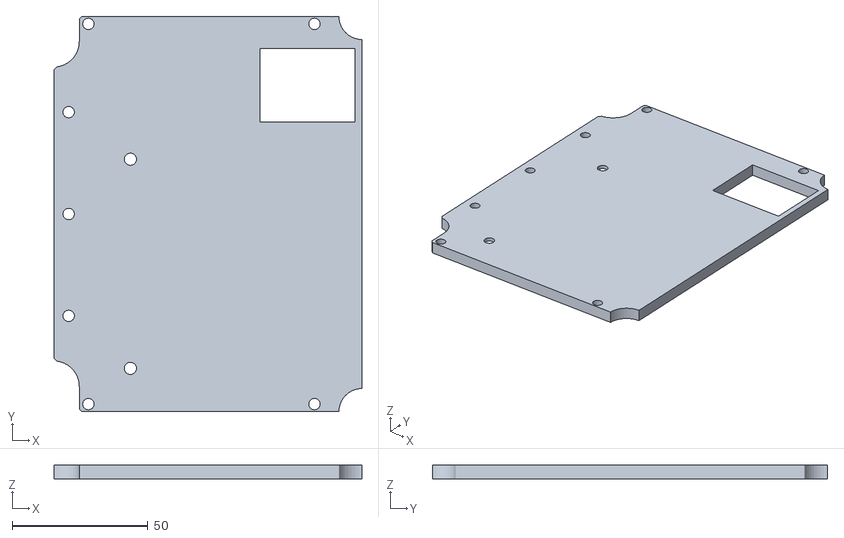
[picture p194: CAD file, 2021-04-14]
CAD/CAD_Bodenplatte/Bodenplatte_oben.stl
113.4 x 145.5 x 5.00
