plastikpamaro/bachelorprojekt2020/CAD/CAD_Bodenplatte/Abdeckplatte Powerbank.stl

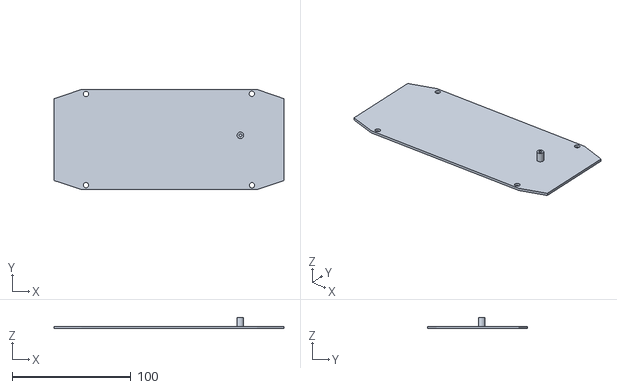
[picture p195: CAD file, 2021-04-14]
CAD/CAD_Bodenplatte/Abdeckplatte Powerbank.stl
194.0 x 84.4 x 9.56
