plastikpamaro/bachelorprojekt2020/21-02-19-Kickoff/Studienarbeit/GehäuseCad/Standardteile/Raspi 4/raspberry-pi-4B/Female USB Type C Connector, RPi4ModelB.SLDPRT

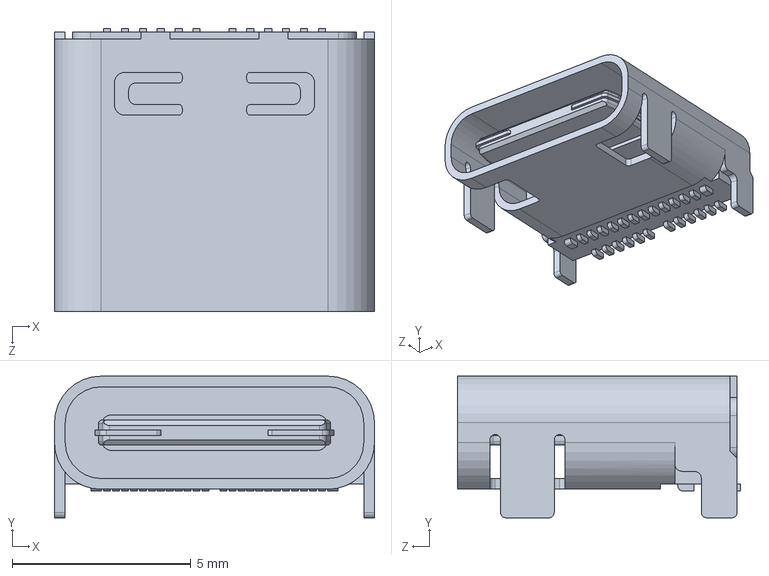
[picture p196: CAD file, 2020-12-13]
21-02-19-Kickoff/Studienarbeit/GehäuseCad/Standardteile/Raspi 4/raspberry-pi-4B/Female USB Type C Connector, RPi4ModelB.SLDPRT
8.94 x 3.96 x 7.90 mm
