plastikpamaro/bachelorprojekt2020/(list of files, cad)

Other CAD files:
21-02-19-Kickoff/Studienarbeit/GehäuseCad/Standardteile/Designer/1_STEP_MODELLE/mic_pcb_D8mm.step
21-02-19-Kickoff/Studienarbeit/GehäuseCad/Gehäuse/Bauteil1.ipt
21-02-19-Kickoff/Studienarbeit/GehäuseCad/Gehäuse/GehaeuseteilA.ipt
21-02-19-Kickoff/Studienarbeit/GehäuseCad/Gehäuse/GehaeuseteilB.ipt
21-02-19-Kickoff/Studienarbeit/GehäuseCad/Gehäuse/Gehäusezusammenbau.iam
21-02-19-Kickoff/Studienarbeit/GehäuseCad/Gehäuse/OldVersions/GehaeuseteilA.0012.ipt
21-02-19-Kickoff/Studienarbeit/GehäuseCad/Gehäuse/OldVersions/GehaeuseteilB.0003.ipt
21-02-19-Kickoff/Studienarbeit/GehäuseCad/Gehäuse/OldVersions/Gehäusezusammenbau.0033.iam
21-02-19-Kickoff/Studienarbeit/GehäuseCad/Standardteile/3Dfiles/783904624.newVer.iam
21-02-19-Kickoff/Studienarbeit/GehäuseCad/Standardteile/3Dfiles/783904760.newVer.iam
21-02-19-Kickoff/Studienarbeit/GehäuseCad/Standardteile/3Dfiles/783904896.newVer.iam
21-02-19-Kickoff/Studienarbeit/GehäuseCad/Standardteile/3Dfiles/Board.newVer.ipt
21-02-19-Kickoff/Studienarbeit/GehäuseCad/Standardteile/3Dfiles/C115.newVer.iam
21-02-19-Kickoff/Studienarbeit/GehäuseCad/Standardteile/3Dfiles/MSB_PCB_with_mic_pcb/783896056.iam
21-02-19-Kickoff/Studienarbeit/GehäuseCad/Standardteile/3Dfiles/MSB_PCB_with_mic_pcb/783904488.iam
21-02-19-Kickoff/Studienarbeit/GehäuseCad/Standardteile/3Dfiles/MSB_PCB_with_mic_pcb/783904624.iam
21-02-19-Kickoff/Studienarbeit/GehäuseCad/Standardteile/3Dfiles/MSB_PCB_with_mic_pcb/783904760.iam
21-02-19-Kickoff/Studienarbeit/GehäuseCad/Standardteile/3Dfiles/MSB_PCB_with_mic_pcb/783904896.iam
21-02-19-Kickoff/Studienarbeit/GehäuseCad/Standardteile/3Dfiles/MSB_PCB_with_mic_pcb/783904896.newVer.iam
21-02-19-Kickoff/Studienarbeit/GehäuseCad/Standardteile/3Dfiles/MSB_PCB_with_mic_pcb/783905032.iam
21-02-19-Kickoff/Studienarbeit/GehäuseCad/Standardteile/3Dfiles/MSB_PCB_with_mic_pcb/783905032.newVer.iam
21-02-19-Kickoff/Studienarbeit/GehäuseCad/Standardteile/3Dfiles/MSB_PCB_with_mic_pcb/783905168.iam
21-02-19-Kickoff/Studienarbeit/GehäuseCad/Standardteile/3Dfiles/MSB_PCB_with_mic_pcb/783905304.iam
21-02-19-Kickoff/Studienarbeit/GehäuseCad/Standardteile/3Dfiles/MSB_PCB_with_mic_pcb/Board.ipt
21-02-19-Kickoff/Studienarbeit/GehäuseCad/Standardteile/3Dfiles/MSB_PCB_with_mic_pcb/C100.iam
21-02-19-Kickoff/Studienarbeit/GehäuseCad/Standardteile/3Dfiles/MSB_PCB_with_mic_pcb/C101.iam
21-02-19-Kickoff/Studienarbeit/GehäuseCad/Standardteile/3Dfiles/MSB_PCB_with_mic_pcb/C102.iam
21-02-19-Kickoff/Studienarbeit/GehäuseCad/Standardteile/3Dfiles/MSB_PCB_with_mic_pcb/C103.iam
21-02-19-Kickoff/Studienarbeit/GehäuseCad/Standardteile/3Dfiles/MSB_PCB_with_mic_pcb/C104.iam
21-02-19-Kickoff/Studienarbeit/GehäuseCad/Standardteile/3Dfiles/MSB_PCB_with_mic_pcb/C105.iam
21-02-19-Kickoff/Studienarbeit/GehäuseCad/Standardteile/3Dfiles/MSB_PCB_with_mic_pcb/C105.newVer.iam
21-02-19-Kickoff/Studienarbeit/GehäuseCad/Standardteile/3Dfiles/MSB_PCB_with_mic_pcb/C106.iam
21-02-19-Kickoff/Studienarbeit/GehäuseCad/Standardteile/3Dfiles/MSB_PCB_with_mic_pcb/C107.iam
21-02-19-Kickoff/Studienarbeit/GehäuseCad/Standardteile/3Dfiles/MSB_PCB_with_mic_pcb/C108.iam
21-02-19-Kickoff/Studienarbeit/GehäuseCad/Standardteile/3Dfiles/MSB_PCB_with_mic_pcb/C108.newVer.iam
21-02-19-Kickoff/Studienarbeit/GehäuseCad/Standardteile/3Dfiles/MSB_PCB_with_mic_pcb/C109.iam
21-02-19-Kickoff/Studienarbeit/GehäuseCad/Standardteile/3Dfiles/MSB_PCB_with_mic_pcb/C110.iam
21-02-19-Kickoff/Studienarbeit/GehäuseCad/Standardteile/3Dfiles/MSB_PCB_with_mic_pcb/C111.iam
21-02-19-Kickoff/Studienarbeit/GehäuseCad/Standardteile/3Dfiles/MSB_PCB_with_mic_pcb/C112.iam
21-02-19-Kickoff/Studienarbeit/GehäuseCad/Standardteile/3Dfiles/MSB_PCB_with_mic_pcb/C112.newVer.iam
21-02-19-Kickoff/Studienarbeit/GehäuseCad/Standardteile/3Dfiles/MSB_PCB_with_mic_pcb/C113.iam
21-02-19-Kickoff/Studienarbeit/GehäuseCad/Standardteile/3Dfiles/MSB_PCB_with_mic_pcb/C114.iam
21-02-19-Kickoff/Studienarbeit/GehäuseCad/Standardteile/3Dfiles/MSB_PCB_with_mic_pcb/C115.iam
21-02-19-Kickoff/Studienarbeit/GehäuseCad/Standardteile/3Dfiles/MSB_PCB_with_mic_pcb/C116.iam
21-02-19-Kickoff/Studienarbeit/GehäuseCad/Standardteile/3Dfiles/MSB_PCB_with_mic_pcb/CAPC1005X55.ipt
21-02-19-Kickoff/Studienarbeit/GehäuseCad/Standardteile/3Dfiles/MSB_PCB_with_mic_pcb/Extruded.ipt
21-02-19-Kickoff/Studienarbeit/GehäuseCad/Standardteile/3Dfiles/MSB_PCB_with_mic_pcb/Extruded_1.ipt
21-02-19-Kickoff/Studienarbeit/GehäuseCad/Standardteile/3Dfiles/MSB_PCB_with_mic_pcb/Extruded_1.newVer.ipt
21-02-19-Kickoff/Studienarbeit/GehäuseCad/Standardteile/3Dfiles/MSB_PCB_with_mic_pcb/Extruded_2.ipt
21-02-19-Kickoff/Studienarbeit/GehäuseCad/Standardteile/3Dfiles/MSB_PCB_with_mic_pcb/Extruded_3.ipt
21-02-19-Kickoff/Studienarbeit/GehäuseCad/Standardteile/3Dfiles/MSB_PCB_with_mic_pcb/Extruded_4.ipt
21-02-19-Kickoff/Studienarbeit/GehäuseCad/Standardteile/3Dfiles/MSB_PCB_with_mic_pcb/Extruded_5.ipt
21-02-19-Kickoff/Studienarbeit/GehäuseCad/Standardteile/3Dfiles/MSB_PCB_with_mic_pcb/Extruded_6.ipt
21-02-19-Kickoff/Studienarbeit/GehäuseCad/Standardteile/3Dfiles/MSB_PCB_with_mic_pcb/Extruded_6.newVer.ipt
21-02-19-Kickoff/Studienarbeit/GehäuseCad/Standardteile/3Dfiles/MSB_PCB_with_mic_pcb/Extruded_7.ipt
21-02-19-Kickoff/Studienarbeit/GehäuseCad/Standardteile/3Dfiles/MSB_PCB_with_mic_pcb/LD100.iam
21-02-19-Kickoff/Studienarbeit/GehäuseCad/Standardteile/3Dfiles/MSB_PCB_with_mic_pcb/LD100.newVer.iam
21-02-19-Kickoff/Studienarbeit/GehäuseCad/Standardteile/3Dfiles/MSB_PCB_with_mic_pcb/LD101.iam
21-02-19-Kickoff/Studienarbeit/GehäuseCad/Standardteile/3Dfiles/MSB_PCB_with_mic_pcb/LEDC1608X80N_RED.ipt
21-02-19-Kickoff/Studienarbeit/GehäuseCad/Standardteile/3Dfiles/MSB_PCB_with_mic_pcb/MSB_PCB_with_mic_pcb.iam
21-02-19-Kickoff/Studienarbeit/GehäuseCad/Standardteile/3Dfiles/MSB_PCB_with_mic_pcb/PLL1_27-10.ipt
21-02-19-Kickoff/Studienarbeit/GehäuseCad/Standardteile/3Dfiles/MSB_PCB_with_mic_pcb/R100.iam
21-02-19-Kickoff/Studienarbeit/GehäuseCad/Standardteile/3Dfiles/MSB_PCB_with_mic_pcb/R101.iam
21-02-19-Kickoff/Studienarbeit/GehäuseCad/Standardteile/3Dfiles/MSB_PCB_with_mic_pcb/R102.iam
21-02-19-Kickoff/Studienarbeit/GehäuseCad/Standardteile/3Dfiles/MSB_PCB_with_mic_pcb/R103.iam
21-02-19-Kickoff/Studienarbeit/GehäuseCad/Standardteile/3Dfiles/MSB_PCB_with_mic_pcb/R104.iam
21-02-19-Kickoff/Studienarbeit/GehäuseCad/Standardteile/3Dfiles/MSB_PCB_with_mic_pcb/R104.newVer.iam
21-02-19-Kickoff/Studienarbeit/GehäuseCad/Standardteile/3Dfiles/MSB_PCB_with_mic_pcb/R105.iam
21-02-19-Kickoff/Studienarbeit/GehäuseCad/Standardteile/3Dfiles/MSB_PCB_with_mic_pcb/R105.newVer.iam
21-02-19-Kickoff/Studienarbeit/GehäuseCad/Standardteile/3Dfiles/MSB_PCB_with_mic_pcb/R106.iam
21-02-19-Kickoff/Studienarbeit/GehäuseCad/Standardteile/3Dfiles/MSB_PCB_with_mic_pcb/R107.iam
21-02-19-Kickoff/Studienarbeit/GehäuseCad/Standardteile/3Dfiles/MSB_PCB_with_mic_pcb/R107.newVer.iam
21-02-19-Kickoff/Studienarbeit/GehäuseCad/Standardteile/3Dfiles/MSB_PCB_with_mic_pcb/R108.iam
21-02-19-Kickoff/Studienarbeit/GehäuseCad/Standardteile/3Dfiles/MSB_PCB_with_mic_pcb/R109.iam
21-02-19-Kickoff/Studienarbeit/GehäuseCad/Standardteile/3Dfiles/MSB_PCB_with_mic_pcb/R109.newVer.iam
21-02-19-Kickoff/Studienarbeit/GehäuseCad/Standardteile/3Dfiles/MSB_PCB_with_mic_pcb/R110.iam
21-02-19-Kickoff/Studienarbeit/GehäuseCad/Standardteile/3Dfiles/MSB_PCB_with_mic_pcb/R111.iam
21-02-19-Kickoff/Studienarbeit/GehäuseCad/Standardteile/3Dfiles/MSB_PCB_with_mic_pcb/R112.iam
21-02-19-Kickoff/Studienarbeit/GehäuseCad/Standardteile/3Dfiles/MSB_PCB_with_mic_pcb/R113.iam
21-02-19-Kickoff/Studienarbeit/GehäuseCad/Standardteile/3Dfiles/MSB_PCB_with_mic_pcb/R113.newVer.iam
21-02-19-Kickoff/Studienarbeit/GehäuseCad/Standardteile/3Dfiles/MSB_PCB_with_mic_pcb/R114.iam
21-02-19-Kickoff/Studienarbeit/GehäuseCad/Standardteile/3Dfiles/MSB_PCB_with_mic_pcb/R114.newVer.iam
21-02-19-Kickoff/Studienarbeit/GehäuseCad/Standardteile/3Dfiles/MSB_PCB_with_mic_pcb/R115.iam
21-02-19-Kickoff/Studienarbeit/GehäuseCad/Standardteile/3Dfiles/MSB_PCB_with_mic_pcb/R116.iam
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
