plastikpamaro/bachelorprojekt2020/Dokumentation/Sections/Bedienungsanleitung/Bedienungsanleitung.tex

\section{Bedienungsanleitung}

Zunächst müssen sich der \glqq Raspberry Pi\grqq\ und das Zweitgerät in einem gemeinsamen Netzwerk befinden. Dies kann über den Access-Point, den der \glqq Raspberry Pi\grqq\ hostet stattfinden oder über beliebige umgebende Netzwerke auf das beide Geräte Zugriff haben. Der Name des AP lautet \glqq wifipi\grqq\ und es wird das Passwort \glqq RaspberryWiFi\grqq\ verwendet.

Befinden sich beide Geräte im Netzwerk, so kann eine SSH-Verbindung hergestellt werden. Besonders geeignet hierfür ist das Tool \glqq PuTTY\grqq, da es für eine Vielzahl von Betriebssystemen verfügbar ist. 

Alternativ dazu kann auch ein Remote Zugriff mit grafischem Desktop wie \glqq VNC Viewer\grqq\ verwendet werden. Dieser belastet allerding den Arbeitsspeicher des \glqq Raspberry Pi\grqq\  stark, sodass dieser nicht für den laufenden Betrieb des Systems empfohlen wird. 

Besteht eine gültige SSH-Verbindung, gibt es zwei Betriebsvarianten. 

Die Hauptfunktion unseres Systems wird mithilfe von 2 Programmen realisiert. Das eine Programm definiert die SPI-Schnittstelle und liest die Mikrofondaten ein. Diese werden dann über eine Pipeline an das Hauptprogramm gesendet. Für den Entwicklungsprozess wurde das Hauptprogramm über einen Remote Zugriff in der \glqq Netbeans IDE\grqq\ entwickelt. So können sämtliche Änderungen am Programm wie etwa die Kalibrierung der Geräuschempfindlichkeit direkt über das zusätzliche Endgerät stattfinden. Diese Empfindlichkeit muss je nach Umgebungslautstärke oder des zu messenden Geräusches eingestellt werden. Zu Testzwecken wurde das System so eingestellt, dass es in einem ruhigen Umfeld ein Klatschen erkennt. Für die Inbetriebnahme ist es zwingend notwendig, dass zuerst das Hauptprogramm in der IDE ausgeführt wird. Dieses benötigt dann mindestens vier Sekunden, um die Kamera und die Pipeline zu stabilisieren. Im Anschluss daran kann das Skript \glqq mic\_handler\_pipe64\grqq\ über die Kommandozeile gestartet werden. Die Auswertung der Mikrofondaten beginnt und eventuell auftretende Events werden erkannt und berechnet. Befindet sich das Hauptprogramm nicht im Modus \glqq Debug\grqq\ läuft diese Auswertung endlos, bis das Programm händisch terminiert wird. Der Prozess wird korrekt beendet, wenn zuerst das Hauptprogramm in der IDE und anschließend das Skript beendet werden.

In der anderen Variante können alle für die Funktion notwendigen Programme mit dem Skript \glqq script.sh\grqq\ gleichzeitig gestartet werden. Das Skript muss sich jedoch im gleichen Verzeichnis wie die von der IDE ausführbar kompilierte Version des Hauptprogrammes und das Skript zum Starten der Pipeline befinden. Alle drei Skripte befinden sich im /home- Verzeichnis des \glqq Raspberry Pi\grqq\  und könnten z.B. mit dem Befehl \glqq bash script.sh\grqq\ ausgeführt werden. Je nach Konfiguration des Hauptprogramms läuft der Prozess endlos. In diesem Fall können aber alle Unterprogramme mit einem \glqq stg+C\grqq\ Kommando gleichzeitig beendet werden. Wurden in der IDE Änderungen am Hauptprogramm durchgeführt, so muss die aktualisierte Version des kompilierten Hauptprogramms händisch in das korrekte Verzeichnis kopiert werden. 

Für einen einfacheren Zugriff auf den Dateiexplorer um z.B. die kompilierten Programme verschieben zu können, empfiehlt sich die Verwendung von \glqq WinSCP\grqq. Hier kann direkt über SSH auf die Ordnerstruktur des \glqq Raspberry Pi\grqq\ zugegriffen werden. So lassen sich Kopier- und Bearbeitungsvorgänge, sowie die Sicherung und Sichtung der bearbeiteten Beweisbilder direkt über das verwendete, zweite Endgerät durchführen.

\newpage
