plastikpamaro/bachelorprojekt2020/21-02-19-Kickoff/Studienarbeit/Quellen/Schallortung mit ATMEGA/ORTUNGANLEITUNG.pdf

# PASSIVE SCHALLORTUNG

# - für AT mega 8 (ATMEL)

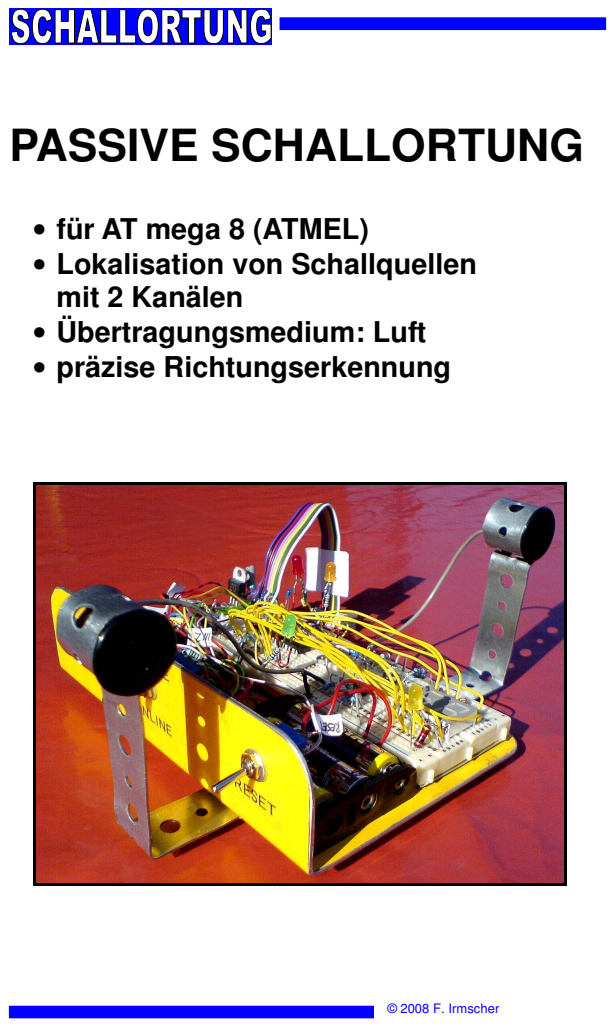
[picture p201: page 1]
© 2008 F. Irmscher

• Lokalisation von Schallquellen
mit 2 Kanälen
• Übertragungsmedium: Luft
• präzise Richtungserkennung

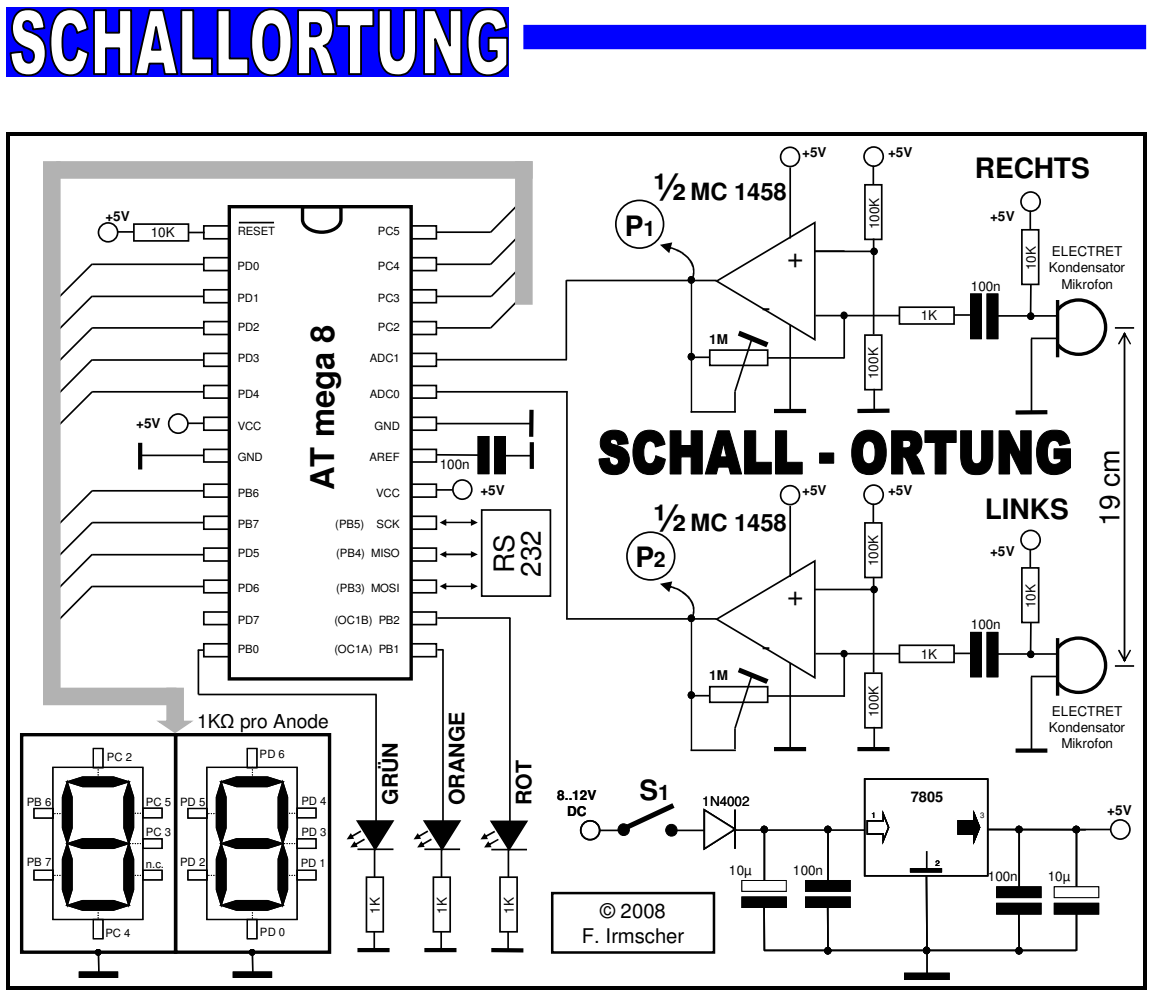
[picture p202: figure]
AT mega 8; VCC; GND; RESET; ADC1; ADC0; AREF; (PB5) SCK; (PB4) MISO; (PB3) MOSI; © 2008 F. Irmscher; ELECTRET Kondensator Mikrofon; LINKS; ELECTRET Kondensator; Mikrofon; RECHTS; GRÜN; ORANGE; ROT; ½MC 1458; 1KΩ pro Anode

2

Einleitung | Ganz genau müsste die Überschrift wahrscheinlich Richtungslokalisation lauten, da sich der Begriff Or- tung auf die Auswertung der Reflektion von zuvor aus- gesendeten Signalen bezieht, wie etwa bei Radar und Echolot. Die zurückgeworfenen Signale werden dann als sog. Sekundärschall bezeichnet. Der populärere Begriff Passive Schallortung ist dem einen oder anderen viel- leicht aus der U-Boot-Technik des Zweiten Weltkriegs geläufig. Hier wurde der direkt von der Schallquelle auf kürzestem Wege zu den Mikrofonen gelangte Schall (sog. Primärschall) auf seine Richtung hin analysiert. Reichhaltige Informationen zu dem Themenkomplex Schall finden sich z.B. bei Wikipedia. Mit dem vorliegenden Projekt wir eine recht einfache aber erstaunlich gut funktionierende Methode beschrie- ben, die Richtung der momentan lautesten Schallquelle mithilfe zweier Electret-Kondensator-Mikrofone (ECM) zu lokalisieren. Übertragungsmedium ist Luft. Vielleicht könnte dieses, wie später beschrieben noch ausbaufähi- ge Projekt, als Ausgangspunkt für eigene Versuche die- nen. Auf die Funktionstüchtigkeit eines Nachbaus wird keine Gewährleistung gegeben!

© 2008 F.Irmscher | 3

# Funktionsweise

Elektronik | Als Mikrocontroller kommt der AT mega 8 (ATMEL) zum Einsatz. Er hat ein für diese Anwendung ausreichend gro- ßes RAM. Programmiert wir z.B. mit dem Adapter: my Smart USB V.2.11. Der Systemtakt wird über das Fuse-Low-Byte auf 2 MHz eingestellt. Ein Quarz ist nicht notwendig. Die Messwerte können mithilfe des Moduls aus dem Lernpaket Mikrocontroller (Franzis) an den PC gesen- det und mit dem Terminal von Lpmikros.exe dargestellt werden. Die Programmierung ist mit dem Modul aber leider nicht möglich. Zusätzlich erfolgt die Datenausgabe über eine zweistellige 7-Segment-Anzeige mit gemeinsamer Kathode. Jeder A- node wird ein 1KΩ-Widerstand vorgeschaltet (Im Schalt- plan nicht eingezeichnet!). Mit dieser Anzeige kann man das Gerät auch ohne die störenden Lüftergeräusche des PC verwenden. Es werden zwei handelsübliche, aber unbedingt bauglei- che ECM’s benötigt. Sie müssen in einem Abstand von genau 19 cm zueinander montiert werden. Die Mikrofonlei- tungen müssen abgeschirmt sein. Die Verstärkung erfolgt auf einfache Weise mir einem Zweifach-Operationsverstärker (OPV). Getestet wurden die Typen MC1458 und LM358. Die Verstärkung ist für Experimente in weiten Grenzen bis zu 1000-fach einstell- bar. Es ist wichtig, die Verstärkung bei beiden OPV’s stets gleich hoch einzustellen. Der Abgleich kann dafür an den Messpunkten P1 und P2 erfolgen. Wer hierzu kein Oszil- loskop besitzt, kann sich eines für die PC-Soundkarte als Freeware aus dem Internet herunterladen. Verzerrungen und gelegentliche Übersteuerungen, die bei einer solch einfachen Verstärkerschaltung eher auftreten, können to- leriert werden, da sie die Ortung nicht maßgeblich stören. Als Trimmer sollten sog. Präzisions-Einstellregler (CON- RAD) bzw. Miniatur-Regler Ø 6,6mm (REICHELT) ver- wendet werden, da sie aufgrund der geringen Größe nahe am OPV platziert werden können und so weniger empfind- lich gegen Störeinflüsse sind (Abb. 1).

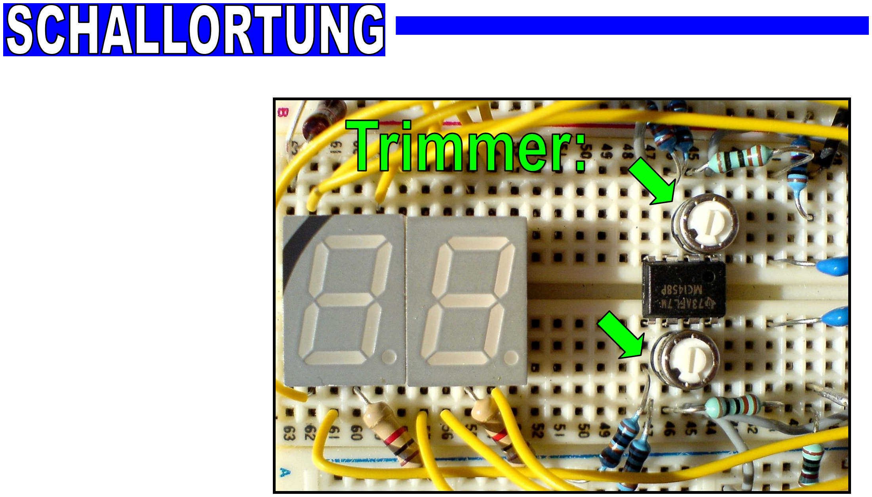
[picture p203: figure]

4

Abb. 1: Trimmer und 7-Segment-Anzeige

Natürlich wären auch hochwertigere Vorverstärker einsetzbar. Die Schallortung funktioniert aber auch schon so. Zur Spannungsstabilisierung auf 5V wird ein Festspannungsregler verwendet.

Laufzeitdifferenz Während das menschliche Gehör Schalllokalisation mit einer Vielzahl von Mechanismen durchführt, beschränkt sich dieses Projekt nur auf das wohl Wichtigste, die Messung
von sog. Laufzeitdifferenzen:
Befinden sich zwei Mikrofone und eine Schallquelle an unterschiedlichen Stellen im Raum, so trifft ein sich kreisförmig von dieser Quelle ausbreitendes Schallereignis aufgrund der Schallgeschwindigkeit zeitlich versetzt bei beiden Mikrofonen ein. Dieser Zeitunterschied wird Laufzeitdifferenz genannt und ist, bezogen auf die beiden Mikrofone, ein Maß für die Richtung zur Schallquelle.
Sind die Mikrofone von der Quelle gleichweit entfernt, kommt der Schall also genau von vorne oder hinten, so tritt keine Differenz auf (Abb. 2).
Je „seitlicher“ der Schall auf die beiden Mikrofone trifft, desto größer ist die Laufzeitdifferenz (Abb. 3).
Die größte Differenz wird erreicht, wenn sich Schallquelle und beide Mikrofone auf einer gedachten Linie befinden (Abb. 4).

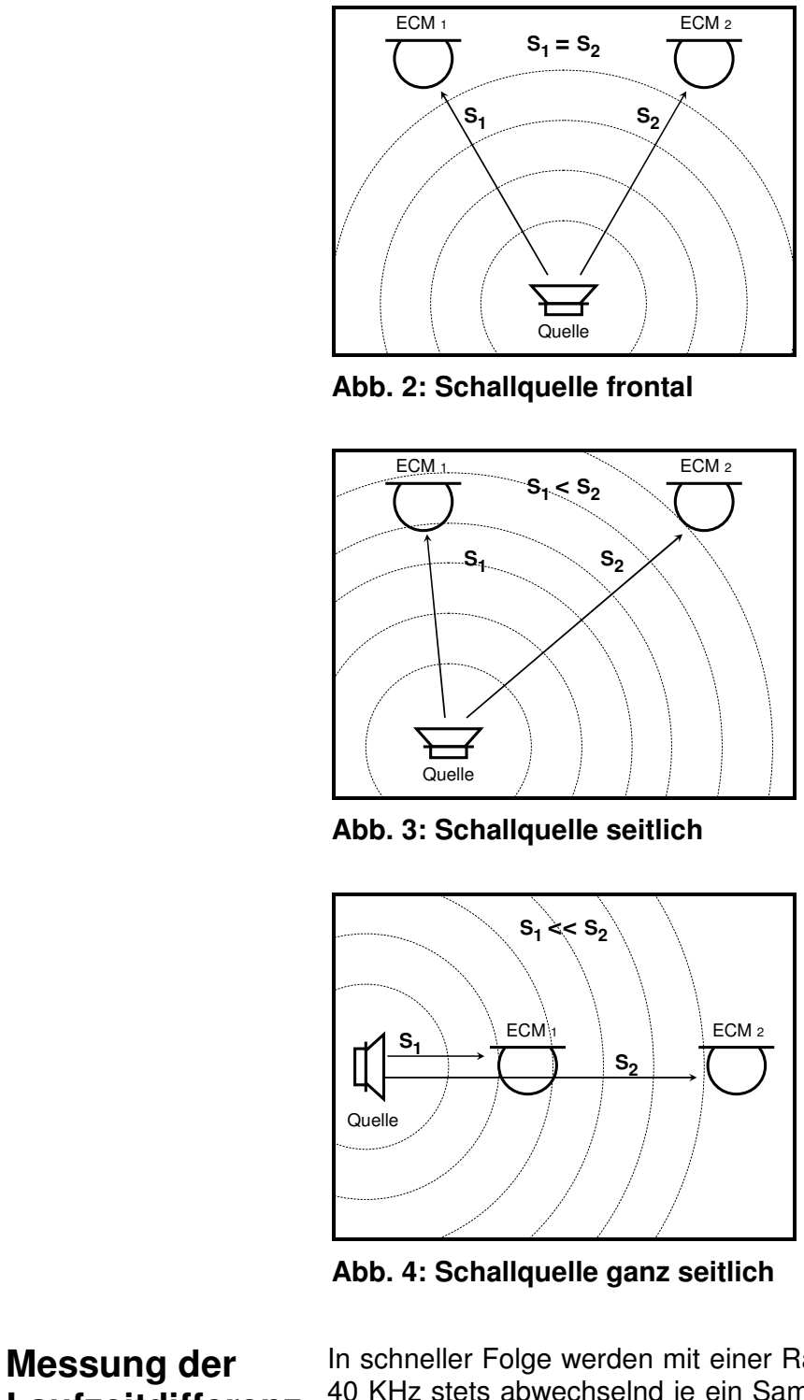
[picture p204: figure]
ECM 1; ECM 2; Quelle; Abb. 2: Schallquelle frontal; Abb. 3: Schallquelle seitlich; Abb. 4: Schallquelle ganz seitlich; Messung der

© 2008 F.Irmscher | 5

## Laufzeitdifferenz

In schneller Folge werden mit einer Rate von insgesamt ca.

### 40 KHz stets abwechselnd je ein Sample zuerst für den lin-

ken Kanal (ADC 0) und dann für den rechten Kanal (ADC 1) als 8-bit-ADC-Wert im RAM gespeichert. Pro Seite sind dies 250 Samples. Die dabei für den einzelnen Kanal zur Verfügung stehende Samplerate von ca. 20 KHz gestattet nach dem sog. Abtasttheorem (Shannon) eine obere Grenzfrequenz von ca. 10 KHz.
In Abb. 5 werden die zuvor im RAM gespeicherten Werte

6

einer 2-Kanal-Aufnahme mit EXCEL dargestellt. Aufgenommen wurde ein NF-Signal von 10 KHz. Zu erkennen ist, dass jedes Sample gerade eben noch einen Welleberg bzw.

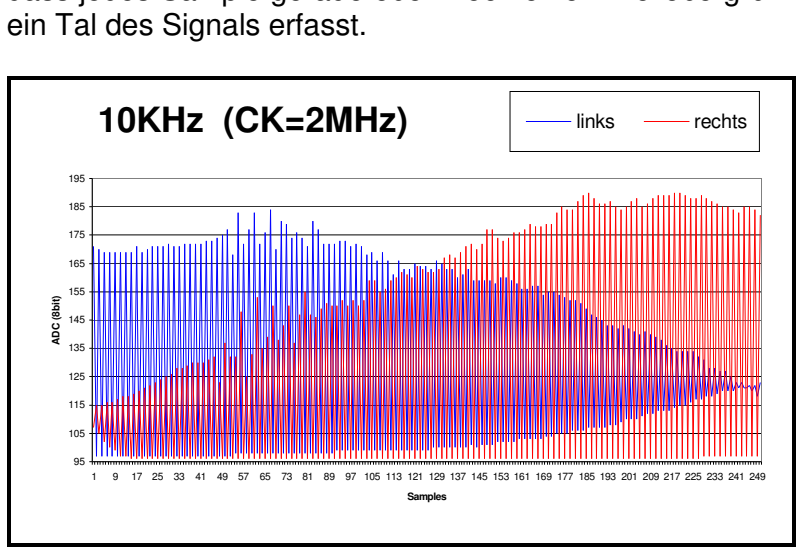
[picture p205: figure]
ein Tal des Signals erfasst.; 10KHz (CK=2MHz); Samples; ADC (8bit); links; rechts

1 9 17 25 33 41 49 57 65 73 81 89 97 105 113 121 129 137 145 153 161 169 177 185 193 201 209 217 225 233 241 249

Abb. 5: Sinussignal (10KHz)

Um nun die aktuelle Laufzeitdifferenz eines Schallereignisses zu bestimmen, müssen die beiden Aufzeichnungen für den rechten und linken Kanal in Schritten von einem Sample gegeneinander verschoben werden, bis sie möglichst gut übereinstimmen (Abb. 6). Dies wird berechnet, indem für jede Verschiebung die Summe aller 239 Differenzen der sich entsprechenden Samples von links und rechts gebildet wird. Die kleinste Summe steht dabei für die beste Überein-

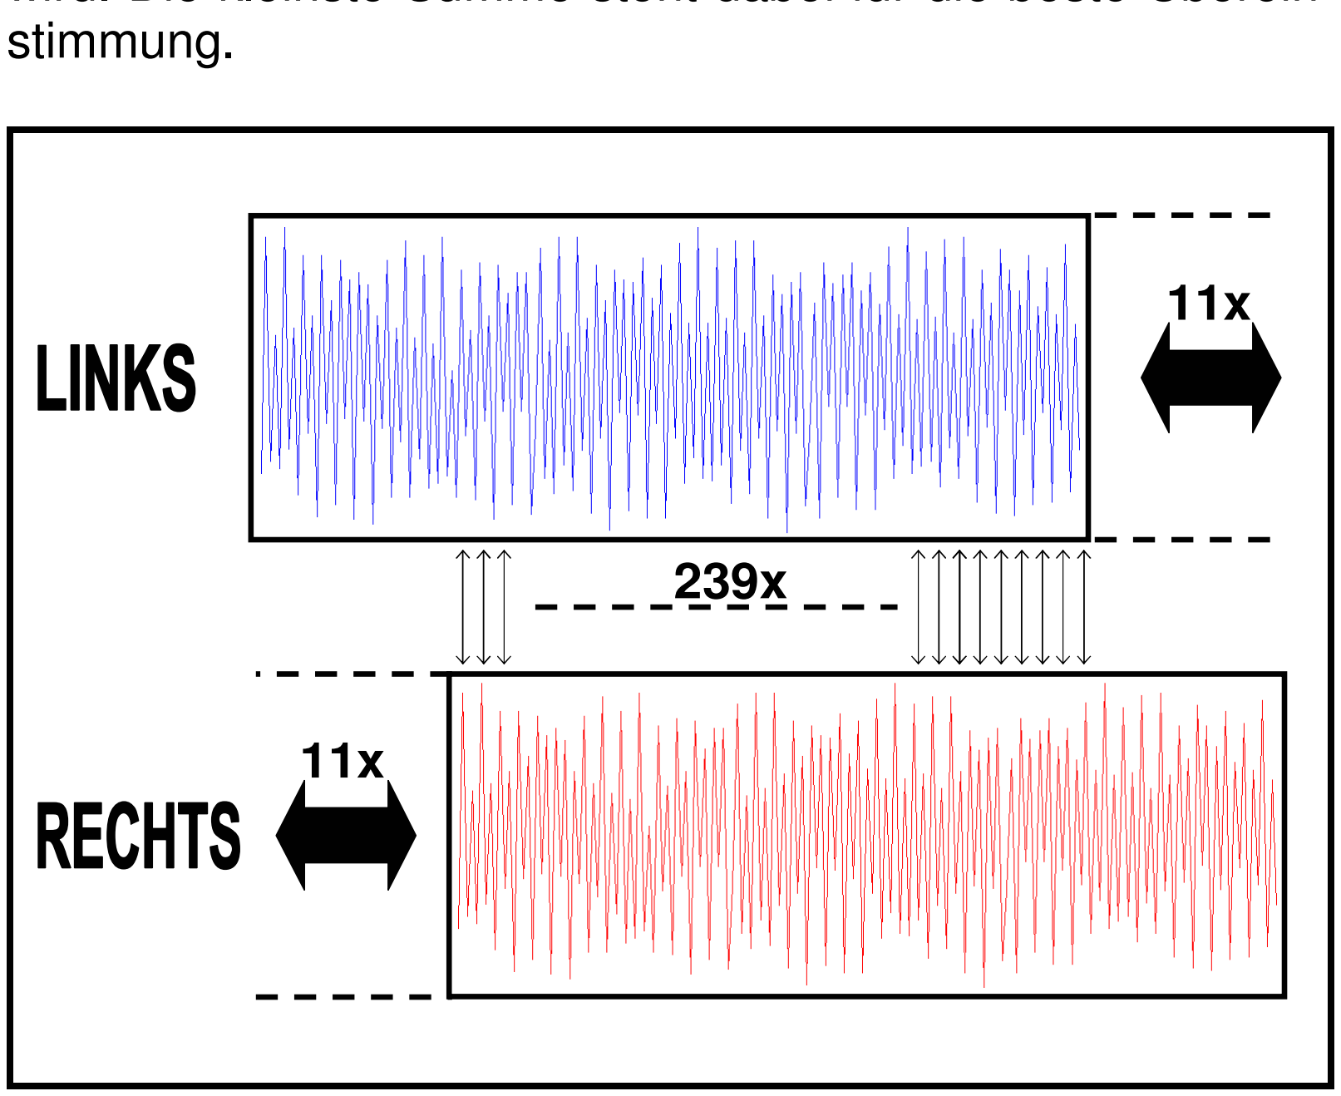
[picture p206: figure]
stimmung.

Abb. 6: Bestimmung der Laufzeitdifferenz

© 2008 F.Irmscher | 7
Berechnungen | Wieviele Verschiebungen durchgeführt werden müssen, ist
neben der Samplerate abhängig vom Abstand der Mikrofone zueinander. Für die Schallgeschwindigkeit gilt allgemein:

### 1) c Schall = λ × f = 1 [m /s]

für: λ .. W ellenlänge
f .. F requenz

Für die temperaturabhängige Schallgeschwindigkeit in Luft gilt näherungsweise:

### 2) c L uft ≈ (331,5 + 0,6 /°C)

m it: = -20 °C .. +40 °C

Bei Raumtemperatur ist somit:

3) c L uft, 20°C ≈ 343 m /s

Nach folgender Rechnung wurde ein „handlicher“ Mikrofonabstand von 19 cm gewählt:

Benötigte Aufnahmezeit für 11 Samples bei 20 KHz:

4) | t 11 = 11 × | = 11 × | = 550µ s

Vom Schall bei Raumtemperatur zurückgelegte Strecke bei

### 11 Samples pro Kanal:

5) s (20°) = c L uft, 20° × t 11

### = 343 m /s × 550µ s

| ≈ 19 cm
| [ s (0°) = 18,2 cm ; | s(40°) = 19,6 cm ]

Es müssen also bei einem Abstand von 19 cm und einer Rate von 20 KHz pro Kanal jeweils 11 Verschiebungen durchgeführt werden. Zusammen mit der Mittelposition sind somit 23 Stellungen miteinander zu vergleichen.
Die Anzahl für die bestmögliche Übereinstimmung (geringste Differenz) entspricht gem. Abb. 7 dem Winkel der Schallrichtung.

1
f

1
20K H z

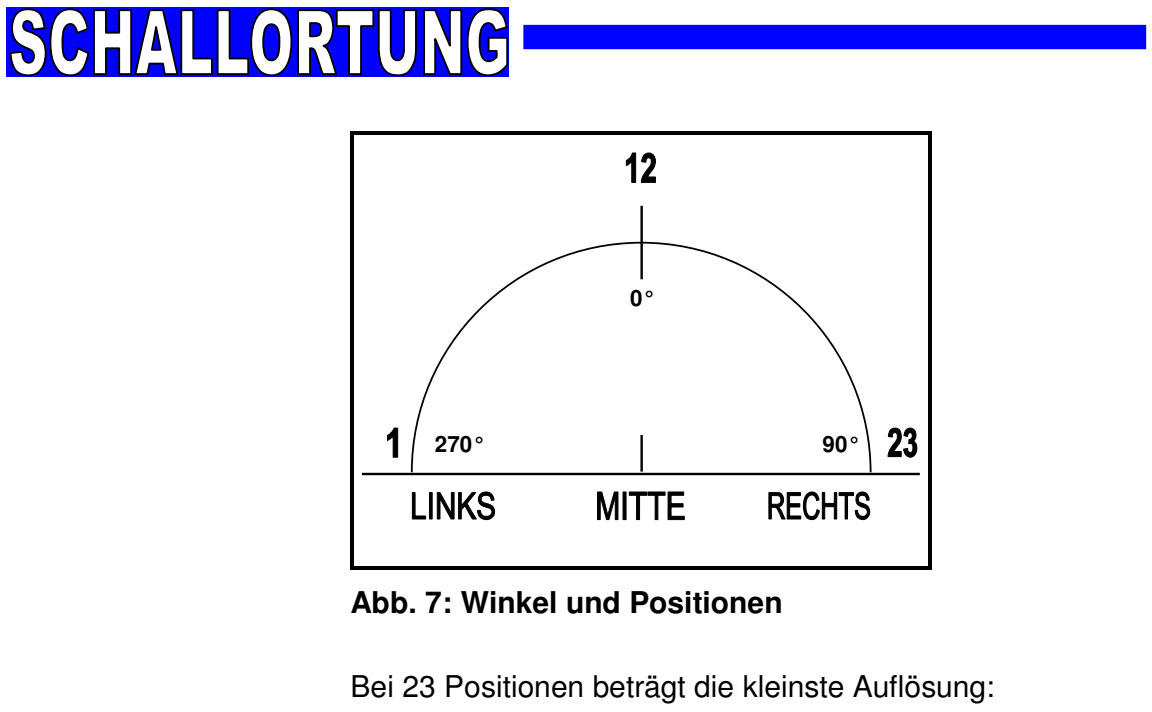
[picture p207: figure]
Abb. 7: Winkel und Positionen

8

Bei 23 Positionen beträgt die kleinste Auflösung:

6) 180° ÷ 23 = 7,8°

Dies dürfte für die meisten Anwendungen genügen. Wer’s genauer will, müsste den Mikrofonabstand und damit die Zahl der verschiebbaren Samples erhöhen.

Da die Bestimmung der Laufzeit auf der Messung von differierenden Pegeln beruht, werden insbesondere die Signalanteile mit der höchsten Lautstärke detektiert. Dabei dürfte es sich va. um den richtungweisenden Primärschall handeln, da der Schalldruckpegel des Sekundärschalls durch Absorption und Reflexion meist abnimmt.
Bei jeder der 23 Stellungen werden 239 Differenzen gebildet. Diese hohe Anzahl wirkt zudem als Filter gegen Störungen.

# Programmbeschreibung

Voreinstellungen Das Fuse-Low-Byte muss gem. der Tabelle im Programmcode auf 2 MHz eingestellt werden (0xE2).

Im folgenden werden die einzelnen Programmsegmente dargestellt.

Zunächst erfolgen die üblichen Konstanten- und Variablendefinitionen.
Es werden keine Interrupts benötigt.

© 2008 F.Irmscher | 9
Hauptprogramm | ab: STILLE EINMALIG KALIBRIEREN: Nur bei der allerersten Messwertaufnahme nach dem Einschalten ist die Variable Stille = 0. In diesem Fall wird zunächst bei WARTEN_STILLE: einen Moment gewar- tet, bis das Einschaltgeräusch verhallt ist und dann nach Messwertaufnahme der höchste aller Werte in Stille ge- speichert. Während der Kalibration sollte der Geräusch- pegel niedrig und die zu lokalisierenden Signale nicht zu hören sein! Die Konstante Pegeldiff wird zu Stille hinzu- addiert.
| ab: TEST_MIN_PEGEL: Bei jeder weiteren Messwertaufnahme wird geprüft, ob mindestens ein Wert größer als Stille ist. Nur dann er- folgt die weitere Signalverarbeitung. Je niedriger also Pegeldiff ist, desto empfindlicher wird die Schallortung.
| ab: LOOP_LINKS: Laufzeitberechnungen für die unteren 11 Positionen. Hierfür werden die Werte des linken Kanals mithilfe von Routine Y_POSITION 11x um je ein Sample verschoben und in jeder Stellung die Summe aller Differenzen der sich entsprechenden Samples gebildet. Die kleinste Dif- ferenz wird in Diff_Min (16bit) gespeichert. Zugleich wird die zugehörige Position in Diff_Step gesichert.
| ab: LOOP_RECHTS: Laufzeitberechnungen für die oberen 11 Positionen und die Mittelstellung. Hierfür werden die Werte des rechten Kanals mit der Routine Z_POSITION 11x um je ein Sample verschoben. Die weiteren Berechnungen erfol- gen analog zu LOOP_LINKS.
| ab: EXIT_LAUFZEIT: Hier enden die Laufzeitberechnungen. Falls zweimal hintereinander dieselbe Position errechnet wurde, wird sie nun mithilfe der Routine LED_DISLPLAY auf der 7- Segment-Anzeige ausgegeben und außerdem mit der Routine WrCOM_2 an den PC gesendet. Wird einige Sekunden lang keine Schallrichtung mehr erkannt, so wird die Anzeige gelöscht. Dieses Zeitinter- vall wird mit der Variable Dauer und der Konstante Durchlauf bestimmt.
WrCOM_2: | Für einen Prozessortakt von 2 MHz modifizierte Version aus dem Lernpaket Mikrocontroller (FRANZIS). Ausgabe erfolgt mit dem Terminal von Lpmikros.exe.

10

ADC_START: | Initialisierung des ADC-Wandlers: Die Ergebnisse sind
| left-adjusted (8bit). Wegen der geringen Auflösung kann
| der ADC-Takt auf 1 MHz erhöht werden.
ADC_Rd_LEFT: | ADC-Wandlung für den linken Kanal

ADC_Rd_RIGHT: ADC-Wandlung für den rechten Kanal

WARTEN: | Allgemeine Warteschleife. Die Dauer wird mit der Vari-
| ablen i gesteuert.
Y_POSITION: | Errechnung der Startposition im RAM für die Verschie-
| bung der Werte des linken Kanals mithilfe von Variable
| Step.
Z_POSITION: | Errechnung der Startposition im RAM für die Verschie-
| bung der Werte des rechten Kanals mithilfe von Variable
| Step.
LED_DISPLAY: | Wertausgabe von i durch die zweistellige 7-Segment-
| Anzeige.
| Die Anzeige ist dunkel bei i = 0.
| Ausgabe von „Er“ (Error) für i ≥ 30.

# Mögliche Verbesserungen

| Die Schaltung könnte wie folgt optimiert werden:

### Analoge Elektronik

| Signale oberhalb von 10 KHz werden lt. dem og. Abtast-
| theorem fälschlicherweise als niedrigere Frequenzen
| detektiert. Da dieser Fehler an beiden Kanälen auftrifft,
| scheint er sich weitgehend selbst zu eliminieren. Einen
| Versuch mit einem Tiefpass wär’s aber wohl wert.
| Wenn das zu lokalisierende Signal bekannt ist (z.B. Mo-
| torengeräusch, Sprache), könnte man mit einem Band-
| pass den wichtigsten Frequenzbereich herausfiltern und
| damit die Empfindlichkeit der Ortung erhöhen.
| Vielleicht liefert auch eine hochwertigere Mikrofonvor-
| verstärkung bessere Ergebnisse.

### Autokalibration für Ruherauschen

| Anstelle der einfachen Kalibration direkt nach dem Ein-
| schalten wäre es denkbar, für einige Minuten den nie-
| drigsten Schallpegel zu suchen und diesen dann als Re-
| ferenzwert zu verwenden.

### Bessere Signalauswertung

| Momentan erfolgt die Anzeige einer neuen Richtung
| immer nur dann, wenn zweimal hintereinander der glei-

© 2008 F.Irmscher | 11

che Wert gemessen wird. Erkannt werden müssten außerdem Messungen, die zwischen zwei Zahlen „hin- und herpendeln“ (z.B. zwischen 14 und 15).
Zusätzliche Genauigkeit könnte eine „statistische Auswertung“ ermöglichen, bei der gleiche oder ähnliche Richtungswerte innerhalb eines bestimmten Zeitraumes auf ihre Häufigkeit hin überprüft werden.
Würde das Ortungssystem z.B. zur Zielverfolgung genutzt, könnte auch eine „Plausibilitätsprüfung“ stattfinden: Passt der aktuelle Winkel zu den Vorwerten entsprechend der bisherigen Bewegung des Zieles und der eigenen Bewegung … ?
Richtmikrofone | Sollen weiter entfernte Signale lokalisiert werden, könn- ten die Mikrofone zu Richtmikrofonen umgestaltet wer- den. Entsprechende Konstruktionen dürften dabei das Klangbild durch Resonanzen nicht verfälschen!
Drittes Mikrofon | Mit zwei Mikrofonen ist die Schallortung nur in einem Radius von 180 Grad möglich, d.h. es wird nicht erkannt, ob das Signal von vorne oder hinten kommt. Für den vollen Radius von 360 Grad wäre ein drittes Mikrofon nötig. Sollte bei den drei Mikrofonaufnahmen die Grenzfrequenz von 10 KHz nicht unterschritten wer- den, müsste die Samplerate weiter erhöht werden, da in der gleichen Zeit jetzt drei anstatt zuvor zwei Kanäle aufgezeichnet werden würden. Dies könnte beim AT mega 8 zu Geschwindigkeitspro- blemen führen.

# Kontakt

| Haben Sie ein ähnliches Projekt entwickelt, Verbesse- rungsvorschläge oder Anregungen? Dann freue ich mich über eine Mail an:

### mw_grabowski@gmx.de
