plastikpamaro/bachelorprojekt2020/21-02-19-Kickoff/Studienarbeit/GehäuseCad/Standardteile/Designer/3_PDF_3D/Aufbau_3D.pdf

DIE INFORMATIONEN UND/ODER DAS MATERIAL IN DIESEM DOKUMENT SIND EIGENTUM VON BZW. VERTRAULICHE INFORMATIONEN UND/ODER VERTRAULICHES MATERIAL DES AUTORS. DIESE INFORMATIONEN DÜRFEN NICHT OHNE SCHRIFTLICHE GENEHMIGUNG VERWENDET, VERVIELFÄLTIGT, VERÖFFENTLICHT ODER OFFENGELEGT WERDEN. SIE SIND NUR FÜR IN DIESEM DOKUMENT ANGEGEBENE FERTIGUNGSOBJEKTE ZU VERWENDEN.

TITEL BAUTEILNR. | Aufbau REVISION KONSTRUKTEURwork1 INGENIEUR ANMERKUNGEN | v1.0
