plastikpamaro/bachelorprojekt2020/Pics/20-12-13 Testaufbau/Raspberry.jpg

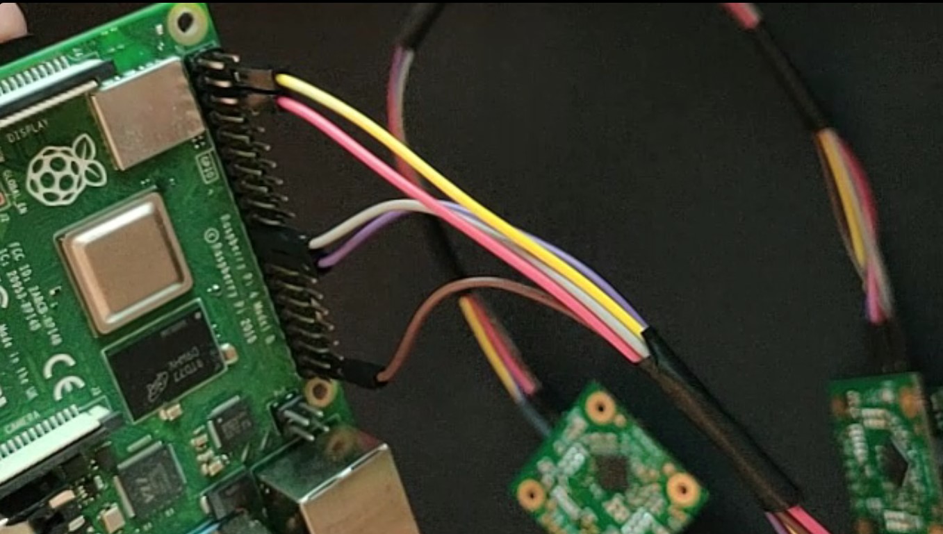
Pics/20-12-13 Testaufbau/Raspberry.jpg
