plastikpamaro/bachelorprojekt2020/Dokumentation/Sections/Tests/Tests.tex

\section{Tests}

Das kontinuierliche Testen und Bewerten aller Einzelkomponenten und Funktionen des Systems ist ein elementarer Entwicklungsbestandteil und teilt den Entwicklungsprozess in unterschiedliche Abschnitte.

Leider hat die aktuell herrschende Covid-19 Pandemie die Erstellung und Durchführung aussagekräftiger Tests erschwert. 

\subsection{Mikrofontest}

Noch vor der eigentlichen Entwicklungsarbeit wurden die zur Verfügung gestellten Einzelkomponenten auf ihre Funktion überprüft. Hierzu wurde der Raspberry Pi mit einem Betriebssystem versehen (Raspberry OS 10) und mit der notwendigen c-Bibliothek versehen (BCM 2835 V1.68). Über einfache Jumperkabel wurde jeweils ein zu testendes Mikrofon und ein Abschlussmikrofon an den Raspberry angeschlossen und ein Test durchgeführt. (\autoref{fig:BlockbildMikroTest}).

\begin{figure}[!h]
	\begin{center}
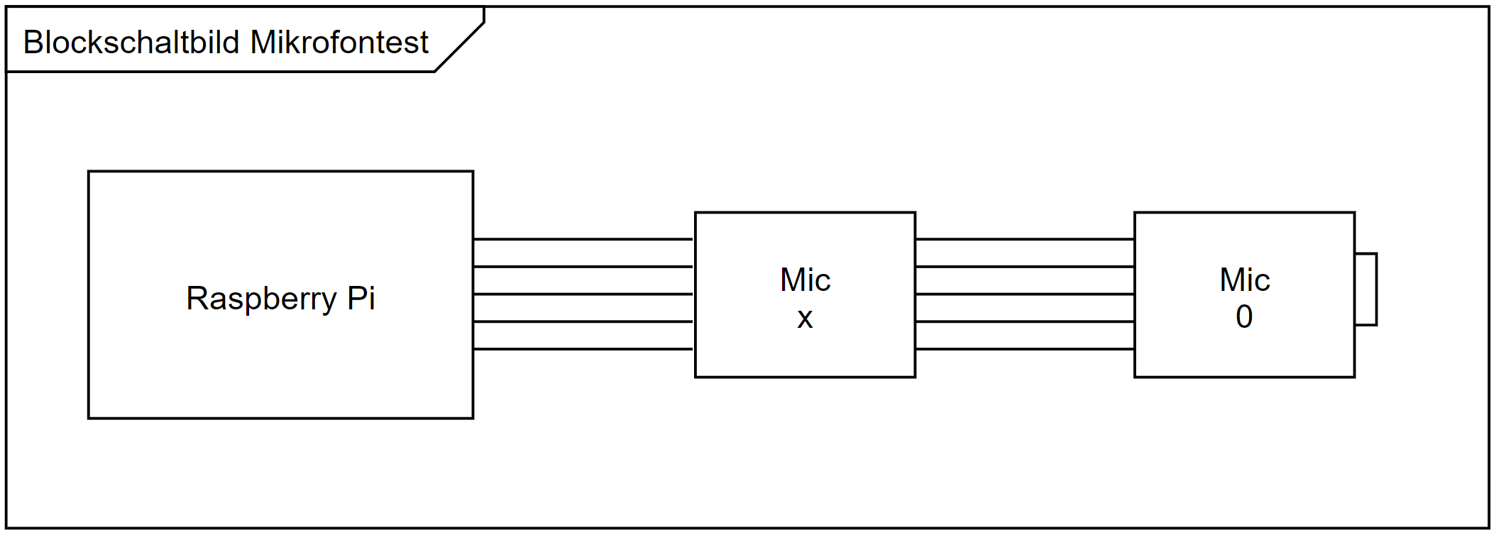
[picture p211: Dokumentation/Sections/Tests/BlockbildMikroTest.png]
		
	\end{center}
	\caption{Blockbild Mikro Test}
	\label{fig:BlockbildMikroTest}
\end{figure}

Mit dem Skript \glqq RecordMicToRAM\grqq\ wurden die Daten des Mikrofonpaares eingelesen und auf ihre Vollständigkeit überprüft. Es wird eine .txt-Datei erzeugt, in dieser sind 7 Spalten. Für das entsprechende Mikrofon tauchen bei erfolgreichem Durchlauf Messwerte auf. So konnte die korrekte Funktion der einzelnen Mikrofone garantiert werden.

\begin{tabularx}{\columnwidth}{|p{4cm}|X|}
	\hline
	\textbf{Abschnitt} & \textbf{Inhalt}\\
	\hline
	\textbf{Name} & Mikrofonfunktionstest\\
	\hline
	\textbf{Autor(en)} & Philipp Otto\\
	\hline
	\textbf{Priorität} & hoch\\	
	\hline	
	\textbf{Kritikalität} & hoch\\
	\hline
	%	\textbf{Quelle} & \\
	%	\hline
	\textbf{Verantwortlicher} & Philipp Otto\\
	\hline
	\textbf{Kurzbeschreibung} & Mit diesem Test soll die fehlerfreie Funktion der Mikrofone getestet werden\\
	\hline
	\textbf{Auslösendes Ereignis} & Eingabe Konsole: \glqq sudo ./RecordMicToRAM\grqq\\
	\hline
	\textbf{Akteure} & Mirkofonpaar, Raspberry Pi, Jumperkabel\\
	\hline
	\textbf{Vorbedingung} & Raspberry eingerichtet, Mikrofone und Raspberry mit Kabel verbunden, Raspberry eingeschaltet\\
	\hline
	\textbf{Nachbedingung} & \glqq RecordMicToRAM\grqq\ beendet,
	Prüfung der .txt-Datei ist erfolgt
	\\
	\hline
	\textbf{Ergebnis} & .txt- Datei erstellt\\
	\hline
	\textbf{Hauptszenario} & \begin{description}[font=\normalfont]
		\item[1.] Über die Konsoleneingabe wird das Programm gestartet
		\item[2.] Das Programm zeichnet ca. 8 Sekunden lang den Mikrofonausgang auf
		\item[3.] Das Programm erstellt eine .txt-Datei mit allen Messwerten
		\item[4.] Die .txt-Datei wird auf Vollständigkeit überprüft
	\end{description}\\
	\hline
	\textbf{Alternativszenario} & \begin{description}[font=\normalfont]
		\item[4.b] Die .txt-Datei enthält keine Messwerte
		\item[4.c] Kabelverbindung wird überprüft
	\end{description}\\
	%	\hline
	%	\textbf{Ausnahmeszenario} & \\
	%	\hline
	%	\textbf{Qualitäten} & \\
	\hline
\end{tabularx}
\captionof{table}{Mikrofonfunktionstest}
\label{tab:Mikrofonfunktionstest}

\subsection{Kabelfunktionstest 1}

In einem ersten Entwicklungsschritt wurde das gesamte Mikrofonarray mit großzügig dimensionierten Verbindungskabeln (Kabellänge ca. 50 cm) aufgebaut und in Abständen von ungefähr \SI{20}{cm} zueinander platziert. 

\begin{figure}[!h]
	\begin{center}
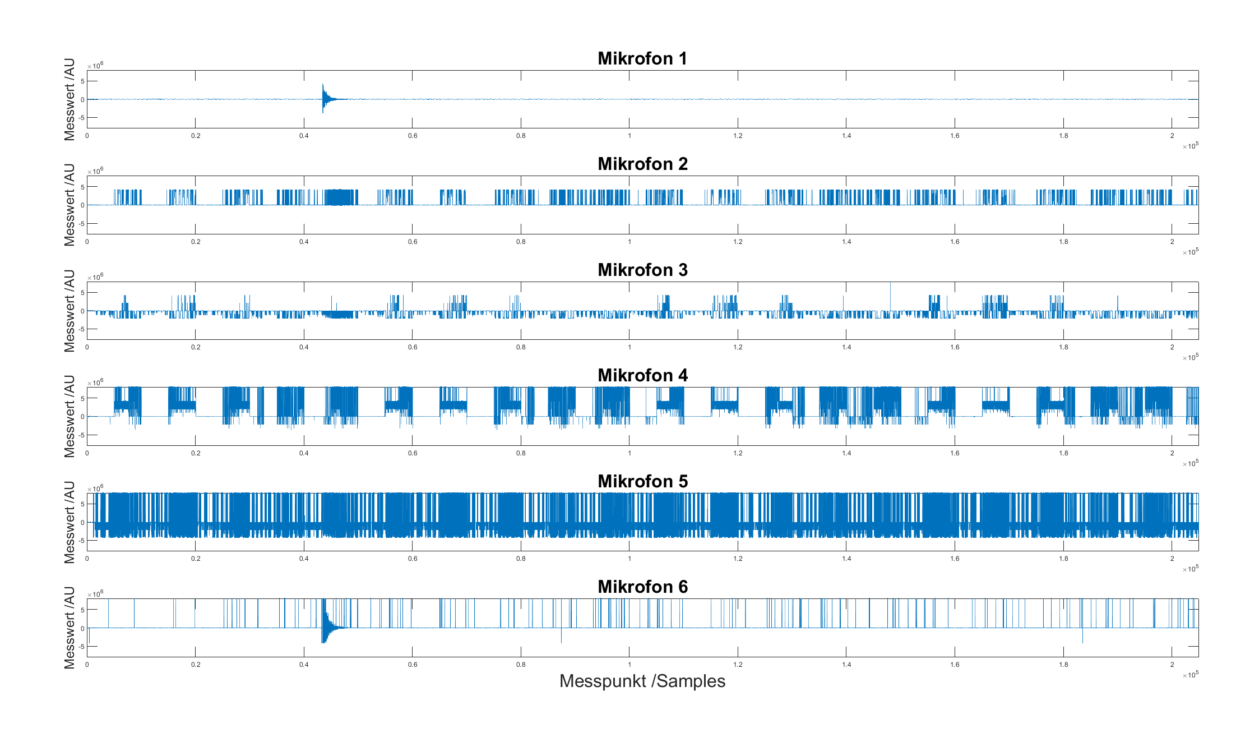
[picture p212: Dokumentation/Sections/Programmierung/Test_1_d.png]
		
	\end{center}
	\caption{Kabelfunktionstest 1}
	\label{fig:Test_1_d}
\end{figure}

Die dargestellte Messung wurde über einen Zeitraum von acht Sekunden durchgeführt mit einem Händeklatschen nach ungefähr zwei Sekunden.

Die Erwartungshaltung an die Ergebnisse ist ein sauberer Ausschlag der Messwerte bei ungefähr einem Viertel der vergangenen Testzeit mit einem anschließenden Abklingen auf den Umgebungspegel.

Lediglich die Aufzeichnungen aus Mikrofon 1 entsprechen den Erwartungen (Ausschlag bei ca. 40.000 Samples), während die restlichen Mikrofone deutliches Rauschen aufweisen. In der Aufzeichnung von Mikrofon 3 ist selbst das Event (erwartet bei ca. 40.000 Samples) nicht zu erkennen, während auf den anderen Kanälen noch Andeutungen eines stärker verrauschten Bereiches zu erkennen ist. Dieses Verhalten hätte seine Ursache beim Raspberry Pi haben können. Dieser muss für die Taktung der Mikrofone einen SPI-Takt über das gesamte Array treiben können. Mit zunehmender Kabellänge nimmt die Taktsicherheit ab. 

Durch ein Fachgespräch mit Max Weltz werden folgende mögliche Ursachen in den Fokus gerückt:

\begin{itemize}
	\item Kabel defekt
	\item SPI-Takt zu hoch
	\item Kabel zu lang
\end{itemize}

Um eine qualitative Ursachensuche vornehmen zu können, werden die aufgezählten Ursachen separat untersucht.

\begin{tabularx}{\columnwidth}{|p{4cm}|X|}
	\hline
	\textbf{Abschnitt} & \textbf{Inhalt}\\
	\hline
	\textbf{Name} & Kabelfunktionstest Nr. 1\\
	\hline
	\textbf{Autor(en)} & Philipp Otto\\
	\hline
	\textbf{Priorität} & hoch\\	
	\hline	
	\textbf{Kritikalität} & hoch\\
	\hline
	%	\textbf{Quelle} & \\
	%	\hline
	\textbf{Verantwortlicher} & Philipp Otto\\
	\hline
	\textbf{Kurzbeschreibung} & Mit diesem Test soll die fehlerfreie Funktion der Kabel getestet werden\\
	\hline
	\textbf{Auslösendes Ereignis} & Eingabe Konsole: \glqq sudo ./RecordMicToRAM\grqq\\
	\hline
	\textbf{Akteure} & gesamtes Mikrofonarray, Raspberry Pi, Kabel (lang)\\
	\hline
	\textbf{Vorbedingung} & Das Array ist vollständig mit Kabeln und Raspberry verbunden, Raspberry eingeschaltet\\
	\hline
	\textbf{Nachbedingung} & Messwerte grafisch auf Plausibilität überprüft
	\\
	\hline
	\textbf{Ergebnis} & Plot der Messwerte\\
	\hline
	\textbf{Hauptszenario} & \begin{description}[font=\normalfont]
		\item[1.] Über die Konsoleneingabe wird das Programm gestartet
		\item[2.] Das Programm zeichnet ca. 8 Sekunden lang den Mikrofonausgang auf
		\item[3.] Das Programm erstellt eine .txt-Datei mit allen Messwerten
		\item[4.] Die .txt-Datei wird mit python-script in korrektes Datenformat gebracht und in .csv konvertiert
		\item[5.] .csv wird mit Matlab eingelesen und geplottet
		\item[6.] Plot wird auf Plausibilität überprüft
	\end{description}\\
	\hline
	\textbf{Alternativszenario} & \begin{description}[font=\normalfont]
		\item[4.b] Die .txt-Datei enthält keine Messwerte
		\item[4.c] Kabelverbindung wird überprüft
		\item[6.b] Plot weist fehlerhafte Messwerte auf
	\end{description}\\
	%\hline
	%	\textbf{Ausnahmeszenario} & \\
	%	\hline
	%	\textbf{Qualitäten} & \\
	\hline
\end{tabularx}
\captionof{table}{ Kabelfunktionstest Nr. 1}
\label{tab: Kabelfunktionstest Nr. 1}

\subsection{Kabelfunktionstest 2}

Da für den Mikrofontest keine eigenen Kabel verwendet werden, ist es noch notwendig die selbst hergestellten Kabel auf fehlerfreie Funktion zu testen. Dafür werden diese mit einem Mulitmeter erst auf Durchgang und im zweiten Schritt auf Kurzschlüsse zwischen den Einzeladern getestet. In beiden Fällen ist bei der Produktion der Kabel kein Fehler aufgetreten, daher können diese als voll funktionsfähig angesehen werden.

\subsection{Kabelfunktionstest 3}

In einer zweiten Iteration soll das System so angepasst werden, dass der SPI-Takt von den ursprünglichen \SI{7,8}{MHz} auf \SI{3,9}{MHz} reduziert wird. 

\begin{figure}[!h]
	\begin{center}
		
	\end{center}
	\caption{Kabelfunktionstest 3}
	\label{fig:Test_2_d}
\end{figure}

Für diese Anpassung wird die gleiche Testmethode verwendet. Wie vermutet ist die Messung nun deutlich weniger verrauscht. Dennoch sind immer wieder bit-shift Fehler zu erkennen, die das Messergebnis zu bestimmten Schwellenwerten springen lässt. Die Messungen sind somit immer noch zu stark verrauscht und für eine Verwendung unbrauchbar. 

Eine reine Reduzierung des  SPI-Takts hat das Problem nicht vollständig lösen können.

\begin{tabularx}{\columnwidth}{|p{4cm}|X|}
	\hline
	\textbf{Abschnitt} & \textbf{Inhalt}\\
	\hline
	\textbf{Name} & Kabelfunktionstest Nr. 3\\
	\hline
	\textbf{Autor(en)} & Philipp Otto\\
	\hline
	\textbf{Priorität} & hoch\\	
	\hline	
	\textbf{Kritikalität} & hoch\\
	\hline
	%	\textbf{Quelle} & \\
	%	\hline
	\textbf{Verantwortlicher} & Philipp Otto\\
	\hline
	\textbf{Kurzbeschreibung} &Mit diesem Test soll die fehlerfreie Funktion der Kabel bei halbiertem SPI-Takt getestet werden\\
	\hline
	\textbf{Auslösendes Ereignis} & Eingabe Konsole: \glqq sudo ./RecordMicToRAM64\grqq\\
	\hline
	\textbf{Akteure} & gesamtes Mikrofonarray, Raspberry Pi, Kabel (lang)\\
	\hline
	\textbf{Vorbedingung} & Das Array ist vollständig mit Kabeln und Raspberry verbunden, Raspberry eingeschaltet\\
	\hline
	\textbf{Nachbedingung} & Messwerte grafisch auf Plausibilität überprüft
	\\
	\hline
	\textbf{Ergebnis} & Plot der Messwerte\\
	\hline
	\textbf{Hauptszenario} & \begin{description}[font=\normalfont]
		\item[1.] Über die Konsoleneingabe wird das Programm gestartet
		\item[2.] Das Programm zeichnet ca. 8 Sekunden lang den Mikrofonausgang auf
		\item[3.] Das Programm erstellt eine .txt-Datei mit allen Messwerten
		\item[4.] Die .txt-Datei wird mit python-script in korrektes Datenformat gebracht und in .csv konvertiert
		\item[5.] .csv wird mit Matlab eingelesen und geplottet
		\item[6.] Plot wird auf Plausibilität überprüft
	\end{description}\\
	\hline
	\textbf{Alternativszenario} & \begin{description}[font=\normalfont]
		\item[4.b] Die .txt-Datei enthält keine Messwerte
		\item[4.c] Kabelverbindung wird überprüft
		\item[6.b] Plot weist fehlerhafte Messwerte auf
	\end{description}\\
	%\hline
	%	\textbf{Ausnahmeszenario} & \\
	%	\hline
	%	\textbf{Qualitäten} & \\
	\hline
\end{tabularx}
\captionof{table}{ Kabelfunktionstest Nr. 3}
\label{tab: Kabelfunktionstest Nr. 3}

\newpage

\subsection{Kabelfunktionstest 4}

In der nächsten Anpassung werden die Kabel der Mikrofonkabel auf ca. \SI{25}{cm} reduziert mit der Erwartung, dass die Taktsicherheit über die gesamte Kabellänge steigen sollte.

\begin{figure}[!h]
	\begin{center}
		
	\end{center}
	\caption{Kabelfunktionstest 4}
	\label{fig:Test_3_d}
\end{figure}

Die durchgeführte Messung weißt das gewünschte, rauschfreie Verhalten der Messwerte auf allen Kanälen auf. Die Kabel sind somit, in Bezug auf die Datenübertragung, hinreichend auf die Funktion überprüft. 

\newpage

\begin{tabularx}{\columnwidth}{|p{4cm}|X|}
	\hline
	\textbf{Abschnitt} & \textbf{Inhalt}\\
	\hline
	\textbf{Name} & Kabelfunktionstest Nr. 4\\
	\hline
	\textbf{Autor(en)} & Philipp Otto\\
	\hline
	\textbf{Priorität} & hoch\\	
	\hline	
	\textbf{Kritikalität} & hoch\\
	\hline
	%	\textbf{Quelle} & \\
	%	\hline
	\textbf{Verantwortlicher} & Philipp Otto\\
	\hline
	\textbf{Kurzbeschreibung} & Mit diesem Test soll die fehlerfreie Funktion der Kabel bei halbiertem SPI-Takt und kürzeren Kabeln getestet werden\\
	\hline
	\textbf{Auslösendes Ereignis} & Eingabe Konsole: \glqq sudo ./RecordMicToRAM64\grqq\\
	\hline
	\textbf{Akteure} & gesamtes Mikrofonarray, Raspberry Pi, Kabel (kurz)\\
	\hline
	\textbf{Vorbedingung} & Das Array ist vollständig mit Kabeln und Raspberry verbunden, Raspberry eingeschaltet\\
	\hline
	\textbf{Nachbedingung} & Messwerte grafisch auf Plausibilität überprüft
	\\
	\hline
	\textbf{Ergebnis} & Plot der Messwerte\\
	\hline
	\textbf{Hauptszenario} & \begin{description}[font=\normalfont]
		\item[1.] Über die Konsoleneingabe wird das Programm gestartet
		\item[2.] Das Programm zeichnet ca. 8 Sekunden lang den Mikrofonausgang auf
		\item[3.] Das Programm erstellt eine .txt-Datei mit allen Messwerten
		\item[4.] Die .txt-Datei wird mit python-script in korrektes Datenformat gebracht und in .csv konvertiert
		\item[5.] .csv wird mit Matlab eingelesen und geplottet
		\item[6.] Plot wird auf Plausibilität überprüft
	\end{description}\\
	\hline
	\textbf{Alternativszenario} & \begin{description}[font=\normalfont]
		\item[4.b] Die .txt-Datei enthält keine Messwerte
		\item[4.c] Kabelverbindung wird überprüft
		\item[6.b] Plot weist fehlerhafte Messwerte auf
	\end{description}\\
	%\hline
	%	\textbf{Ausnahmeszenario} & \\
	%	\hline
	%	\textbf{Qualitäten} & \\
	\hline
\end{tabularx}
\captionof{table}{ Kabelfunktionstest Nr. 4}
\label{tab: Kabelfunktionstest Nr. 4}

\subsection{Algorithmustest}

Im nächsten Testschritt wird das Gesamtsystem in einer den Anforderungen entsprechenden Umgebungssituation getestet. Das bedeutet das System wird auf einem Stativ in fast vollständig aufgebautem Zustand im Freien, in einer echoreduzierten Umgebung betrieben.

\begin{figure}[!h]
	\begin{center}
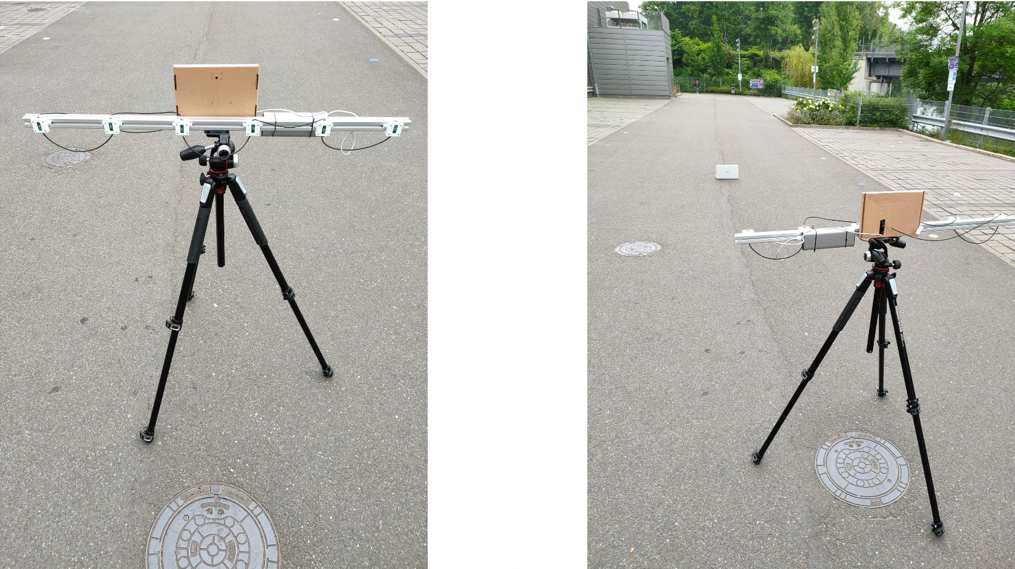
[picture p213: Dokumentation/Sections/Tests/Gesamtaufbau.jpg]
		
	\end{center}
	\caption{provisorischer Gesamtaufbau}
	\label{fig:Test_4}
\end{figure}

Zunächst wird erneut eine Messung über eine Dauer von acht Sekunden durchgeführt und wieder nach ungefähr zwei Sekunden ein Händeklatschen in einer Distanz von ca. \SI{15}{m} aufgezeichnet.

Die Aufgezeichneten Werte  der Messungen, also 205000 Messwerte pro Mikrofon, werden im Anschluss in Matlab mit dem gleichen Algorithmus ausgewertet, der auch Systemintern verwendet wird. Die Lokalisierung ergab \autoref{fig:Test_6_b}.

\begin{figure}[!h]
	\begin{center}
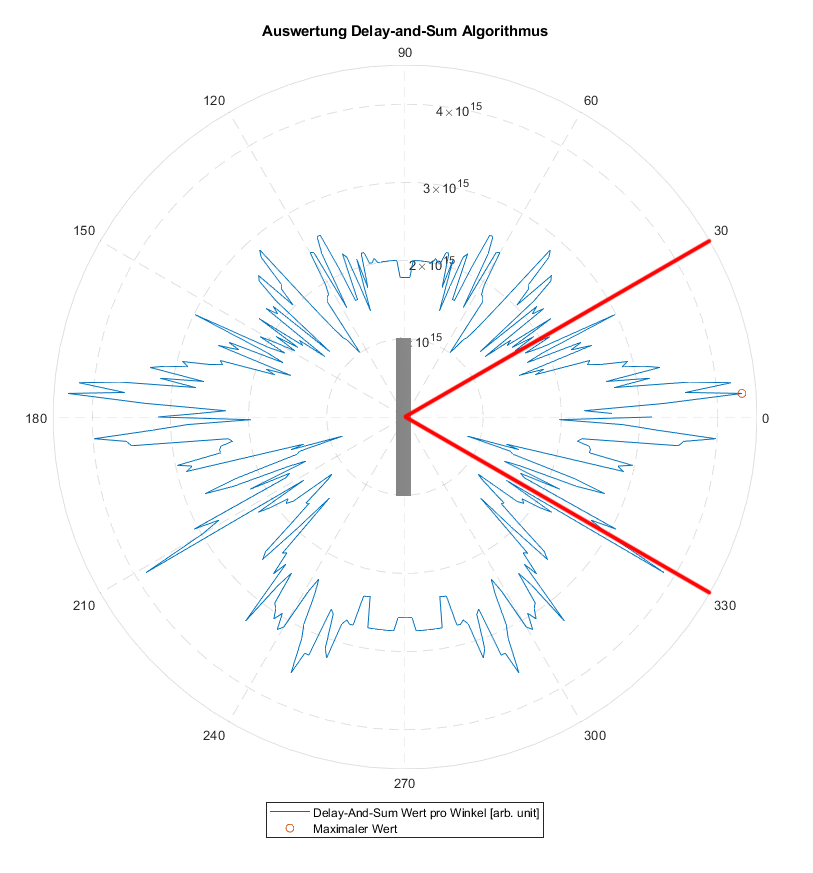
[picture p214: Dokumentation/Sections/Tests/Test_6_b.png]
		
	\end{center}
	\caption{Auswertung Delay-and-Sum Algorithmus}
	\label{fig:Test_6_b}
\end{figure}

Wie zu erwarten ist das Bild der Lokalisierung Achsensymmetrisch entlang der vertikalen, da unser definiertes Koordinatensystem entsprechend rotiert ist. Betrachtet wird in der Auswertung nur der Bereich von \ang{0} - \ang{30} und \ang{330} - \ang{360}, da dieser Winkelbereich ebenfalls von der Systemkamera abgedeckt wird. Ein Ergebnis der Lokalisierung nahe \ang{0} legt also ein Eventursprung frontal des Systems und somit mittig im Bild nahe. Das Ergebnis der Berechnung stimmte ebenfalls mit den Erwartungen überein, da das Geräusch ebenfalls ungefähr frontal vor dem System erzeugt wird.

\begin{tabularx}{\columnwidth}{|p{4cm}|X|}
	\hline
	\textbf{Abschnitt} & \textbf{Inhalt}\\
	\hline
	\textbf{Name} & Algorithmus-Test (Matlab)\\
	\hline
	\textbf{Autor(en)} & Philipp Otto\\
	\hline
	\textbf{Priorität} & hoch\\	
	\hline	
	\textbf{Kritikalität} & hoch\\
	\hline
	%	\textbf{Quelle} & \\
	%	\hline
	\textbf{Verantwortlicher} & Philipp Otto\\
	\hline
	\textbf{Kurzbeschreibung} & Mit diesem Test soll die fehlerfreie Funktion des Lokalisierungs-algorithmus getestet werden\\
	\hline
	\textbf{Auslösendes Ereignis} & \glqq sudo ./RecordMicToRAM64\grqq\\
	\hline
	\textbf{Akteure} & gesamtes Mirkofonarray, Rasberry Pi, Kabel(kurz)\\
	\hline
	\textbf{Vorbedingung} & Das System ist vollständig montiert, 
	Raspberry eingeschaltet\\
	\hline
	\textbf{Nachbedingung} & Lokalisierungsergebnisse grafisch auf Plausibilität überprüft.\\
	\hline
	\textbf{Ergebnis} & Plot der Lokalisierungsergebnisse\\
	\hline
	\textbf{Hauptszenario} & \begin{description}[font=\normalfont]
		\item[1.] Über die Konsoleneingabe wird das Programm gestartet
		\item[2.] Das Programm zeichnet ca. 8 Sekunden lang den Mikrofonausgang auf
		\item[3.] Das Programm erstellt eine .txt-Datei mit allen Messwerten
		\item[4.] Die .txt-Datei wird mit python Skript in korrektes Datenformat gebracht und in .csv konvertiert
		\item[5.] .csv wird in Matlab eingelesen
		\item[6.] Lokalisierung wird mithilfe des Skripts \glqq testDelayAndSum.m\grqq\ berechnet und geplottet
		\item[7.] Plot wird auf Plausibilität überprüft
	\end{description}\\
	\hline
	\textbf{Alternativszenario} & \begin{description}[font=\normalfont]
		\item[7.b] Lokalisierung entspricht nicht dem erwarteten Winkelbereich
		\item[6.c] Lokalisierung ist uneindeutig
		\item[8.] Messung wird in anderem Umfeld wiederholt
	\end{description}\\
	\hline
	%	\textbf{Ausnahmeszenario} & \\
	%	\hline
	%	\textbf{Qualitäten} & \\
	%	\hline
\end{tabularx}
\captionof{table}{Algorithmus-Test (Matlab)}
\label{tab:Algorithmus_Test_Matlab}

\subsection{Gesamt-Funktionstest}

Im nächsten Test wird das System wie bereits im Kapitel \glqq Bedienung\grqq\ beschrieben betrieben. 

Auch hier wird das System wieder in einer anforderungsähnlichen Umgebungssituation aufgebaut.

\begin{figure}[!h]
	\begin{center}
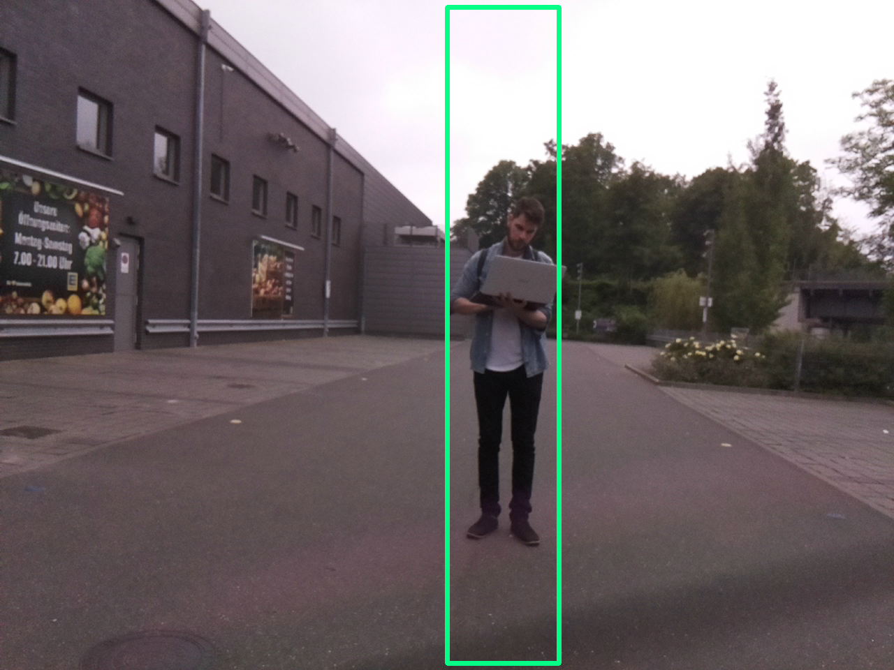
[picture p215: Dokumentation/Sections/Tests/Test_7.png]
		
	\end{center}
	\caption{erfolgreicher Gesamt-Funktionstest}
	\label{fig:Test_7}
\end{figure}

In diesem Test wird der eigentliche Dauerbetrieb des Systems getestet. Das bedeutet, dass das System endlos läuft (bis es durch den Nutzer abgebrochen wird), während das Programm fortlaufende Messdaten auswertet. 

Erwartet wird, dass der Nutzer eine Benachrichtigung, über ein erkanntes Event, mit dem dazugehörigen Lokalisierungsergebnis, über die Systemkonsole, mit einer zugehörigen .png-Datei, auf der das erkannte Segment, welches farblich markiert wird, erhält.

Der Versuch zeigt, dass das System den erhöhten Pegel eines auftretenden Events sehr gut erkennt. Zwar kommt es immer wieder zu variierenden Verzögerungen in der Anzeige auf der Konsole, aber dennoch werden aufeinanderfolgende Events korrekt hintereinander aufgelistet. Der hierzu verwendete Schwellenwert, ab dem das System auslösen soll, muss zunächst auf die neue Umgebungssituation und auf die Lautstärke des Events angepasst werden. 

Wie im obigen Bild aufgezeigt, kann der Ursprungsort des Events korrekt lokalisiert werden. 

Bei wiederholter Testdurchführung kommt es allerdings auch immer wieder zu Messungen, die nicht den Erwartungen entsprechen.

\begin{figure}[!h]
	\begin{center}
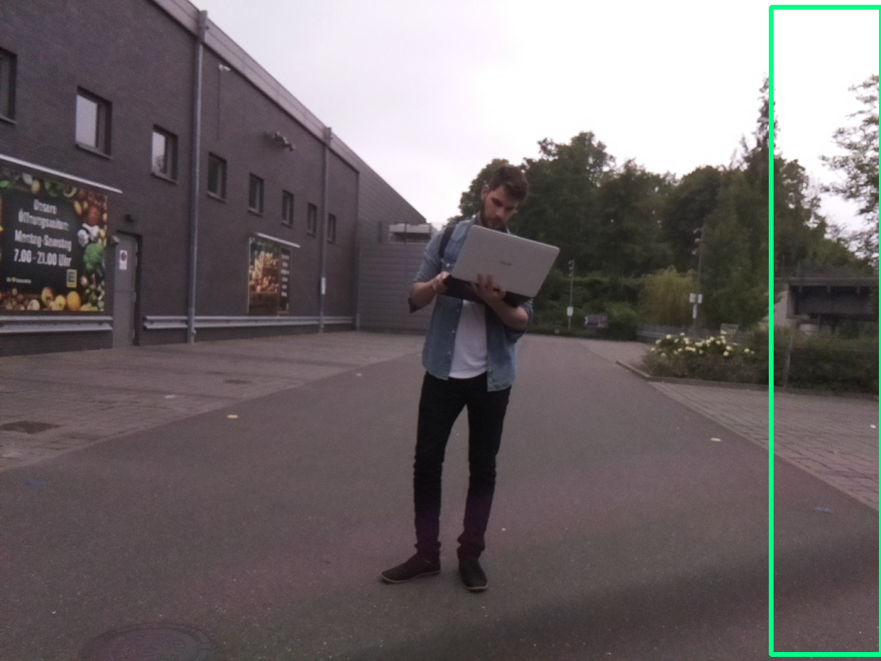
[picture p216: Dokumentation/Sections/Tests/Test_8.png]
		
	\end{center}
	\caption{unerfolgreicher Gesamt-Funktionstest}
	\label{fig:Test_8}
\end{figure}

Obwohl sich der Ursprungsort des Events ungefähr in der Bildmitte befindet, wird der rechte Bildrand als Ursprung lokalisiert. 

Durch die Fehllokalisierung tritt darüber hinaus auch der Fall auf, dass das Event zwar korrekt erkannt wird, aber aufgrund des fehlerhaft berechneten Ursprungswinkel wird das Event als außerhalb des Bildbereiches bewertet und keine Beweisführung durchgeführt. 

Diese Fehlmessung ist wahrscheinlich auf die Tatsache rückzuführen, dass der \glqq Raspberry Pi\grqq\ im laufenden Betrieb des Systems nur eine sehr begrenze Menge an Daten in seinem RAM abspeichern kann. Dies hat zur Folge, dass die Lokalisierung mit einer deutlich reduzierten Menge an Messwerten durchgeführt wird. 

Leider war es nicht möglich ein Testverfahren zu entwickeln, mit welchem sich die Genauigkeit der Lokalisierung qualitativ bewerten lässt, um so ein Minimum an benötigten Messdaten zu ermitteln. Die verwendete Buffergröße wird lediglich durch die Testergebnisse bestimmt.

\begin{tabularx}{\columnwidth}{|p{4cm}|X|}
	\hline
	\textbf{Abschnitt} & \textbf{Inhalt}\\
	\hline
	\textbf{Name} & Gesamt-Funktionstest\\
	\hline
	\textbf{Autor(en)} & Philipp Otto\\
	\hline
	\textbf{Priorität} & hoch\\	
	\hline	
	\textbf{Kritikalität} & hoch\\
	\hline
	%	\textbf{Quelle} & \\
	%	\hline
	\textbf{Verantwortlicher} & Philipp Otto\\
	\hline
	\textbf{Kurzbeschreibung} & Mit diesem Test soll die fehlerfreie Funktion des gesamten Programms getestet werden\\
	\hline
	\textbf{Auslösendes Ereignis} & Eingabe Konsole: \glqq sudo ./mic\_handler\_pipe64\grqq, Start des Programms über Netbeans\\
	\hline
	\textbf{Akteure} & gesamtes Mirkofonarray, Rasberry Pi, Kabel(kurz)\\
	\hline
	\textbf{Vorbedingung} & Das System ist vollständig montiert, 
	Raspberry eingeschaltet\\
	\hline
	\textbf{Nachbedingung} & Lokalisierungsergebnisse grafisch auf Plausibilität überprüft.\\
	\hline
	\textbf{Ergebnis} & Bearbeitetes .png-Datei\\
	\hline
	\textbf{Hauptszenario} & \begin{description}[font=\normalfont]
		\item[1.] Über \glqq run\grqq\ wird das Hauptprogramm in der IDE gestartet
		\item[2.] 4 Sekunden warten
		\item[3.] Mit \glqq sudo ./mic\_handler\_pipe64\grqq\ wird die pipe geöffnet
		\item[4.] Geräuschevent wird erzeugt
		\item[5.] Event wird erkannt und auf Konsole angezeigt
		\item[6.] Wenn das Event im Bildbereich erzeugt wurde, wird ein Bild aufgezeichnet
		\item[7.] Bild wird bearbeitet und abgespeichert
		\item[8.] Bild wird auf Zweitgerät geladen
		\item[9.] Bild wird auf Plausibilität überprüft
	\end{description}\\
	\hline
	\textbf{Alternativszenario} & \begin{description}[font=\normalfont]
		\item[5.b] Event wird nicht korrekt erkannt
		\item[5.c] Pegelerkennung wird angepasst
		\item[5.d] Event wird wiederholt
		\item[6.b] Event wurde im Bildbereich erzeugt aber nicht dort lokalisiert
		\item[6.c] Event wird wiederholt
		\item[9.b] Bearbeitetes Bild entspricht nicht den Erwartungen
		\item[9.c] Lokalisierungsparameter (Buffer wird angepasst)
		\item[9.d] Event wird wiederholt
	\end{description}\\
	\hline
	%	\textbf{Ausnahmeszenario} & \\
	%	\hline
	%	\textbf{Qualitäten} & \\
	%	\hline
\end{tabularx}
\captionof{table}{Gesamt-Funktionstest}
\label{tab:Gesamt-Funktionstest}

\newpage
