plastikpamaro/bachelorprojekt2020/Dokumentation/Blanko_Tabelle_Tests.txt

\begin{tabularx}{\columnwidth}{|p{4cm}|X|}
	\hline
	\textbf{Abschnitt} & \textbf{Inhalt}\\
	\hline
	\textbf{Name} & \\
	\hline
	\textbf{Autor(en)} & \\
	\hline
	\textbf{Priorität} & \\	
	\hline	
	\textbf{Kritikalität} &\\
	\hline
	\textbf{Quelle} & \\
	\hline
	\textbf{Verantwortlicher} & \\
	\hline
	\textbf{Kurzbeschreibung} & \\
	\hline
	\textbf{Auslösendes Ereignis} & \\
	\hline
	\textbf{Akteure} & \\
	\hline
	\textbf{Vorbedingung} & \\
	\hline
	\textbf{Nachbedingung} & \\
	\hline
	\textbf{Ergebnis} & \\
	\hline
	\textbf{Hauptszenario} &\\
	\hline
	\textbf{Alternativszenario} & \\
	\hline
	\textbf{Ausnahmeszenario} & \\
	\hline
	\textbf{Qualitäten} & \\
	\hline
\end{tabularx}
\captionof{table}{}
\label{tab:}
