plastikpamaro/bachelorprojekt2020/Dokumentation/Sections/Programmierung/Test_1_b.png

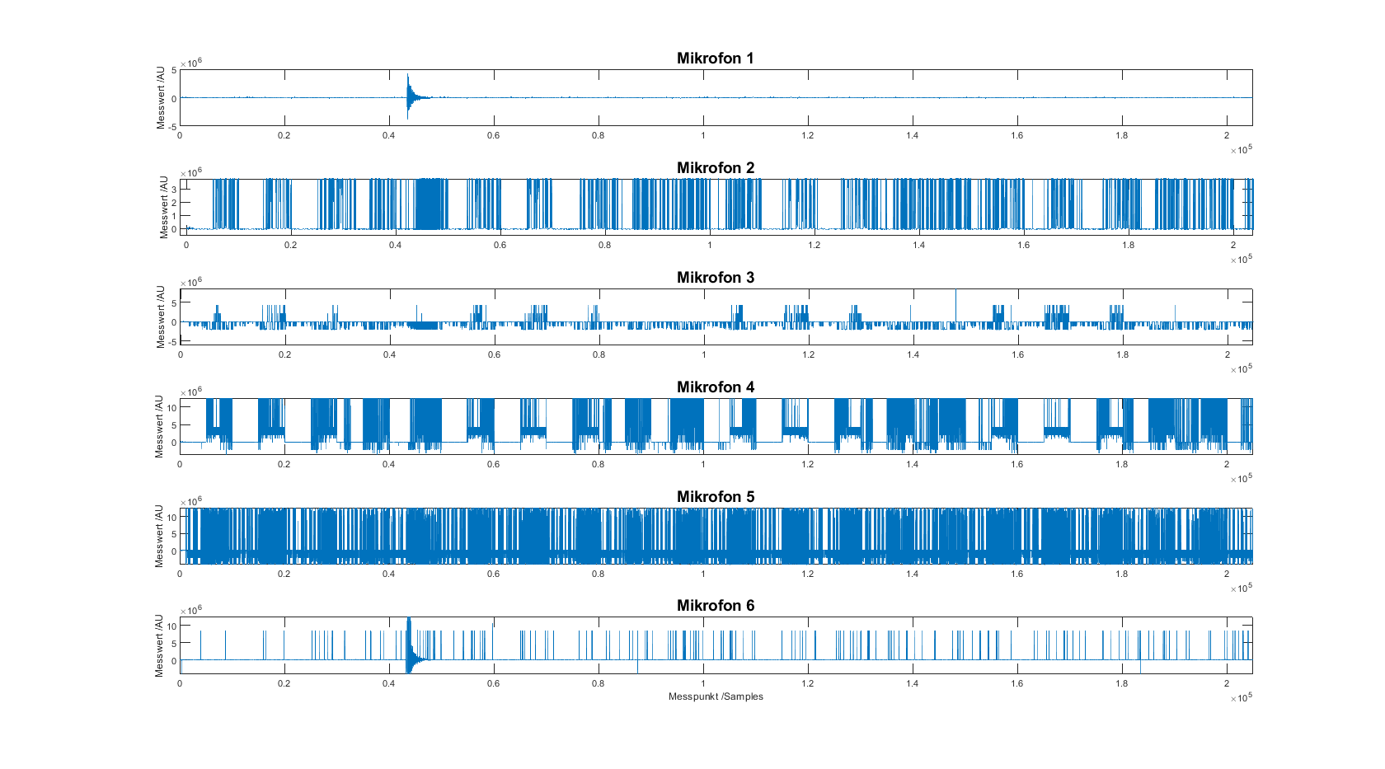
Dokumentation/Sections/Programmierung/Test_1_b.png
