plastikpamaro/bachelorprojekt2020/Dokumentenschleuse/Doku_Philipp/Test_1_c.png

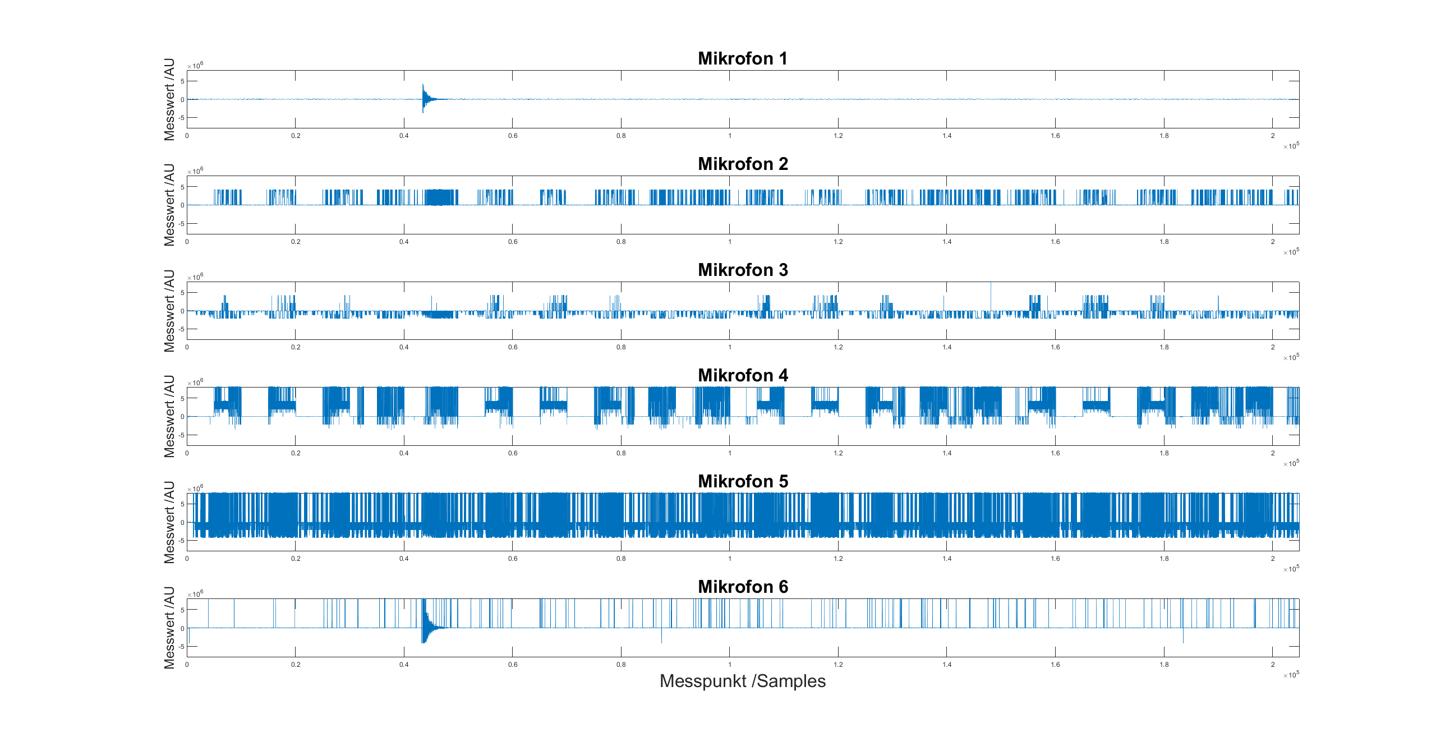
Dokumentenschleuse/Doku_Philipp/Test_1_c.png
