plastikpamaro/bachelorprojekt2020/Dokumentenschleuse/Doku_Philipp/Test_2_c.png

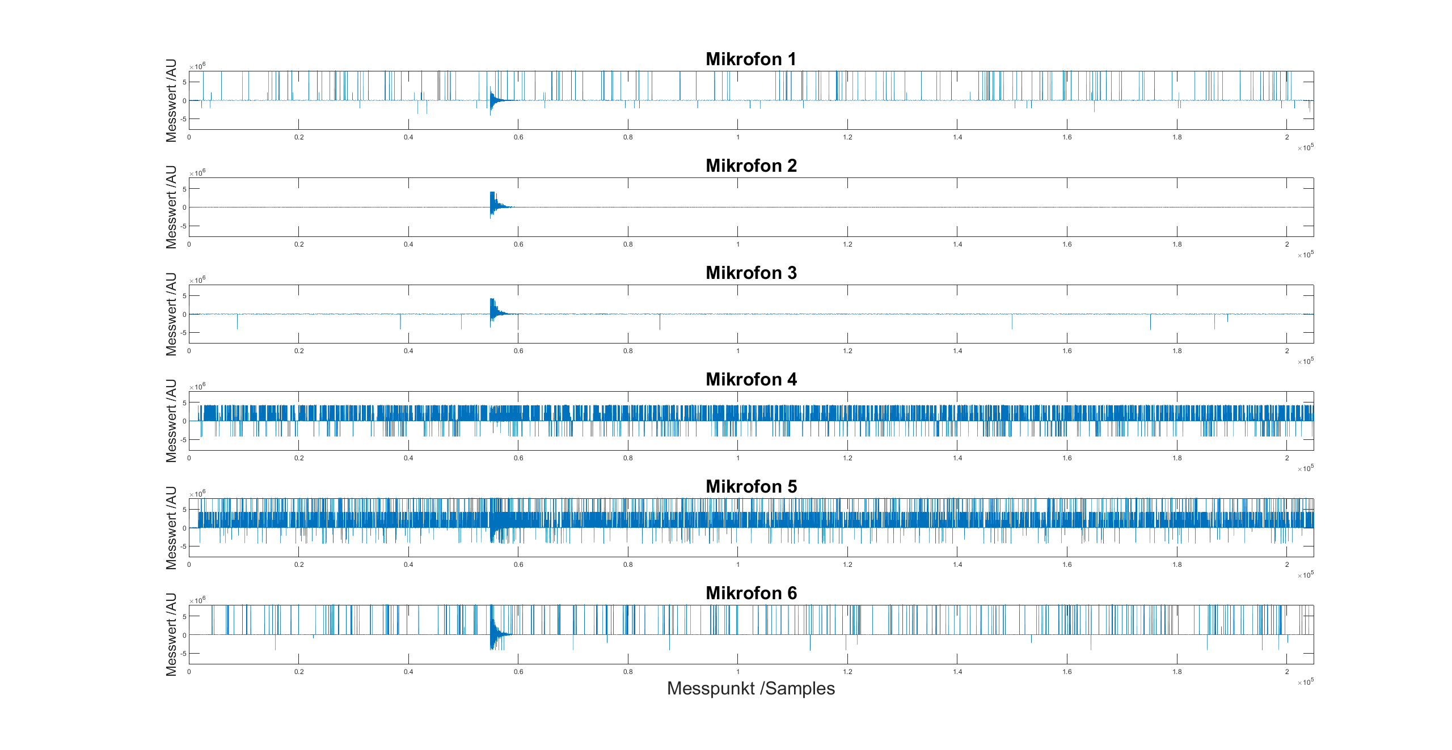
Dokumentenschleuse/Doku_Philipp/Test_2_c.png
