plastikpamaro/bachelorprojekt2020/Dokumentenschleuse/Doku_Philipp/Test_3.png

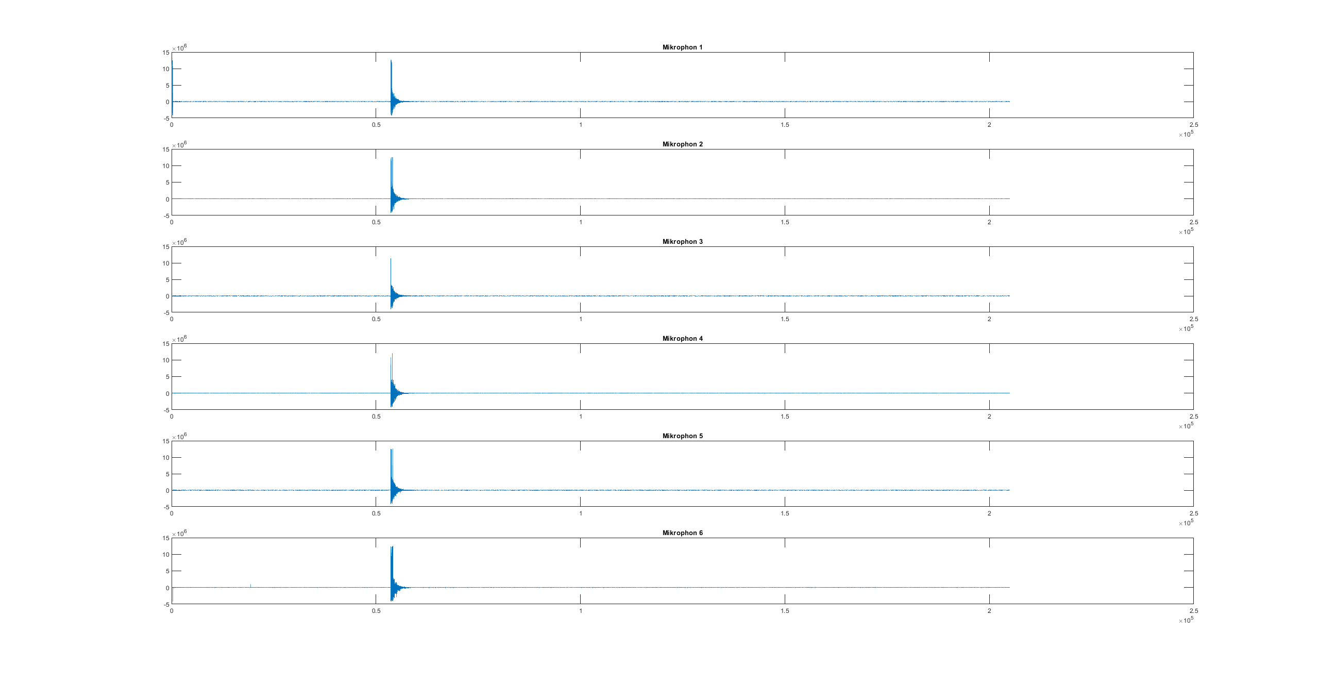
Dokumentenschleuse/Doku_Philipp/Test_3.png
