plastikpamaro/bachelorprojekt2020/Dokumentenschleuse/Doku_Philipp/Test_3_c.png

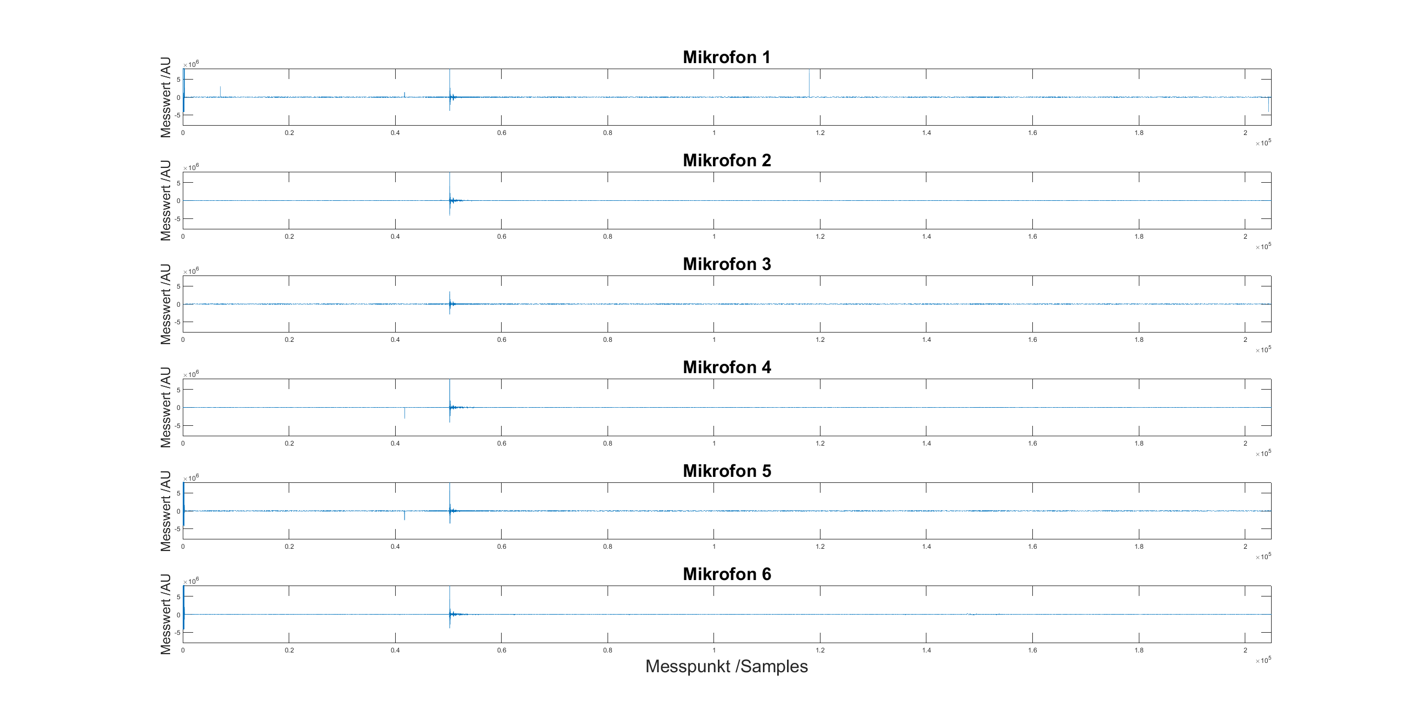
Dokumentenschleuse/Doku_Philipp/Test_3_c.png
