plastikpamaro/bachelorprojekt2020/Dokumentenschleuse/Doku_Philipp/Test_6.png

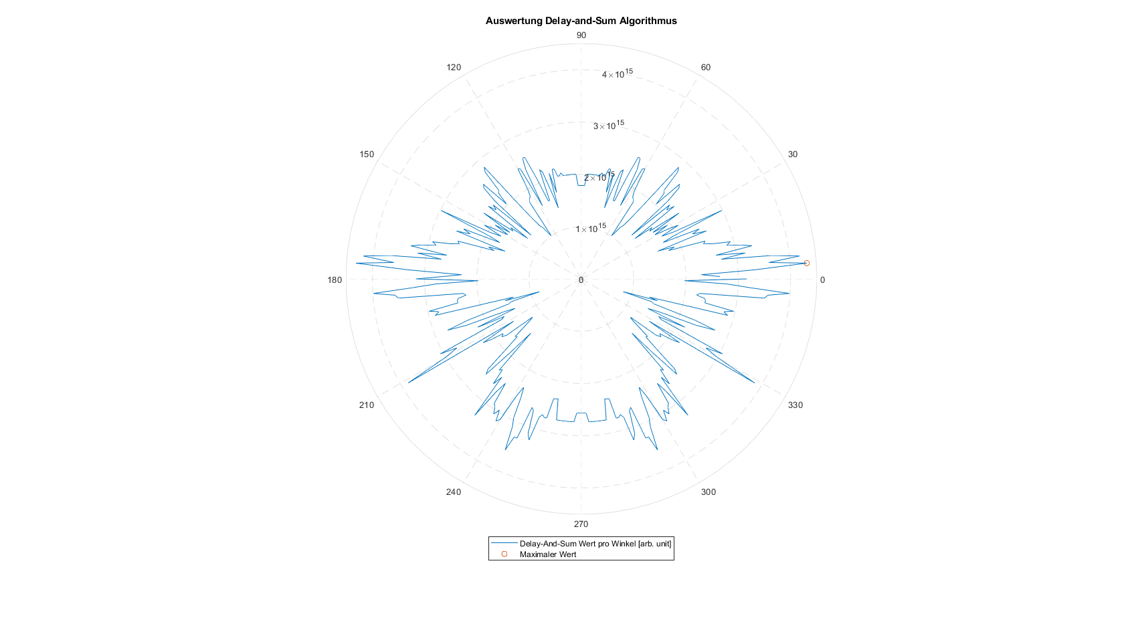
Dokumentenschleuse/Doku_Philipp/Test_6.png
