plastikpamaro/bachelorprojekt2020/Entwicklung/SinusTest.png

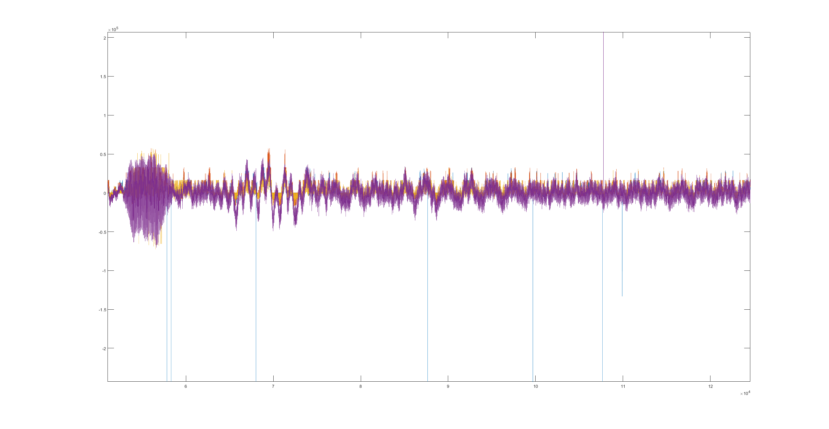
Entwicklung/SinusTest.png
