plastikpamaro/bachelorprojekt2020/Dokumentation/Sections/Brainstorming/2020-10-15_Brainstorming.pdf

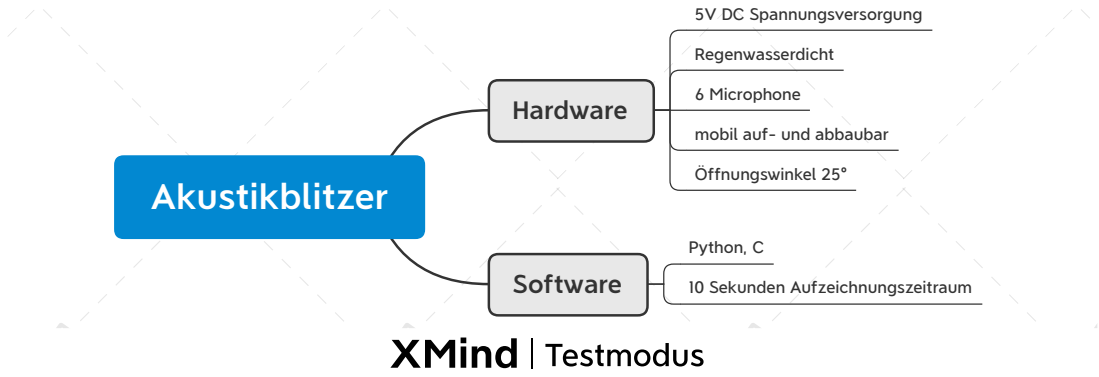
[picture p235: page 1]
Akustikblitzer; Hardware; 5V DC Spannungsversorgung; Software; Python, C; 10 Sekunden Aufzeichnungszeitraum; Regenwasserdicht; 6 Microphone; Öffnungswinkel 25°

mobil auf- und abbaubar
