plastikpamaro/bachelorprojekt2020/20-11-23_Statusbericht_1/psp.pdf

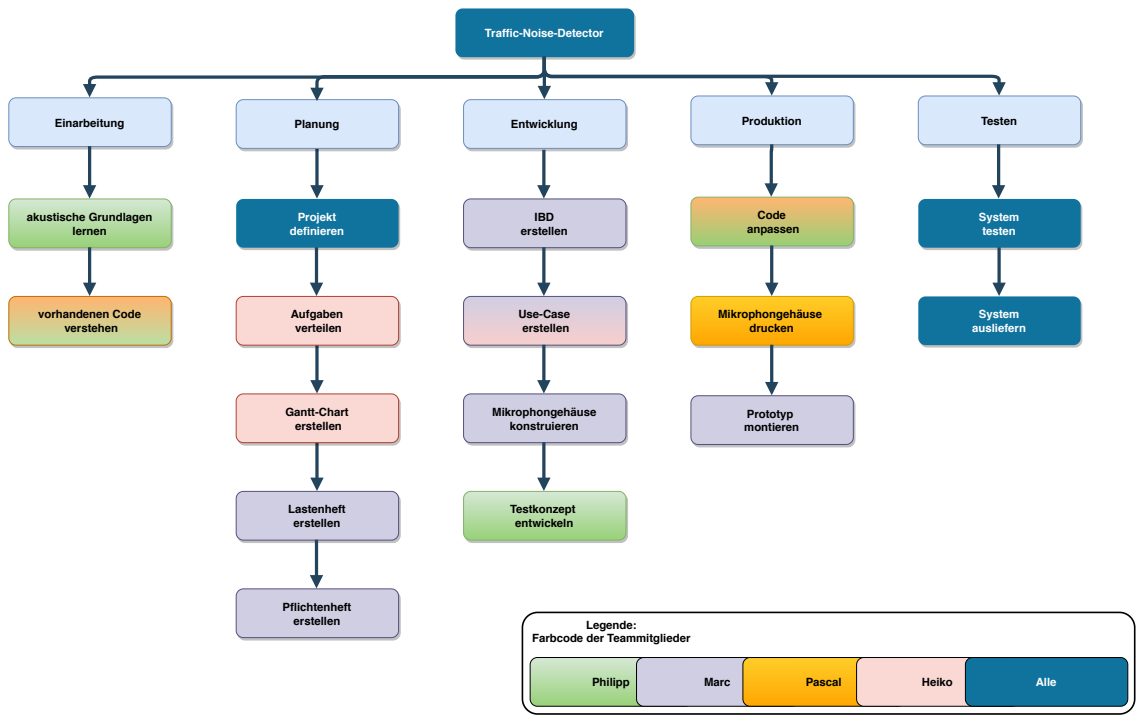
[picture p236: page 1]
Philipp; Marc; Einarbeitung; Entwicklung; Testen; akustische Grundlagen lernen; Produktion; vorhandenen Code verstehen; Projekt definieren; Lastenheft erstellen; Gantt-Chart erstellen; Pflichtenheft erstellen; Aufgaben verteilen; IBD erstellen; Use-Case erstellen; Code anpassen; Mikrophongehäuse konstruieren; Mikrophongehäuse drucken; Testkonzept entwickeln; Prototyp montieren; System testen; System ausliefern; Planung; Pascal; Heiko; Alle; Legende:

Traffic-Noise-Detector

Farbcode der Teammitglieder
