plastikpamaro/bachelorprojekt2020/Organisation/Schluesselantrag.pdf

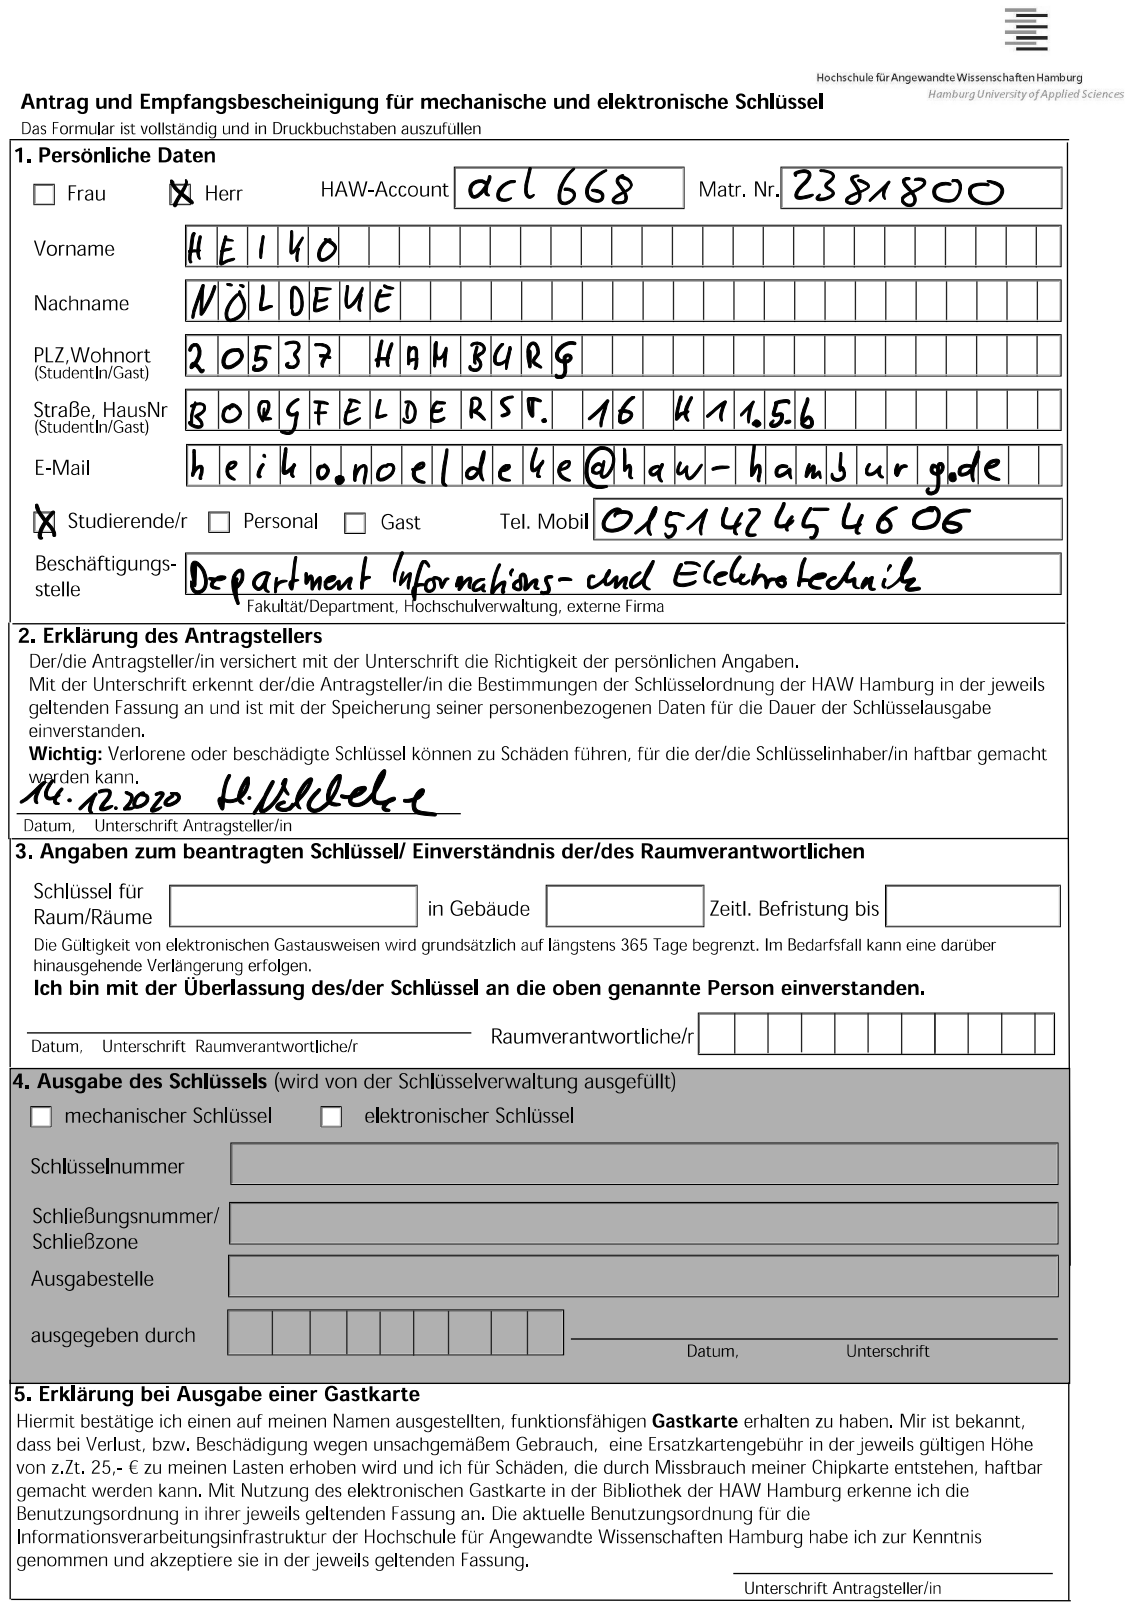
[picture p237: page 1]
