plastikpamaro/bachelorprojekt2020/Dokumentenschleuse/uc_Traffic Noise Detector.pdf

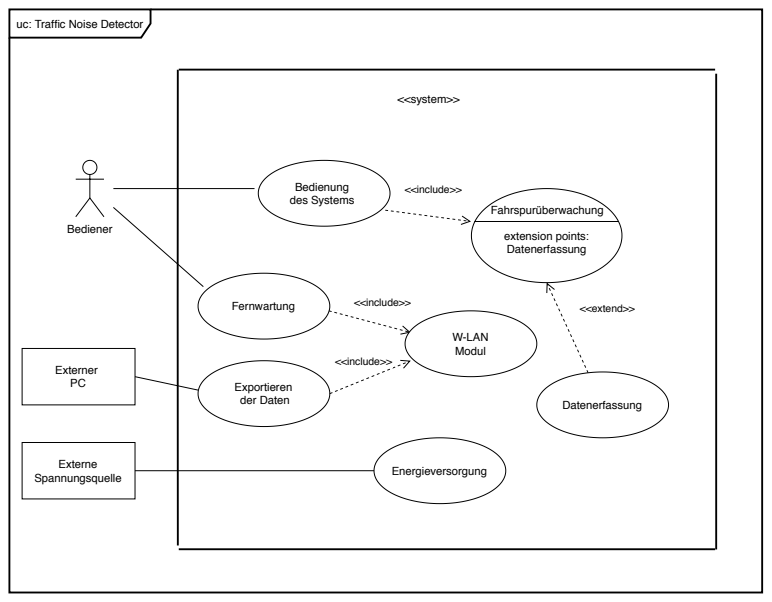
[picture p238: page 1]
Bediener; <<system>>; Fernwartung; Externe Spannungsquelle; Bedienung des Systems; <<include>>; Energieversorgung; Exportieren der Daten; Externer PC; W-LAN Modul; Datenerfassung; <<extend>>; extension points: Datenerfassung; Fahrspurüberwachung

uc: Traffic Noise Detector
