plastikpamaro/bachelorprojekt2020/Sitzungen/20-10-22 Dokumentation.pdf

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

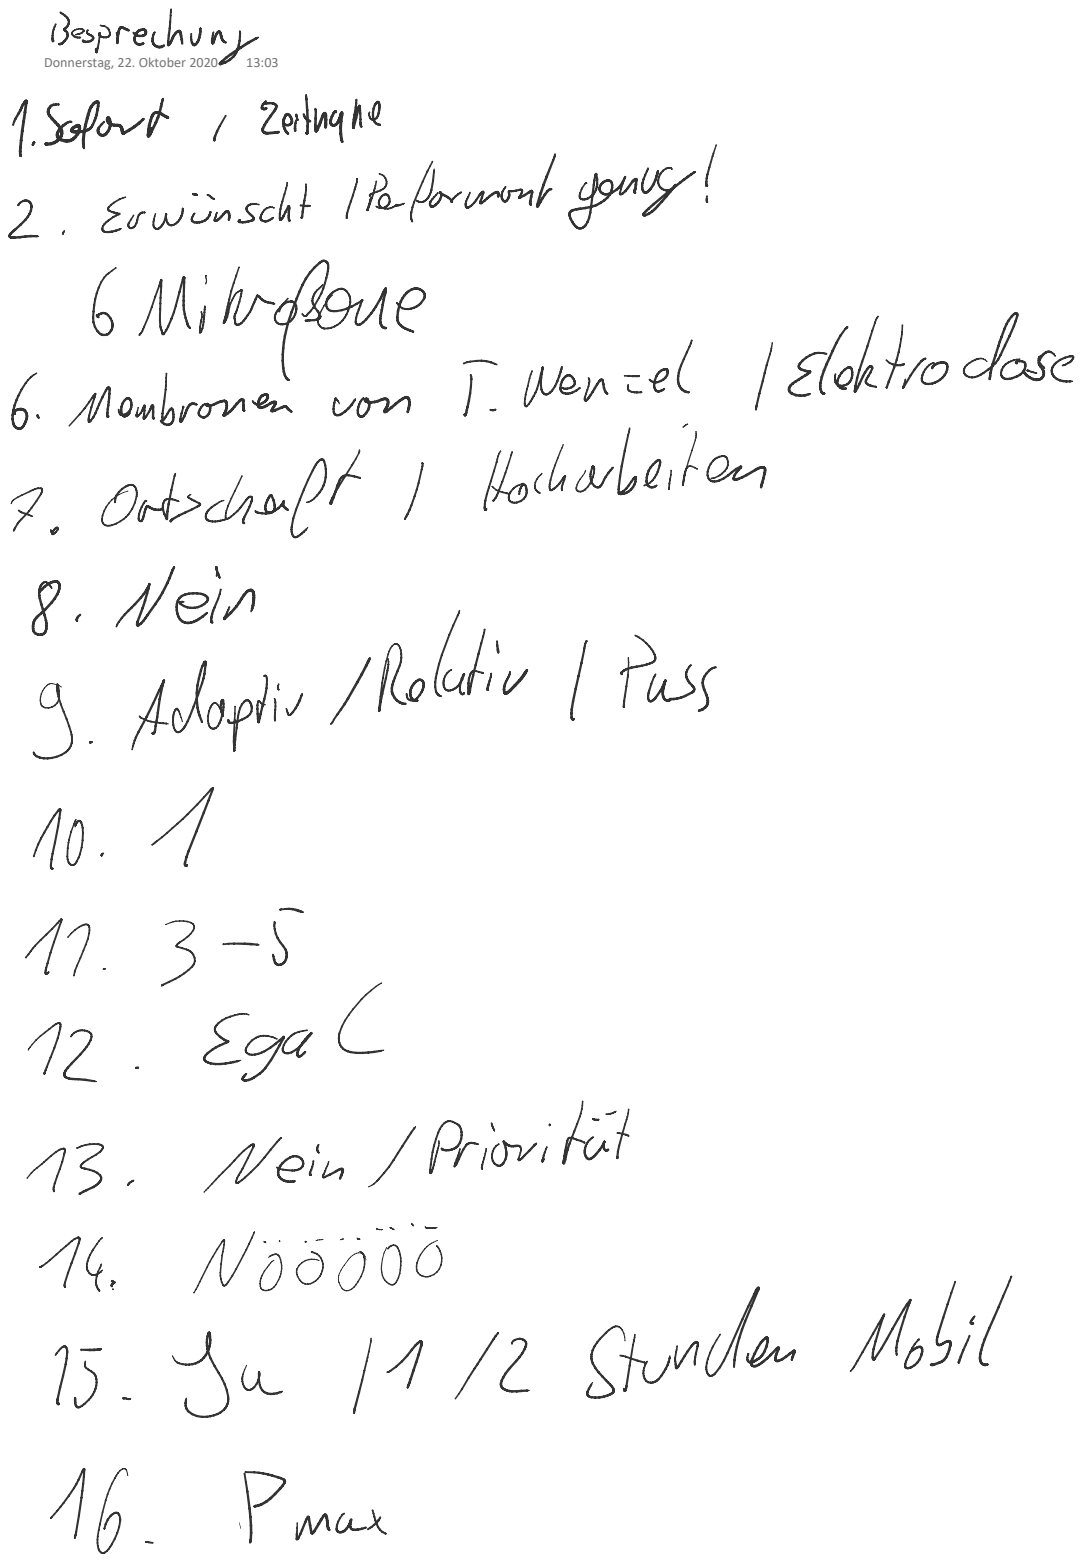
[picture p239: page 1]

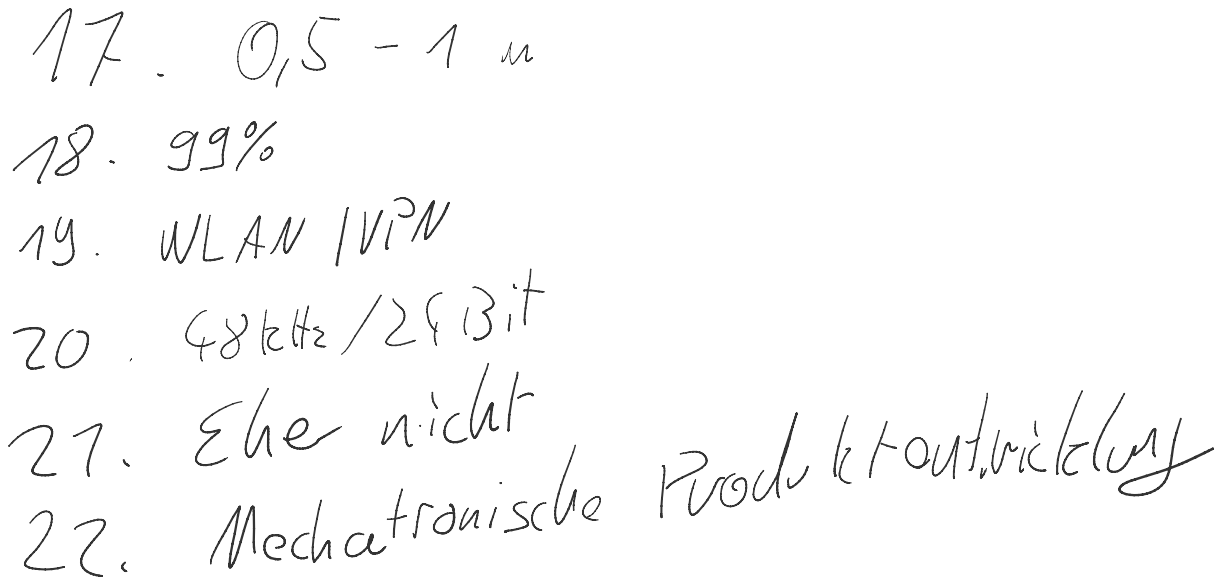
[picture p240: page 2]
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
