plastikpamaro/bachelorprojekt2020/21-02-19-Kickoff/Studienarbeit/GehäuseCad/Gehäuse/Gehäusezusammenbau.pdf

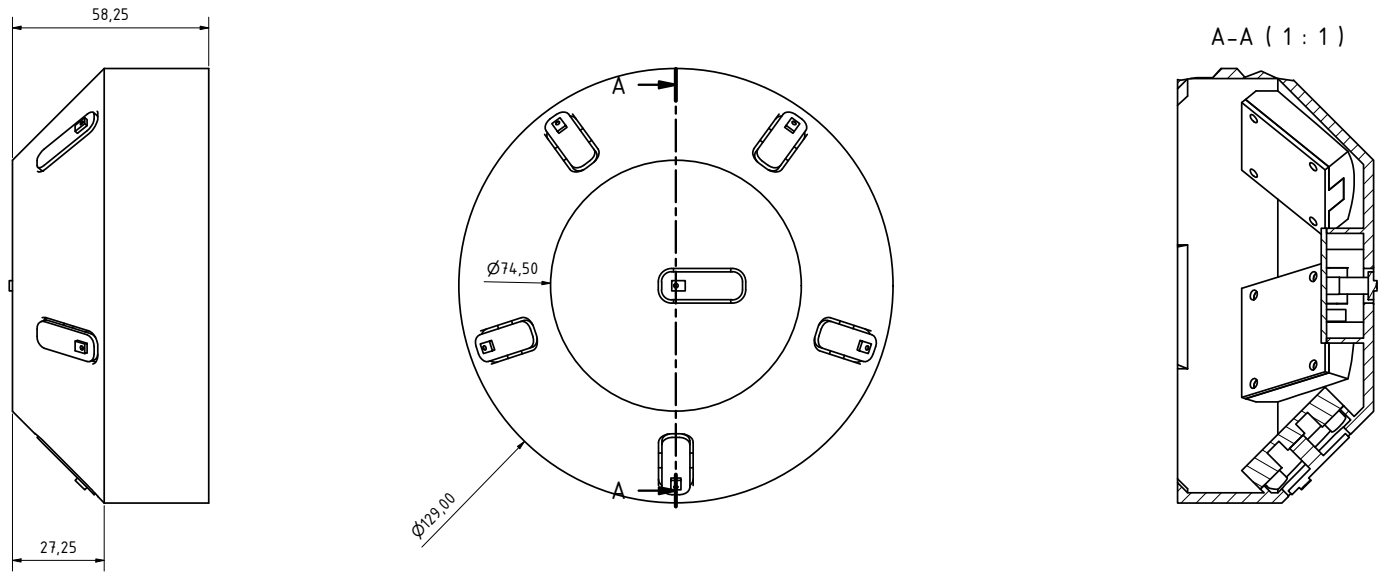
[picture p241: page 1]

Datum | Name

Gezeichn | 03.06.2020 | Max

Kontroll

Norm
