plastikpamaro/bachelorprojekt2020/21-02-19-Kickoff/Studienarbeit/uC Code/MSM_TDM/MultisensorBoard/src/yas_acc_driver-lis331dlh-LAPTOP-SEQVLDEN.c

/*
 * yas_acc_driver_lis331dlh.c
 *
 * Created: 12.09.2017 12:42:17
 *  Author: USER
 */ 

/*
 * Copyright (c) 2010 Yamaha Corporation
 *
 * This software is provided 'as-is', without any express or implied
 * warranty.  In no event will the authors be held liable for any damages
 * arising from the use of this software.
 *
 * Permission is granted to anyone to use this software for any purpose,
 * including commercial applications, and to alter it and redistribute it
 * freely, subject to the following restrictions:
 *
 * 1. The origin of this software must not be misrepresented; you must not
 *    claim that you wrote the original software. If you use this software
 *    in a product, an acknowledgment in the product documentation would be
 *    appreciated but is not required.
 * 2. Altered source versions must be plainly marked as such, and must not be
 *    misrepresented as being the original software.
 * 3. This notice may not be removed or altered from any source distribution.
 */

//#include "yas.h"
#include <stdint.h>
#include "asf.h"
#include "yas_acc_driver-lis331dlh.h"




/* -------------------------------------------------------------------------- */
/*  Structure definition                                                      */
/* -------------------------------------------------------------------------- */
/* Output data rate */
struct yas_lis331dlh_odr {
	unsigned long delay;          /* min delay (msec) in the range of ODR */
	unsigned char odr;            /* bandwidth register value             */
};

/* Axes data */
struct yas_lis331dlh_acceleration {
	int x;
	int y;
	int z;
	int x_raw;
	int y_raw;
	int z_raw;
};

/* Driver private data */
struct yas_lis331dlh_data {
	int initialize;
	int i2c_open;
	int enable;
	int delay;
	int position;
	int threshold;
	int filter_enable;
	uint8_t odr;
	struct yas_vector offset;
	struct yas_lis331dlh_acceleration last;
};

/* -------------------------------------------------------------------------- */
/*  Data                                                                      */
/* -------------------------------------------------------------------------- */
/* Control block */
static struct yas_acc_driver   cb;
static struct yas_acc_driver  *pcb;
static struct yas_lis331dlh_data  acc_data;

/* Output data rate */
static const struct yas_lis331dlh_odr yas_lis331dlh_odr_tbl[] = {
	{1,    0x38},                       /* ODR = 1000 (Hz) */
	{3,    0x30},                       /*        400      */
	{10,   0x28},                       /*        100      */
	{20,   0x20},                       /*         50      */
	{100,  0xc0 | YAS_DR_LP_LPF_780HZ}, /*         10      */
	{200,  0xa0 | YAS_DR_LP_LPF_780HZ}, /*          5      */
	{500,  0x80 | YAS_DR_LP_LPF_780HZ}, /*          2      */
	{1000, 0x60 | YAS_DR_LP_LPF_780HZ}, /*          1      */
	{2000, 0x40 | YAS_DR_LP_LPF_780HZ}, /*          0.5    */
};

/* Transformation matrix for chip mounting position */
static const int yas_lis331dlh_position_map[][3][3] = {
	{ {-1,  0,  0}, { 0, -1,  0}, { 0,  0,  1} }, /* top/upper-left */
	{ { 0, -1,  0}, { 1,  0,  0}, { 0,  0,  1} }, /* top/upper-right */
	{ { 1,  0,  0}, { 0,  1,  0}, { 0,  0,  1} }, /* top/lower-right */
	{ { 0,  1,  0}, {-1,  0,  0}, { 0,  0,  1} }, /* top/lower-left */
	{ { 1,  0,  0}, { 0, -1,  0}, { 0,  0, -1} }, /* bottom/upper-left */
	{ { 0,  1,  0}, { 1,  0,  0}, { 0,  0, -1} }, /* bottom/upper-right */
	{ {-1,  0,  0}, { 0,  1,  0}, { 0,  0, -1} }, /* bottom/lower-right */
	{ { 0, -1,  0}, {-1,  0,  0}, { 0,  0, -1} }, /* bottom/lower-right */
};

/* -------------------------------------------------------------------------- */
/*  Prototype declaration                                                     */
/* -------------------------------------------------------------------------- */
static void yas_lis331dlh_init_data(void);
static int yas_lis331dlh_ischg_enable(int);
static int yas_lis331dlh_read_reg(unsigned char, unsigned char *,
				  unsigned char);
static int yas_lis331dlh_write_reg(unsigned char, unsigned char *,
				   unsigned char);
static int yas_lis331dlh_read_reg_byte(unsigned char);
static int yas_lis331dlh_write_reg_byte(int, int);
//static int yas_lis331dlh_lock(void);
//static int yas_lis331dlh_unlock(void);
//static int yas_lis331dlh_i2c_open(void);
//static int yas_lis331dlh_i2c_close(void);
#if 0
static int yas_lis331dlh_msleep(int);
#endif
static int yas_lis331dlh_power_up(void);
static int yas_lis331dlh_power_down(void);
static int yas_lis331dlh_init(void);
static int yas_lis331dlh_term(void);
static int yas_lis331dlh_get_delay(void);
static int yas_lis331dlh_set_delay(int);
static int yas_lis331dlh_get_offset(struct yas_vector *);
static int yas_lis331dlh_set_offset(struct yas_vector *);
static int yas_lis331dlh_get_enable(void);
static int yas_lis331dlh_set_enable(int);
static int yas_lis331dlh_get_filter(struct yas_acc_filter *);
static int yas_lis331dlh_set_filter(struct yas_acc_filter *);
static int yas_lis331dlh_get_filter_enable(void);
static int yas_lis331dlh_set_filter_enable(int);
static int yas_lis331dlh_get_position(void);
static int yas_lis331dlh_set_position(int);
static int yas_lis331dlh_measure(int *, int *);

/* -------------------------------------------------------------------------- */
/*  Local functions                                                           */
/* -------------------------------------------------------------------------- */

static void yas_lis331dlh_init_data(void)
{
	acc_data.initialize = 0;
	acc_data.enable = 0;
	acc_data.delay = YAS_LIS331DLH_DEFAULT_DELAY;
	acc_data.offset.v[0] = 0;
	acc_data.offset.v[1] = 0;
	acc_data.offset.v[2] = 0;
	acc_data.position = YAS_LIS331DLH_DEFAULT_POSITION;
	acc_data.threshold = YAS_ACC_DEFAULT_FILTER_THRESH;
	acc_data.filter_enable = 0;
	acc_data.odr = 0;
	acc_data.last.x = 0;
	acc_data.last.y = 0;
	acc_data.last.z = 0;
	acc_data.last.x_raw = 0;
	acc_data.last.y_raw = 0;
	acc_data.last.z_raw = 0;
}

static int yas_lis331dlh_ischg_enable(int enable)
{
	if (acc_data.enable == enable)
		return 0;

	return 1;
}

/* register access functions */
static int yas_lis331dlh_read_reg(unsigned char adr, unsigned char *buf,
				  unsigned char len)
{
	twi_packet_t packet_rx;

	/* Configure the data packet to be received */
	packet_rx.chip        = LIS331DLH_TWI_ADDR;
	packet_rx.addr[0]     = (uint8_t) adr;
	packet_rx.addr_length = 1;
	packet_rx.buffer      = buf;
	packet_rx.length      = (uint8_t) len;
	
	if (twi_master_read(TWI4, &packet_rx) != TWI_SUCCESS)
	{
		
	}	
	//struct yas_acc_driver_callback *cbk = &pcb->callback;
	//int err;
//
	//if (acc_data.i2c_open) {
		//err = cbk->device_read(adr, buf, len);
		//if (err != 0)
			//return err;
//
		//return err;
	//}
//
	return YAS_NO_ERROR;
}

static int yas_lis331dlh_write_reg(unsigned char adr, unsigned char *buf,
				   unsigned char len)
{
	twi_packet_t packet_tx;
	
	/* Configure the data packet to be transmitted */
	packet_tx.chip        = LIS331DLH_TWI_ADDR;
	packet_tx.addr[0]     = (uint8_t) adr;
	packet_tx.addr_length = 1;
	packet_tx.buffer      = buf;
	packet_tx.length      = (uint8_t) len;
	
	if (twi_master_write(TWI4, &packet_tx) != TWI_SUCCESS)
	{
		
	}
	//struct yas_acc_driver_callback *cbk = &pcb->callback;
	//int err;
//
	//if (acc_data.i2c_open) {
		//err = cbk->device_write(adr, buf, len);
		//if (err != 0)
			//return err;
//
		//return err;
	//}
//
	return YAS_NO_ERROR;
}

static int yas_lis331dlh_read_reg_byte(unsigned char adr)
{
	unsigned char buf;
	int err;

	err = yas_lis331dlh_read_reg(adr, &buf, 1);
	if (err == 0)
		return buf;

	return 0;
}

static int yas_lis331dlh_write_reg_byte(int adr, int val)
{
	return yas_lis331dlh_write_reg((unsigned char)adr,
				       (unsigned char *)&val, 1);
}

#define yas_lis331dlh_read_bits(r) \
	((yas_lis331dlh_read_reg_byte(r##_REG) & r##_MASK) >> r##_SHIFT)

#define yas_lis331dlh_update_bits(r, v) \
	yas_lis331dlh_write_reg_byte(r##_REG, \
				     ((yas_lis331dlh_read_reg_byte(r##_REG) & \
				       ~r##_MASK) | ((v) << r##_SHIFT)))

//static int yas_lis331dlh_lock(void)
//{
	//struct yas_acc_driver_callback *cbk = &pcb->callback;
	//int err;
//
	//if (cbk->lock != NULL && cbk->unlock != NULL)
		//err = cbk->lock();
	//else
		//err = YAS_NO_ERROR;
//
	//return err;
//}
//
//static int yas_lis331dlh_unlock(void)
//{
	//struct yas_acc_driver_callback *cbk = &pcb->callback;
	//int err;
//
	//if (cbk->lock != NULL && cbk->unlock != NULL)
		//err = cbk->unlock();
	//else
		//err = YAS_NO_ERROR;
//
	//return err;
//}

//static int yas_lis331dlh_i2c_open(void)
//{
	//struct yas_acc_driver_callback *cbk = &pcb->callback;
	//int err;
//
	//if (acc_data.i2c_open == 0) {
		//err = cbk->device_open();
		//if (err != YAS_NO_ERROR)
			//return YAS_ERROR_DEVICE_COMMUNICATION;
		//acc_data.i2c_open = 1;
	//}
//
	//return YAS_NO_ERROR;
//}
//
//static int yas_lis331dlh_i2c_close(void)
//{
	//struct yas_acc_driver_callback *cbk = &pcb->callback;
	//int err;
//
	//if (acc_data.i2c_open != 0) {
		//err = cbk->device_close();
		//if (err != YAS_NO_ERROR)
			//return YAS_ERROR_DEVICE_COMMUNICATION;
		//acc_data.i2c_open = 0;
	//}
	//return YAS_NO_ERROR;
//}
#if 0
static int yas_lis331dlh_msleep(int msec)
{
	struct yas_acc_driver_callback *cbk = &pcb->callback;
	if (msec <= 0)
		return YAS_ERROR_ARG;
	cbk->msleep(msec);
	return YAS_NO_ERROR;
}
#endif
static int yas_lis331dlh_power_up(void)
{
	yas_lis331dlh_write_reg_byte(YAS_LIS331DLH_CTRL_REG1, acc_data.odr |
				     YAS_LIS331DLH_XYZ_ENABLE);

	return YAS_NO_ERROR;
}

static int yas_lis331dlh_power_down(void)
{
	yas_lis331dlh_write_reg_byte(YAS_LIS331DLH_CTRL_REG1,
				 YAS_LIS331DLH_XYZ_ENABLE);

	return YAS_NO_ERROR;
}

static int yas_lis331dlh_init(void)
{
	struct yas_acc_filter filter;
	//int err;
	int id;

	/* Check intialize */
	if (acc_data.initialize == 1)
		return YAS_ERROR_NOT_INITIALIZED;

	/* Init data */
	yas_lis331dlh_init_data();

	/* Open i2c */
	//err = yas_lis331dlh_i2c_open();
	//if (err != YAS_NO_ERROR)
		//return err;

	/* Check id */
	id = yas_lis331dlh_read_reg_byte(YAS_LIS331DLH_WHO_AM_I_REG);
	if (id != YAS_LIS331DLH_WHO_AM_I) {
		//yas_lis331dlh_i2c_close();
		return YAS_ERROR_CHIP_ID;
	}

	yas_lis331dlh_write_reg_byte(YAS_LIS331DLH_CTRL_REG1,
				     YAS_LIS331DLH_XYZ_ENABLE);
	yas_lis331dlh_write_reg_byte(YAS_LIS331DLH_CTRL_REG2, 0);
	yas_lis331dlh_write_reg_byte(YAS_LIS331DLH_CTRL_REG3, 0);
	yas_lis331dlh_write_reg_byte(YAS_LIS331DLH_CTRL_REG4,
				     YAS_LIS331DLH_FS_2G |
				     YAS_LIS331DLH_BDU_ON |
				     YAS_LIS331DLH_BLE_LE);
	yas_lis331dlh_write_reg_byte(YAS_LIS331DLH_CTRL_REG5, 0);

	acc_data.initialize = 1;

	yas_lis331dlh_set_delay(YAS_LIS331DLH_DEFAULT_DELAY);
	yas_lis331dlh_set_position(YAS_LIS331DLH_DEFAULT_POSITION);
	filter.threshold = YAS_ACC_DEFAULT_FILTER_THRESH;
	yas_lis331dlh_set_filter(&filter);

	return YAS_NO_ERROR;
}

static int yas_lis331dlh_term(void)
{
	/* Check initialize */
	if (acc_data.initialize == 0)
		return YAS_ERROR_NOT_INITIALIZED;

	yas_lis331dlh_set_enable(0);

	/* Close I2C */
	//yas_lis331dlh_i2c_close();

	acc_data.initialize = 0;

	return YAS_NO_ERROR;
}

static int yas_lis331dlh_get_delay(void)
{
	/* Check initialize */
	if (acc_data.initialize == 0)
		return YAS_ERROR_NOT_INITIALIZED;

	return acc_data.delay;
}

static int yas_lis331dlh_set_delay(int delay)
{
	int i;

	/* Check initialize */
	if (acc_data.initialize == 0)
		return YAS_ERROR_NOT_INITIALIZED;

	/* Determine optimum odr */
	for (i = 1; i < (int)(sizeof(yas_lis331dlh_odr_tbl) /
			      sizeof(struct yas_lis331dlh_odr)) &&
		     delay >= (int)yas_lis331dlh_odr_tbl[i].delay; i++)
		;

	acc_data.odr = yas_lis331dlh_odr_tbl[i-1].odr;
	acc_data.delay = delay;

	if (yas_lis331dlh_get_enable())
		yas_lis331dlh_write_reg_byte(YAS_LIS331DLH_CTRL_REG1,
					     acc_data.odr |
					     YAS_LIS331DLH_XYZ_ENABLE);
	else
		yas_lis331dlh_write_reg_byte(YAS_LIS331DLH_CTRL_REG1,
					     YAS_LIS331DLH_XYZ_ENABLE);

	return YAS_NO_ERROR;
}

static int yas_lis331dlh_get_offset(struct yas_vector *offset)
{
	/* Check initialize */
	if (acc_data.initialize == 0)
		return YAS_ERROR_NOT_INITIALIZED;

	*offset = acc_data.offset;

	return YAS_NO_ERROR;
}

static int yas_lis331dlh_set_offset(struct yas_vector *offset)
{
	/* Check initialize */
	if (acc_data.initialize == 0)
		return YAS_ERROR_NOT_INITIALIZED;

	acc_data.offset = *offset;

	return YAS_NO_ERROR;
}

static int yas_lis331dlh_get_enable(void)
{
	/* Check initialize */
	if (acc_data.initialize == 0)
		return YAS_ERROR_NOT_INITIALIZED;

	return acc_data.enable;
}

static int yas_lis331dlh_set_enable(int enable)
{
	int err = 0;

	/* Check initialize */
	if (acc_data.initialize == 0)
		return YAS_ERROR_NOT_INITIALIZED;

	if (yas_lis331dlh_ischg_enable(enable)) {
		if (enable) {
			/* Open i2c */
			//err = yas_lis331dlh_i2c_open();
			if (err != YAS_NO_ERROR)
				return err;
			yas_lis331dlh_write_reg_byte(YAS_LIS331DLH_CTRL_REG1,
						     YAS_LIS331DLH_XYZ_ENABLE);
			yas_lis331dlh_write_reg_byte(YAS_LIS331DLH_CTRL_REG2,
						     0);
			yas_lis331dlh_write_reg_byte(YAS_LIS331DLH_CTRL_REG3,
						     0);
			yas_lis331dlh_write_reg_byte(YAS_LIS331DLH_CTRL_REG4,
						     YAS_LIS331DLH_FS_2G |
						     YAS_LIS331DLH_BDU_ON |
						     YAS_LIS331DLH_BLE_LE);
			yas_lis331dlh_write_reg_byte(YAS_LIS331DLH_CTRL_REG5,
						     0);
			yas_lis331dlh_set_delay(acc_data.delay);
			yas_lis331dlh_power_up();
		} else {
			yas_lis331dlh_power_down();
			//err = yas_lis331dlh_i2c_close();
			if (err != YAS_NO_ERROR)
				return err;
		}
	}

	acc_data.enable = enable;

	return YAS_NO_ERROR;
}

static int yas_lis331dlh_get_filter(struct yas_acc_filter *filter)
{
	/* Check initialize */
	if (acc_data.initialize == 0)
		return YAS_ERROR_NOT_INITIALIZED;

	filter->threshold = acc_data.threshold;

	return YAS_NO_ERROR;
}

static int yas_lis331dlh_set_filter(struct yas_acc_filter *filter)
{
	/* Check initialize */
	if (acc_data.initialize == 0)
		return YAS_ERROR_NOT_INITIALIZED;

	acc_data.threshold = filter->threshold;

	return YAS_NO_ERROR;
}

static int yas_lis331dlh_get_filter_enable(void)
{
	/* Check initialize */
	if (acc_data.initialize == 0)
		return YAS_ERROR_NOT_INITIALIZED;

	return acc_data.filter_enable;
}

static int yas_lis331dlh_set_filter_enable(int enable)
{
	/* Check initialize */
	if (acc_data.initialize == 0)
		return YAS_ERROR_NOT_INITIALIZED;

	acc_data.filter_enable = enable;

	return YAS_NO_ERROR;
}

static int yas_lis331dlh_get_position(void)
{
	/* Check initialize */
	if (acc_data.initialize == 0)
		return YAS_ERROR_NOT_INITIALIZED;

	return acc_data.position;
}

static int yas_lis331dlh_set_position(int position)
{
	/* Check initialize */
	if (acc_data.initialize == 0)
		return YAS_ERROR_NOT_INITIALIZED;

	acc_data.position = position;

	return YAS_NO_ERROR;
}

static int yas_lis331dlh_data_filter(int data[], int raw[],
				     struct yas_lis331dlh_acceleration *accel)
{
	int filter_enable = acc_data.filter_enable;
	int threshold = acc_data.threshold;

	if (filter_enable) {
		if ((ABS(acc_data.last.x - data[0]) > threshold) ||
		    (ABS(acc_data.last.y - data[1]) > threshold) ||
		    (ABS(acc_data.last.z - data[2]) > threshold)) {
			accel->x = data[0];
			accel->y = data[1];
			accel->z = data[2];
			accel->x_raw = raw[0];
			accel->y_raw = raw[1];
			accel->z_raw = raw[2];
		} else {
			*accel = acc_data.last;
		}
	} else {
		accel->x = data[0];
		accel->y = data[1];
		accel->z = data[2];
		accel->x_raw = raw[0];
		accel->y_raw = raw[1];
		accel->z_raw = raw[2];
	}

	return YAS_NO_ERROR;
}

static int yas_lis331dlh_measure(int *out_data, int *out_raw)
{
	struct yas_lis331dlh_acceleration accel;
	unsigned char buf[6];
	int32_t raw[3], data[3];
	int pos = acc_data.position;
	int i, j;

	/* Check initialize */
	if (acc_data.initialize == 0)
		return YAS_ERROR_NOT_INITIALIZED;

	/* Read acceleration data */
	if (yas_lis331dlh_read_reg(YAS_LIS331DLH_ACC_REG | 0x80, buf, 6) != 0)
		for (i = 0; i < 3; i++)
			raw[i] = 0;
	else
		for (i = 0; i < 3; i++)
			raw[i] = (int16_t)((buf[i*2+1] << 8) | buf[i*2]) >> 4;

	/* for X, Y, Z axis */
	for (i = 0; i < 3; i++) {
		/* coordinate transformation */
		data[i] = 0;
		for (j = 0; j < 3; j++)
			data[i] += raw[j] *
				yas_lis331dlh_position_map[pos][i][j];
		/* normalization */
		data[i] *= (YAS_LIS331DLH_GRAVITY_EARTH / 
			    YAS_LIS331DLH_RESOLUTION);
	}

	yas_lis331dlh_data_filter(data, raw, &accel);

	out_data[0] = accel.x - acc_data.offset.v[0];
	out_data[1] = accel.y - acc_data.offset.v[1];
	out_data[2] = accel.z - acc_data.offset.v[2];
	out_raw[0] = accel.x_raw;
	out_raw[1] = accel.y_raw;
	out_raw[2] = accel.z_raw;
	acc_data.last = accel;

	return YAS_NO_ERROR;
}

/* -------------------------------------------------------------------------- */
static int yas_init(void)
{
	int err;

	/* Check intialize */
	if (pcb == NULL)
		return YAS_ERROR_NOT_INITIALIZED;

	//yas_lis331dlh_lock();
	err = yas_lis331dlh_init();
	//yas_lis331dlh_unlock();

	return err;
}

static int yas_term(void)
{
	int err;

	/* Check intialize */
	if (pcb == NULL)
		return YAS_ERROR_NOT_INITIALIZED;

	//yas_lis331dlh_lock();
	err = yas_lis331dlh_term();
	//yas_lis331dlh_unlock();

	return err;
}

static int yas_get_delay(void)
{
	int ret;

	/* Check intialize */
	if (pcb == NULL)
		return YAS_ERROR_NOT_INITIALIZED;

	//yas_lis331dlh_lock();
	ret = yas_lis331dlh_get_delay();
	//yas_lis331dlh_unlock();

	return ret;
}

static int yas_set_delay(int delay)
{
	int err;

	/* Check intialize */
	if (pcb == NULL)
		return YAS_ERROR_NOT_INITIALIZED;

	if (delay < 0 || delay > YAS_LIS331DLH_MAX_DELAY)
		return YAS_ERROR_ARG;
	else if (delay < YAS_LIS331DLH_MIN_DELAY)
		delay = YAS_LIS331DLH_MIN_DELAY;

	//yas_lis331dlh_lock();
	err = yas_lis331dlh_set_delay(delay);
	//yas_lis331dlh_unlock();

	return err;
}

static int yas_get_offset(struct yas_vector *offset)
{
	int err;

	/* Check intialize */
	if (pcb == NULL)
		return YAS_ERROR_NOT_INITIALIZED;

	if (offset == NULL)
		return YAS_ERROR_ARG;

	//yas_lis331dlh_lock();
	err = yas_lis331dlh_get_offset(offset);
	//yas_lis331dlh_unlock();

	return err;
}

static int yas_set_offset(struct yas_vector *offset)
{
	int err;

	/* Check intialize */
	if (pcb == NULL)
		return YAS_ERROR_NOT_INITIALIZED;

	if (offset == NULL ||
	    offset->v[0] < YAS_LIS331DLH_ABSMIN_2G ||
	    YAS_LIS331DLH_ABSMAX_2G < offset->v[0] ||
	    offset->v[1] < YAS_LIS331DLH_ABSMIN_2G ||
	    YAS_LIS331DLH_ABSMAX_2G < offset->v[1] ||
	    offset->v[2] < YAS_LIS331DLH_ABSMIN_2G ||
	    YAS_LIS331DLH_ABSMAX_2G < offset->v[2])
		return YAS_ERROR_ARG;

	//yas_lis331dlh_lock();
	err = yas_lis331dlh_set_offset(offset);
	//yas_lis331dlh_unlock();

	return err;
}

static int yas_get_enable(void)
{
	int err;

	/* Check intialize */
	if (pcb == NULL)
		return YAS_ERROR_NOT_INITIALIZED;

	//yas_lis331dlh_lock();
	err = yas_lis331dlh_get_enable();
	//yas_lis331dlh_unlock();

	return err;
}

static int yas_set_enable(int enable)
{
	int err;

	/* Check intialize */
	if (pcb == NULL)
		return YAS_ERROR_NOT_INITIALIZED;

	if (enable != 0)
		enable = 1;

	//yas_lis331dlh_lock();
	err = yas_lis331dlh_set_enable(enable);
	//yas_lis331dlh_unlock();

	return err;
}

static int yas_get_filter(struct yas_acc_filter *filter)
{
	int err;

	/* Check intialize */
	if (pcb == NULL)
		return YAS_ERROR_NOT_INITIALIZED;

	if (filter == NULL)
		return YAS_ERROR_ARG;

	//yas_lis331dlh_lock();
	err = yas_lis331dlh_get_filter(filter);
	//yas_lis331dlh_unlock();

	return err;
}

static int yas_set_filter(struct yas_acc_filter *filter)
{
	int err;

	/* Check intialize */
	if (pcb == NULL)
		return YAS_ERROR_NOT_INITIALIZED;

	if (filter == NULL || filter->threshold < 0 ||
	    filter->threshold > YAS_LIS331DLH_ABSMAX_2G)
		return YAS_ERROR_ARG;

	//yas_lis331dlh_lock();
	err = yas_lis331dlh_set_filter(filter);
	//yas_lis331dlh_unlock();

	return err;
}

static int yas_get_filter_enable(void)
{
	int err;

	/* Check intialize */
	if (pcb == NULL)
		return YAS_ERROR_NOT_INITIALIZED;

	//yas_lis331dlh_lock();
	err = yas_lis331dlh_get_filter_enable();
	//yas_lis331dlh_unlock();

	return err;
}

static int yas_set_filter_enable(int enable)
{
	int err;

	/* Check intialize */
	if (pcb == NULL)
		return YAS_ERROR_NOT_INITIALIZED;

	if (enable != 0)
		enable = 1;

	//yas_lis331dlh_lock();
	err = yas_lis331dlh_set_filter_enable(enable);
	//yas_lis331dlh_unlock();

	return err;
}

static int yas_get_position(void)
{
	int err;

	/* Check intialize */
	if (pcb == NULL)
		return YAS_ERROR_NOT_INITIALIZED;

	//yas_lis331dlh_lock();
	err = yas_lis331dlh_get_position();
	//yas_lis331dlh_unlock();

	return err;
}

static int yas_set_position(int position)
{
	int err;

	/* Check intialize */
	if (pcb == NULL)
		return YAS_ERROR_NOT_INITIALIZED;

	if (!((position >= 0) && (position <= 7)))
		return YAS_ERROR_ARG;

	//yas_lis331dlh_lock();
	err = yas_lis331dlh_set_position(position);
	//yas_lis331dlh_unlock();

	return err;
}

static int yas_measure(struct yas_acc_data *data)
{
	int err;

	/* Check intialize */
	if (pcb == NULL)
		return YAS_ERROR_NOT_INITIALIZED;

	if (data == NULL)
		return YAS_ERROR_ARG;

	//yas_lis331dlh_lock();
	err = yas_lis331dlh_measure(data->xyz.v, data->raw.v);
	//yas_lis331dlh_unlock();

	return err;
}
#if DEBUG
static int yas_get_register(uint8_t adr, uint8_t *val)
{
	if (pcb == NULL)
		return YAS_ERROR_NOT_INITIALIZED;

	/* Check initialize */
	if (acc_data.initialize == 0)
		return YAS_ERROR_NOT_INITIALIZED;

	*val = yas_lis331dlh_read_reg_byte(adr);

	return YAS_NO_ERROR;
}
#endif
/* -------------------------------------------------------------------------- */
/*  Global function                                                           */
/* -------------------------------------------------------------------------- */
int yas_acc_driver_init(struct yas_acc_driver *f)
{
	struct yas_acc_driver_callback *cbk;

	/* Check parameter */
	if (f == NULL)
		return YAS_ERROR_ARG;	

	cbk = &f->callback;
	//if (cbk->device_open == NULL ||
	    //cbk->device_close == NULL ||
	    //cbk->device_write == NULL ||
	    //cbk->device_read == NULL ||
	    //cbk->msleep == NULL)
		//return YAS_ERROR_ARG;
		
	/* Clear intialize */
	yas_lis331dlh_term();

	/* Set callback interface */
	cb.callback = *cbk;

	/* Set driver interface */
	f->init = yas_init;
	f->term = yas_term;
	f->get_delay = yas_get_delay;
	f->set_delay = yas_set_delay;
	f->get_offset = yas_get_offset;
	f->set_offset = yas_set_offset;
	f->get_enable = yas_get_enable;
	f->set_enable = yas_set_enable;
	f->get_filter = yas_get_filter;
	f->set_filter = yas_set_filter;
	f->get_filter_enable = yas_get_filter_enable;
	f->set_filter_enable = yas_set_filter_enable;
	f->get_position = yas_get_position;
	f->set_position = yas_set_position;
	f->measure = yas_measure;
#if DEBUG
	f->get_register = yas_get_register;
#endif
	pcb = &cb;

	return YAS_NO_ERROR;
}
