plastikpamaro/bachelorprojekt2020/Codes/Code_6.6_unaufgeräumt/main.cpp

/*
 * To change this license header, choose License Headers in Project Properties.
 * To change this template file, choose Tools | Templates
 * and open the template in the editor.
 */

/* 
 * File:   main.cpp
 * Author: Max
 *
 * Created on 16. Oktober 2020, 14:46
 */

#include <cstdlib>
#include <iostream>
#include <stdio.h>
#include <unistd.h>
#include <fcntl.h>
#include <time.h>
#include <stdint.h>
#include <sys/types.h>
#include <sys/stat.h>
#include <errno.h>
#include <stdlib.h>
#include <string.h>
#include <stdbool.h>

#include "utils.h"
#include "bangDetector.h"
#include "input_pipe.h"
#include "doaV2.h"
#include "cameraControl.h"


using namespace std;


#define BUFFER_LENGTH       1064
#define NUM_OF_BYTES_VALUE  4
#define NUM_OF_MIC          6
#define NUM_OF_VALUES       NUM_OF_MIC + 1 //n mic plus one timestamp
#define TRUE                1
#define FALSE               0
#define NUM_TO_READ_ONES    (NUM_OF_BYTES_VALUE*NUM_OF_VALUES)
#define BUFFER_MULTI        2
//#define DEBUG


int32_t bufMic[NUM_OF_MIC][BUFFER_LENGTH*BUFFER_MULTI] = {{0}}; // global is the simple version
double mic0Analyse[1024*BUFFER_MULTI] = {0};
int32_t tempbufMic = 0;                             //Ermittlung höchster Pegel

void fastAddValue(int32_t value, int micNum){
    memcpy(bufMic[micNum], bufMic[micNum]+1, (BUFFER_LENGTH-1*BUFFER_MULTI)*NUM_OF_BYTES_VALUE);
    bufMic[micNum][BUFFER_LENGTH-1*BUFFER_MULTI] = value;
}

int32_t convertToSigned(uint32_t inputUnsigned){
    // converting unsigned to singed
    int32_t signedValue = inputUnsigned << 8;
    return (signedValue >> 8);    
}

void updateValues(int numToUpdate, int* pipe_filestream){
    int counter = 0;
    int micPos = 0;
    uint32_t rxBuf[NUM_OF_VALUES] = {0};
    while (counter < (numToUpdate*7)){
        // read maximum of one measurement cycle
        int numOfRead = read(*pipe_filestream,(void*)rxBuf,28);
        counter = counter + numOfRead/NUM_OF_BYTES_VALUE;
        for(int i=0; i<numOfRead/NUM_OF_BYTES_VALUE; i++){
            if (micPos > 0) {
                fastAddValue(convertToSigned(rxBuf[i]),micPos-1);
                //fastAddValue(rxBuf[i],micPos-1);
            }
            micPos++;
            if (micPos >= NUM_OF_VALUES){
                micPos = 0;
            }
        }
    }
}

void getDataForSoundDetect(){   
    for (int i=0; i<1024*BUFFER_MULTI; i++){
        //if(bufMic[0][i] < 5000000){  //filtert Peaks heraus
            mic0Analyse[i] = bufMic[1][i];       
        //}  
    }    
    //return &mic0Analyse;
}



int main(int argc, char** argv) {
    
    //load precalculated comparioson Values
    char path[] = "/home/pi/Documents/Studienarbeit19_2/Studienarbeit/RASPI/precalValues.conf";
    doaV2 direction(path);
    cameraControl cameraControl;
    
//    uint32_t testA = 1523486785;
//    uint32_t testB = 1781596;
//    uint64_t result = uint64_t(testA) * uint64_t(testB);
//    printf("%i %i\n %lld\n", testA, testB, result);
//    
     // open pipe
    int pipe_filestream = -1;
    create_pipe(&pipe_filestream);
    bangDetector detector;
    
    int blind = 10; //to disable bang detector for a short period of time
    
    float zeit, zeit_gesamt;
    clock_t start, ende, start_gesamt, ende_gesamt;
    start = clock();
    
    

    int counter = 300;
    
    cout << "\n\n############## Strating observation #################\n\n" <<endl;
    while (counter){
        updateValues(1024*BUFFER_MULTI,&pipe_filestream);
        detector.processFFT(mic0Analyse);
        getDataForSoundDetect();
        
        if(detector.checkForBang(mic0Analyse) && (blind < 1)){
            cout<<"Event erkannt"<<endl;
            start = clock();
            start_gesamt = clock();
            int result = direction.getAngle(bufMic[0],bufMic[1],bufMic[2],bufMic[3],bufMic[4],bufMic[5],BUFFER_LENGTH*BUFFER_MULTI);
            cout <<"Winkel des Events: "<<result<<"°"<<endl;
            ende = clock();
                //Ergebniss der Laufzeitmessung in Sekunden
            zeit = (float)(ende-start) / (float)CLOCKS_PER_SEC;
            cout<<"Dauer der Berechnung:"<<zeit<<endl;
            
            blind = 8;               //um ein Widerhall des Geräusches zu ignorieren
                if(result >= 320 || result <= 40){
                    cameraControl.takePicture();
                    cameraControl.editPicture(result);
                    ende_gesamt = clock();
                    cout<<"Event war im Bildbereich"<<endl;
                }else{
                    cout<<"Event war NICHT im Bildbereich"<<endl;
                    ende_gesamt = clock();
                }
            zeit_gesamt = (float)(ende_gesamt-start_gesamt) / (float)CLOCKS_PER_SEC;
            cout<<"Dauer vom Event bis zum Bild:"<<zeit_gesamt<<endl;
            cout<<"---------------Neue Messung---------------"<<endl;
            }
/*
        for (int i=0; i<1024*BUFFER_MULTI; i++){
            if(bufMic[0][i] < 5000000){ //filtert Peaks heraus, getesteter Wert bei mir in der Wohnung
                if(bufMic[0][i] > tempbufMic){
                    tempbufMic = bufMic[0][i];
                }
            }     
        }*/
/*
        if (detector.checkForBang(mic0Analyse) && (blind < 1)){
            for (int j=0; j<NUM_OF_MIC; j++){
                for (int i=2; i<BUFFER_LENGTH;i++){
                    if(abs(bufMic[j][i]) > 6500000){
                        bufMic[j][i] = (bufMic[j][i+1]+bufMic[j][i+2]+bufMic[j][i-1]+bufMic[j][i-2])/4;
                    }
                }
            }
            */            
#ifdef DEBUG
            char path[] = "/home/pi/mic0.csv";
            writeResult(bufMic[0],BUFFER_LENGTH,path);
            char patha[] = "/home/pi/mic1.csv";
            writeResult(bufMic[1],BUFFER_LENGTH,patha);
            char pathb[] = "/home/pi/mic2.csv";
            writeResult(bufMic[2],BUFFER_LENGTH,pathb);
            char pathc[] = "/home/pi/mic3.csv";
            writeResult(bufMic[3],BUFFER_LENGTH,pathc);
            char pathd[] = "/home/pi/mic4.csv";
            writeResult(bufMic[4],BUFFER_LENGTH,pathd);
            char pathe[] = "/home/pi/mic5.csv";
            writeResult(bufMic[5],BUFFER_LENGTH,pathe);
#endif
            /*printf("Bang -");
            int result = direction.getAngle(bufMic[0],bufMic[1],bufMic[2],bufMic[3],bufMic[4],bufMic[5],BUFFER_LENGTH);
            printf(" Angel of attack: %d°\n",result);

            
            //blind = 10;
#ifdef DEBUG
            //counter--;
#endif
        //*/
        blind--;
        if(blind < -100){
            blind = 0;
        }//cout<<tempbufMic<<endl;
        //printf("Test\n");
        //char pathc[] = "/home/pi/mic0.csv";
        //writeResult(bufMic[0],BUFFER_LENGTH,pathc);
        //counter--; 
    }printf("maximaler Schalldruck von: %d\n", tempbufMic);  
        
 
    
   
      
        
    /* cplx L = 1024;
     double output[1024] = {0};
     for(int i=0; i<1024; i++){
         output[i] = cabs(buf[i]/L);
     }*/

      
        
    


    
    
    return 0;
}
