plastikpamaro/bachelorprojekt2020/Codes/Studienarbeit(Max)/RASPI/Backup 02-14/firtsteps/MSM_SPI_Read_24bit.c

/*
 * 
 * 	Stereo Demo with just two microphones.
 * 
 * 
 * TODO
 * add second chip select
 * 
 * 
 */

#include <bcm2835.h>
#include <stdio.h>
#include <stdlib.h>
#include <unistd.h>
#include <stdint.h>
#include <string.h>
#include <errno.h>
#include <time.h>    
//#include <fcntl.h>
//#include <sys/ioctl.h>
//#include <linux/spi/spidev.h>

//#include <wiringPi.h>
//#include <wiringPiSPI.h>

#define	TRUE	(1==1)
#define	FALSE	(!TRUE)

//#define SPI_PACKET_BYTES	17
#define BYTES_PER_CHANNEL	8			//because of 24 Bit data
#define SAMPLE_RATE		48000

#define NUM_TO_COLLECT		348000 //8 seconds
#define NUM_MICROPHONES		1


//#define DEBUG

uint16_t convertFrom8To16 (uint8_t dataFirst, uint8_t dataSecond) {
    uint16_t dataBoth = 0x0000;

    dataBoth = dataFirst;
    dataBoth = dataBoth << 8;
    dataBoth |= dataSecond;
    return dataBoth;
}

uint32_t convertFrom8To24 (uint8_t dataFirst, uint8_t dataSecond, uint8_t dataThird) {
    uint32_t dataAll = 0x00000000;

    dataAll = (dataFirst<<16) | (dataSecond<<8) | (dataThird);
    return dataAll;
}

uint32_t convertFrom8To24special (uint8_t dataFirst, uint8_t dataSecond, uint8_t dataThird, uint8_t dataForth) {
    uint32_t dataAll = 0x00000000;

    dataAll = (dataFirst<<18) | (dataSecond<<10) | (dataThird<<2) | (dataForth>>6);
    return dataAll;
}




int main (int argc, char** argv){
	printf("pre init \n");
	time_t nowtime;
	struct tm *today;  
	char buffer [30];
	char date[9];
	
	printf("pre init \n");
	uint64_t sample_time = 1000000/SAMPLE_RATE;
	uint32_t sample_rate = SAMPLE_RATE;
	unsigned int first_time = 1, samples = 50000, sample_timer = sample_time;
	uint32_t ii=0, jj=0, sample_cnt_collect=0;
	uint64_t start_time, end_time, now[NUM_TO_COLLECT], time_now[NUM_TO_COLLECT];
	float samplerate = 0;
	uint8_t buff[4] = {0};
	uint8_t data[NUM_TO_COLLECT][BYTES_PER_CHANNEL*NUM_MICROPHONES] = {{0}};		// 8 is highest possible TDM mode
	int32_t data_channel[NUM_MICROPHONES] = {0};									// with TDM8 and 6 TDM_master up to 48 microphones are possible
	int32_t data_channel2[NUM_MICROPHONES] = {0};
	FILE *output_file = 0;
	struct tm *t = 0;
	
	printf("init done\n");

	// Configure measurement according to input parameters
	if (argc < 2) {
        fprintf(stderr, "Usage: %s [-fs SAMPLE_RATE]\nFor help use: %s -h\n\n", argv[0], argv[0]);
    }
	
	while (*argv) {
        if (strcmp(*argv, "-fs") == 0) {
            argv++;
            if (*argv)
                sample_rate = atoi(*argv);
				sample_time = 1000000/sample_rate;
        }
        if (strcmp(*argv, "-h") == 0) {
			printf("Usage: [-fs SAMPLE_RATE]\n");
			printf("-fs  : rate at which to record samples - has currently no effect\n");
			return 0;
		}
        if (*argv)
            argv++;
    }

	printf("MSM-Aufnahme (fs = %.2f kHz) wird gestartet...\n\n", (float)sample_rate/1000);



	// SPI Initialization
	if (!bcm2835_init()){
		printf("bcm2835_init failed. Are you running as root?\n");
		return 1;
	}
	bcm2835_spi_begin();
	bcm2835_spi_setBitOrder(BCM2835_SPI_BIT_ORDER_MSBFIRST);    // The default
	bcm2835_spi_setDataMode(BCM2835_SPI_MODE1);                 // The default
	bcm2835_spi_setClockDivider(BCM2835_SPI_CLOCK_DIVIDER_16);	// 128	= 1.953125MHz
																// 64	= 3,9MHz
																// 32	= 7.8125MHz
																// 16	= 15.625MHz <-
																// 8	= 31.25MHz
																// 4	= 62.5MHz
																// 2	= 125MHz (fastest possible)
	bcm2835_spi_chipSelect(BCM2835_SPI_CS0);                    // The default
	bcm2835_spi_setChipSelectPolarity(BCM2835_SPI_CS0 , LOW);   // the default
	
	bcm2835_gpio_fsel(RPI_BPLUS_GPIO_J8_11,BCM2835_GPIO_FSEL_OUTP);
	bcm2835_gpio_clr(RPI_BPLUS_GPIO_J8_11);


	while(1){
		
		start_time = bcm2835_st_read();
		
		// collect data
		while(sample_cnt_collect < NUM_TO_COLLECT){
			
			// Request Data from MSM-Module
			//bcm2835_spi_chipSelect(BCM2835_SPI_CS0);
			bcm2835_spi_chipSelect(BCM2835_SPI_CS_NONE);
			bcm2835_gpio_set(RPI_BPLUS_GPIO_J8_11);
			bcm2835_gpio_clr(RPI_BPLUS_GPIO_J8_11);
			bcm2835_spi_transfern(data[sample_cnt_collect], BYTES_PER_CHANNEL*NUM_MICROPHONES);
			bcm2835_spi_transfern(data[sample_cnt_collect], BYTES_PER_CHANNEL*NUM_MICROPHONES);
			bcm2835_spi_transfern(data[sample_cnt_collect], BYTES_PER_CHANNEL*NUM_MICROPHONES);
			bcm2835_spi_transfern(data[sample_cnt_collect], BYTES_PER_CHANNEL*NUM_MICROPHONES);
			//bcm2835_spi_chipSelect(BCM2835_SPI_CS1);
			//bcm2835_spi_transfern(data2[sample_cnt_collect], BYTES_PER_CHANNEL*NUM_MICROPHONES);
			
			//bcm2835_spi_chipSelect(BCM2835_SPI_CS0);			
			//bcm2835_spi_transfern(data[sample_cnt_collect], BYTES_PER_CHANNEL*NUM_MICROPHONES);
			
			//bcm2835_spi_chipSelect(BCM2835_SPI_CS0);
			//bcm2835_spi_transfern(data2[sample_cnt_collect], BYTES_PER_CHANNEL*NUM_MICROPHONES);

			time_now[sample_cnt_collect] = bcm2835_st_read();
			now[sample_cnt_collect] = time_now[sample_cnt_collect] - start_time;
			
			delayMicroseconds(18);  			//printf("%lu\n",(time_now[sample_cnt_collect]-time_now[sample_cnt_collect-1]));
			//printf("%lu\n",(sample_cnt_collect));
			
/* 			if ((now[sample_cnt_collect]-now[sample_cnt_collect-1]) < (20)){
				//(1/sample_rate)-(now[sample_cnt_collect] -now[sample_cnt_collect-1]));
				//printf("%i\n",(1/sample_rate)-(now[sample_cnt_collect] -now[sample_cnt_collect-1]));

			} */
		
			#ifdef DEBUG
			// output on console to see errors
			printf("%02x", data[0]);
			for(ii=1; ii<(BYTES_PER_CHANNEL*NUM_MICROPHONES); ii++){
				printf(",");
				printf("%02x", data[sample_cnt_collect][ii]);
			}
			printf("\n");
			#endif
			
			sample_cnt_collect++;
		}
		sample_cnt_collect = 0;
		end_time = bcm2835_st_read();
		
		
		//write data to file
		while(sample_cnt_collect < NUM_TO_COLLECT){
			
			// first time: create and writing the file
			if(first_time == 1){
				first_time = 0;
				
				// Create Output File according to time
				nowtime = time(NULL);
				t = localtime(&nowtime);
				strftime( buffer, sizeof(buffer), "data_%d%m%y_%H%M%S.txt", t );
				output_file = fopen(buffer, "w");
				
				if(output_file == 0){
					fprintf (stderr, "Can't create output file: %s\n", strerror (errno));
					exit (EXIT_FAILURE); 
				}
		
				fprintf(output_file, "%lu\n",start_time);
				for(ii=0; ii<(NUM_MICROPHONES); ii++){
					fprintf(output_file, "ch%u, ch%u, ", ii,ii+1);
				}
				fprintf(output_file, "us\n");
			}
			
			// convert single byte to 24 bit data
			jj = 0;
			for(ii=0; ii<(NUM_MICROPHONES); ii++){
				data_channel[ii] = convertFrom8To24special(data[sample_cnt_collect][jj+4], data[sample_cnt_collect][jj+5], data[sample_cnt_collect][jj+6], data[sample_cnt_collect][jj+7]);
				
				data_channel2[ii] = convertFrom8To24(0,0,0);//data2[sample_cnt_collect][jj], data2[sample_cnt_collect][jj+1], data2[sample_cnt_collect][jj+2]);
				
				jj += 3;
			}
						
			// write file
			for(ii=0; ii<(NUM_MICROPHONES); ii++){
				// fprintf(output_file, "%i, ", data_channel[ii]);
				// fprintf(output_file, "%i, ", data_channel2[ii]);
				fprintf(output_file, "%i,%i,", data_channel[ii], data_channel2[ii]);

			}
			fprintf(output_file, "%lu\n", now[sample_cnt_collect]);
			
			sample_cnt_collect++;
			
		}
		sample_cnt_collect = 0;
		first_time = 1;
		
		fclose(output_file);
		output_file = 0;
		t = 0;
	}
	
	/*
	bcm2835_spi_end();
	bcm2835_close();
	*/
	
	return 0;
}
