plastikpamaro/bachelorprojekt2020/21-02-19-Kickoff/Studienarbeit/uC Code/MSM_TDM/MultisensorBoard/src/filter_design-LAPTOP-SEQVLDEN.h

/*
 * filter_design.h
 * 
 * Created on: 30.10.2019
 * Author: J. Sebastian Frisch
 * 
 */

#ifndef FILTER_DESIGN_H
#define FILTER_DESIGN_H

#include <stdint.h>

void filter(uint16_t *input_data, uint16_t *output_data);

#endif
