plastikpamaro/bachelorprojekt2020/Codes/Code_6.6_unaufgeräumt/fft.c

/*
 * To change this license header, choose License Headers in Project Properties.
 * To change this template file, choose Tools | Templates
 * and open the template in the editor.
 */

/* 
 * File:   fft.c
 * Author: Max
 * 
 * Created on 13. Oktober 2020, 10:22
 */

#include "fft.h"

#include <stdio.h>
#include <math.h>


void _fft(cplx buf[], cplx out[], int n, int step)
{
	if (step < n) {
		_fft(out, buf, n, step * 2);
		_fft(out + step, buf + step, n, step * 2);
 
		for (int i = 0; i < n; i += 2 * step) {
			cplx t = cexp(-I * M_PI * i / n) * out[i + step];
			buf[i / 2]     = out[i] + t;
			buf[(i + n)/2] = out[i] - t;
		}
	}
}
 
void fft(cplx buf[], int n)
{
	cplx out[n];
	for (int i = 0; i < n; i++) out[i] = buf[i];
 
	_fft(buf, out, n, 1);
}
