plastikpamaro/bachelorprojekt2020/(commit log)

2020-10-21 Zusammenfassung der Aufgabenstellung und Vorbereotung auf das Meeting am 22.10. im Dokument ergänzt
2020-10-21 Create Lastenheft.docx
    hier die datei für mich zum üben
2020-10-21 Delete gtest-all.cc
    und wieder gelöscht
2020-10-22 Create Notiz vom 22.10..pdf
    hier die notiz vom meeting
2020-10-23 Fotos und Kommentar zum Anckelmannsplatz, Titelseite und Impressum nach Vorgabe von Prof. eingebaut
2020-11-02 Create Lastenheft.docx
    ich habe den Ordner Dokumentenschleuse angelegt um dort die Sachen rein zu legen, wechle es in die Doku schaffen könnten...euer einverständnis natürlich vorraus gesetzt
2020-11-09 Create Pflichtenheft.docx
    Hier der Entwurf...ist noch nicht ganz fertig
2020-11-12 Update Pflichtenheft.docx
    die Grammatik noch einmal grade gezogen
2020-11-20 psp hingeklatscht
2020-11-20 Statusbericht bis auf Teambarometer und Risikoanalyse abgeschlossen
    [20-11-20_Gantt_Chart.xlsx]
2020-11-20 barometer hingeklatscht
    [20-11-20_Barometer.xlsx]
2020-11-22 Barograph fertig
    [20-11-20_Barometer.xlsx]
2020-11-23 Final state Status Bericht 1
    [20-11-20_Barometer.xlsx]
2020-12-11 Schaltplan Raspberry Mikrophone
2020-12-11 Dies und das
2020-12-13 max ordner hochgeladen
    [2.54 mm DUPONT MALE PIN HEADER, IO, 2X20, RPi4ModelB.SLDPRT, 2.54 mm DUPONT MALE PIN HEADER, IO, 2X20, RPi4ModelB.ipt, 2.54 mm DUPONT MALE PIN HEADER, IO, 2X40, RPi4ModelB.SLDPRT, 2.54 mm DUPONT MALE PIN HEADER, POE, 2X2, RPi4ModelB.SLDPRT, 2.54 mm DUPONT MALE PIN HEADER, POE, 2X2, RPi4ModelB.ipt, 2X USB2.0 PORTS, RPi4ModelB.SLDPRT, 2X USB2.0 PORTS, RPi4ModelB.ipt, 2X USB3.0 PORTS, RPi4ModelB.SLD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]
2020-12-13 deleted alles
    [2.54 mm DUPONT MALE PIN HEADER, IO, 2X20, RPi4ModelB.SLDPRT, 2.54 mm DUPONT MALE PIN HEADER, IO, 2X20, RPi4ModelB.ipt, 2.54 mm DUPONT MALE PIN HEADER, IO, 2X40, RPi4ModelB.SLDPRT, 2.54 mm DUPONT MALE PIN HEADER, POE, 2X2, RPi4ModelB.SLDPRT, 2.54 mm DUPONT MALE PIN HEADER, POE, 2X2, RPi4ModelB.ipt, 2X USB2.0 PORTS, RPi4ModelB.SLDPRT, 2X USB2.0 PORTS, RPi4ModelB.ipt, 2X USB3.0 PORTS, RPi4ModelB.SLD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]
2020-12-14 @Marc CAD Ordner ist ausschließlich deine Baustelle.
    [GehauseteilC.0036.ipt, GehauseteilC.ipt, GehauseteilC.newVer.ipt, Mikrofonboard.0004.ipt, Mikrofonboard.0006.ipt, Mikrofonboard.ipt, Mikrofonboard.newVer.ipt, Prozessorboard.0003.ipt]
2020-12-14 Schlüsseldokument
    [20-11-20_Barometer.xlsx]
2020-12-29 Gehäuse für die Mikros
    [Gehäuse v9.step]
2021-01-03 Create Gehäuse v11.step
    [Gehäuse v11.step]
2021-01-03 Statusbericht 2
    [20-11-20_Barometer.xlsx, 20-11-20_Gantt_Chart.xlsx]
2021-01-08 alles von max
    [2.54 mm DUPONT MALE PIN HEADER, IO, 2X20, RPi4ModelB.SLDPRT, 2.54 mm DUPONT MALE PIN HEADER, IO, 2X20, RPi4ModelB.ipt, 2.54 mm DUPONT MALE PIN HEADER, IO, 2X40, RPi4ModelB.SLDPRT, 2.54 mm DUPONT MALE PIN HEADER, POE, 2X2, RPi4ModelB.SLDPRT, 2.54 mm DUPONT MALE PIN HEADER, POE, 2X2, RPi4ModelB.ipt, 2X USB2.0 PORTS, RPi4ModelB.SLDPRT, 2X USB2.0 PORTS, RPi4ModelB.ipt, 2X USB3.0 PORTS, RPi4ModelB.SLD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]
2021-01-11 Finale Überabreitung des Statusberichts 2
    [20-11-20_Gantt_Chart.xlsx]
2021-01-18 Create Motor 43048424 v1.step
    [Motor 43048424 v1.step]
2021-02-23 Überarbeitung AMax
    [Mappe2.csv, Mappe2.xlsx, testmessung_22_02_signed.csv]
2021-03-02 stand 2.3.21
    [Gehäuse v12.step, Motor 43048424 v1.step]
2021-03-03 Boden und Deckel separat als STL
    [Boden_STL.stl, Deckel_STL.stl]
2021-03-09 update cad gehäuse
    [Boden_21_03_09.stl, Deckel_21_03_09.stl]
2021-03-16 Ein paar Änderungen und eine neue Version (v2) des Gehäuses, welches jetzt zusammen geklippt werden kann. Das Bord soll mit 4 Schrauben + Scheibe an dem Unterteil verschraubt werden.
    [Boden_21_03_09.stl, Boden_STL.stl, Boden_v2_21_03_16.stl, Deckel_21_03_09.stl, Deckel_STL.stl, Deckel_v2_21_03_16.stl, Gehäuse 2 v5.step, Gehäuse v11.step]
2021-03-17 Und schon wieder ein Update;-)
    [Boden_v3_21_03_17.stl, Deckel_v3_21_03_17.stl]
2021-03-17 das letzte update war leider noch nicht ganz so wie es sein sollte
    [Boden_v3_21_03_17.stl, Deckel_v3_21_03_17.stl]
2021-03-17 neues update
    [Boden_21_03_17.stl, Deckel_21_03_17.stl]
2021-03-18 kleine änderung von deckel und boden
    [Boden_21_03_18.stl, Deckel_21_03_18.stl]
2021-03-23 mehr cad
2021-04-10 Create Bodenplatte v6.step
    Für Heiko zum spielen
    [Bodenplatte v6.step]
2021-04-14 sr
    adrz
    [Bodenplatte(1:2).stl, Bodenplatte(2:2).stl]
2021-04-14 vxbfh
    gelöscht
    [Bodenplatte(1:2).stl, Bodenplatte(2:2).stl]
2021-04-14 geht jetzt drucken;-)
    ich habe die alten "geschnittenen" sachen gelöscht! jetzt ist alles von heute und damit auf dem selben stand
    [Abdeckplatte Powerbank.stl, Abdeckplatte_Powerbank_v1.stl, Bodenplatte v6.step, Bodenplatte_oben.stl, Bodenplatte_unten.stl, Bodenplatte_v1.stl, Halter Powerbank neu.stl, Halter_Powerbank_v1.stl]
2021-04-22 fix1 for cameracontrol
    weil ich dumm bin
    [cameraControl.cpp]
2021-04-22 fix2 for camera control
    sorry für meine dummheit
    [cameraControl.cpp]
2021-05-18 Aufteilung der Dokuverantwortung und Inhalt der Doku
2021-06-01 es fehlt noch die Umgebungssitaution. Rest von Marc und Heiko ist done
2021-06-03 Doku: Marcs und Heikos Anteil fertig zum gemeinsamen Probelesen. Es fehlt der Programmirungsteil von Pascal und Philipp
2021-06-14 Doku: Einpfelgen Pascal komplett, Beweisfühurung, Testbeschreibungen. Es fehlt noch: Tests und Bedienungsanleitung
2021-06-21 Doku: Thats itgit statusgit status Bitte alle Datein (CAD, Programme etc.) in den Abgabeordner packen bevorgit status wir in das Meeting mit Rettig gehen, damit wir ihm dannach alles übergeben können
